Brico-Hams/bricohams-sdr/files/htdocs/plugins/receiver/antenna_switcher/README.md

---
layout: page
title: "OpenWebRX+ Receiver Plugin: Antenna Switcher"
permalink: /receiver/antenna_switcher
---

This is a `receiver` plugin to add antenna switching functionality for Raspberry Pi devices, providing logical levels on their GPIO ports that correspond to the user's antenna selection via buttons on the OWRX's front-end.

The antenna buttons appear in a collapsible **Antenna** section in the receiver panel after the back-end reports how many antennas are available. On OpenWebRX+ versions with `Plugins.addSection()`, the plugin uses the built-in section API. On older versions, it creates the same section itself. The selected antenna stays highlighted, and the section's open/closed state is kept when upgrading to the built-in section.

It consists of a **front-end** and **back-end** part.

The front-end is a standard OpenWebRX+ plugin and its installation does not differ from the standard way you [install plugins](https://0xaf.github.io/openwebrxplus-plugins/#beginner-quickstart):

## I. Front-end installation

### Load

Add this line in your `init.js` file:

```js
Plugins.load('https://0xaf.github.io/openwebrxplus-plugins/receiver/antenna_switcher/antenna_switcher.js');
```

#### Back-end URL

You probably don't want to change the default back-end instance URL, but if you do want to, you can do it from `init.js`, before or after the plugin loading, with:

`Plugins.antenna_switcher.API_URL = 'HOST:PORT/antenna_switch'`

### init.js

Learn how to [load plugins](https://0xaf.github.io/openwebrxplus-plugins/#beginner-quickstart).

## II. Back-end installation

The back-end installation script **is designed to work with OpenWebRX+ installed from the repository as a package**. You need to adjust it in case you want to use it inside a Docker container.

For the back-end, download and run the [install_backend.sh](install_backend.sh) Bash script **as root**:

```sh
wget 'https://0xaf.github.io/openwebrxplus-plugins/receiver/antenna_switcher/install_backend.sh'
chmod +x ./install_backend.sh
sudo ./install_backend.sh
```

The script will download and install the Flask back-end in a Python virtual environment located in `/opt/antenna_switcher`, so you don't have to worry about libraries messing up your system's default Python installation.

It will also create a systemd service file called `antenna_switcher`, then start and enable it.

The nginx configuration will be extended to provide reverse proxying from the OpenWebRX front-end *(default port 8073)* to the Flask back-end *(port 8075, binding only on 127.0.0.1)*.

## Configuration

Things like which GPIO pins to raise high when the corresponding button from the front-end is selected can be configured in `/opt/antenna_switcher/antenna_switcher.cfg`.

```sh
sudo ${EDITOR-nano} /opt/antenna_switcher/antenna_switcher.cfg
```

## Using the plugin

**You should open `http://1.2.3.4/` (nginx server) and NOT use the `:8073` (openwebrx) port in the URL. (Obviously you should replace 1.2.3.4 with the IP address of your OWRX receiver)**

## Code

[Github repo](https://github.com/0xAF/openwebrxplus-plugins/tree/main/receiver/antenna_switcher)
