Brico-Hams/bricohams-sdr/files/htdocs/plugins/receiver/doppler/README.md

---
layout: page
title: "OpenWebRX+ Receiver Plugin: Doppler"
permalink: /receiver/doppler
---

This `receiver` plugin will track the Doppler shift frequency of a chosen satellite. Useful for SSTV/Packet.

The Sat ID and TRACK/STOP controls appear in a collapsible **Doppler** section on OpenWebRX+ versions with `Plugins.addSection()`. Satellite Finder uses the built-in resizable plugin window when `Plugins.addWindow()` and `Plugins.toggleWindow()` are available. Older versions keep the original receiver row and Finder dialog. Closing Finder stops its automatic five-second refresh but does not stop active Doppler tracking.

This plugin started as a port of [work](https://github.com/studentkra/OpenWebRX-Doppler) by [Sergey Osipov](https://github.com/studentkra).  
Then I switched to [CelesTrak JSON API](https://celestrak.org/) and created Satellite Finder modal window.

## Preview

doppler Preview

## Usage

 1. Open the Satellite finder window to choose a satellite or enter the SatID if you know it.
 2. Click TRACK.

The Satellite Finder window will help you find a satellite and will give useful information on each satellite.
doppler1 FindSat

## Load

Add this line in your `init.js` file:

```js
Plugins.load('https://0xaf.github.io/openwebrxplus-plugins/receiver/doppler/doppler.js');
```

## init.js

Learn how to [load plugins](https://0xaf.github.io/openwebrxplus-plugins/#beginner-quickstart).

## Code

[Github repo](https://github.com/0xAF/openwebrxplus-plugins/tree/main/receiver/doppler)
