Brico-Hams/bricohams-sdr/files/htdocs/plugins/receiver/toggle_scannable/README.md

---
layout: page
title: "OpenWebRX+ Receiver Plugin: ToggleScannable"
permalink: /receiver/toggle_scannable
---

This `receiver` plugin will allow you to **toggle the scannable state of the bookmarks with right mouse button**.

The scanner (enabled by right-clicking the SQ button on the left of the SQL slider) will scan only the enabled bookmarks.

## Preview

toggle_scannable Preview

## Load

Add this line in your `init.js` file:

```js
Plugins.load('https://0xaf.github.io/openwebrxplus-plugins/receiver/toggle_scannable/toggle_scannable.js');
```

## init.js

Learn how to [load plugins](https://0xaf.github.io/openwebrxplus-plugins/#beginner-quickstart).
