Brico-Hams/bricohams-sdr/docs/REFERENCIAS.md

# Referencias

## Hardware
- HAT HackerGadgets RTL-SDR/LoRa/GPS/RTC: https://hackergadgets.com/products/rtl-sdr-lora-gps-rtc-hat-for-raspberry-pi
- Guía de la placa AIO de HackerGadgets (origen de los pines A VERIFICAR): https://hackergadgets.com/pages/hackergadgets-uconsole-rtl-sdr-lora-gps-rtc-usb-hub-all-in-one-extension-board-setup-guide
- Mini RTL-SDR HackerGadgets: https://hackergadgets.com/products/mini-rtl-sdr-dongle
- RTL-SDR Blog V3 (muestreo directo, bias-tee): https://www.rtl-sdr.com/v4/ · driver https://github.com/rtlsdrblog/rtl-sdr-blog
- Whadda/Velleman WPI408: https://www.velleman.eu/products/view/modulo-de-camara-con-2-luces-ir-para-raspberry-pi-wpi408/?id=459182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
- Bosch BMP280 / BME280: hojas de datos (compensación §3.12 / §4.2.3 y §8.1)
- LX-LBU2C: https://www.tastethecode.com/power-bank-from-scratch-with-18650-batteries-and-lx-lbu2c
- LilyGO T3 V1.6.1 (LoRa32 V2.1_1.6): firmware Meshtastic `tlora-v2-1-1_6`

## Software
- OpenWebRX+ (paquetes): https://luarvique.github.io/ppa/ · documentación https://fms.komkon.org/OWRX/
- Plugins 0xAF: https://0xaf.github.io/openwebrxplus-plugins/ · rig_skin: https://github.com/aganet/openwebrxplus-rig-skin
- Referencia de bandas: OpenWebRX+ de EA7CL, http://ea7cl.duckdns.org:8073/
- meshtasticd en Debian: https://meshtastic.org/docs/software/linux/installation/debian · flasher: https://flasher.meshtastic.org
- LoRa APRS iGate (CA2RXU): https://github.com/richonguzman/LoRa_APRS_iGate
- readsb y tar1090 (wiedehopf): https://github.com/wiedehopf/adsb-scripts · https://github.com/wiedehopf/tar1090
- AirNav RadarBox en Raspberry Pi: https://www.airnavradar.com/raspberry-pi/guide
  - Bookworm + MLAT: https://forum.airnavradar.com/index.php?topic=107991.0
  - **Trixie** (rbfeeder por apt y mlat-client compilado): https://forum.airnavradar.com/index.php?topic=109561.0
- MediaMTX (rpiCamera): https://github.com/bluenviron/mediamtx
- SDRplay API: https://www.sdrplay.com/api/
- AEMET OpenData: https://opendata.aemet.es · Open-Meteo: https://open-meteo.com · NOAA SWPC: https://www.swpc.noaa.gov

## Datos de la estación
- Repetidores: lista de EA5RCZ en los marcadores; Sierra Espuña ED5ZAN (BrandMeister ID 214520): https://ea5gvk-dmr.zigor.es/2019/09/10/ya-tenemos-nuevamente-repetidor-dmr-brandmeister-en-murcia-ed5zan-sierra-espuna/
- Estaciones AEMET: Archena 7158X, Molina de Segura (Los Valientes) 7237E, Alcantarilla Base Aérea 7228, Murcia 7178I
- Canales Meshtastic: QR de la red aportado por N0CALL (04/10/2026), en `MESH_CHANNEL_URL`

## Caja y alimentación (v2.2)
- OpenSCAD (modelo de la caja): https://openscad.org/documentation.html
- Raspberry Pi 5, alimentación y límite de corriente USB (5 V 5 A frente a 3 A): https://www.raspberrypi.com/documentation/computers/raspberry-pi.html#power-supply
- NetworkManager, `nmcli connection add` (prioridad de autoconexión): https://networkmanager.dev/docs/api/latest/nmcli.html

## v3.0 · Antenas, caja v3, ventilación, viento y lluvia
- **NEC2 (`nec2c`)**, motor de simulación de los modelos de `hardware/antenas/sim/`: paquete `nec2c` de Debian. Los documentos de diseño originales de la cúbica y del diplexor no se incluyen en esta distribución pública.
- **SDRplay RSPdx-R2:**
  - datasheet: https://sdrplay.com/wp-content/uploads/2026/06/RSPdxR2_Datasheet.pdf
  - ficha y precio: https://www.passion-radio.com/sdr-receivers/rsp-dx-935.html
- **HydraSDR RFOne** (24–1800 MHz, sin HF), datasheet: https://hydrasdr.com/downloads/HydraSDR_RFOne_Datasheet.pdf
- **OpenWebRX+:**
  - changelog (dispositivos admitidos: SDRplay, HydraSDR, RX888/sddc): https://github.com/luarvique/openwebrx/releases/
  - PPA: https://luarvique.github.io/ppa/
- **Raspberry Pi 5:**
  - PWM por hardware (overlay `pwm-2chan`, PWM0 del RP1 en GPIO12/13): https://gist.github.com/Gadgetoid/b92ad3db06ff8c264eef2abf0e09d569
  - foro: https://forums.raspberrypi.com/viewtopic.php?t=362319
- **Camera Module 3 (Wide NoIR, IMX708):** https://datasheets.raspberrypi.com/camera/camera-module-3-product-brief.pdf
- **Reolink RLC-510A** (cámara IP PoE con RTSP): https://reolink.com/product/rlc-510a/
- **MLA-30, manual de usuario:** https://www.tecsunradios.com.au/store/wp-content/uploads/2021/09/MLA-30-User-Instructions.pdf · https://www.passion-radio.com/hf/megaloop-968.html
- **Filtros NMRF FBP-433s:** https://www.amazon.co.uk/FBP-433s-433MHz-bandpass-filter-bandwidth/dp/B0FQ2KYRJG
- **Regleta Vansuny USB 3.0 con alimentador de 12 V 2 A (ASIN B09Q2YC87C):** https://www.amazon.es/Vansuny-Alimentacion-Externa-Ladron-Velocidad/dp/B09Q2YC87C
- **Estación WX LoRa de CA2RXU** (antes «APRS_WX_REPORT_STATION»): https://github.com/richonguzman/LoRa_APRS_Wx_Station
- **Sensores de viento RS485 Modbus** (registro de datos 0x0000, dirección en 0x07D0):
  - https://wiki.dfrobot.com/RS485_Wind_Direction_Transmitter_SKU_SEN0482
  - https://wiki.dfrobot.com/RS485_Wind_Speed_Transmitter_SKU_SEN0483
  - https://devices.esphome.io/devices/renke-rs-fxjt-n01-wind-direction/
- **Formato APRS WX** (`_CCC/SSSgGGGtTTTrRRRpPPPPPPPhHHbBBBBB`): APRS Protocol Reference 1.0.1, cap. 12.
- **Wifon FM** (97,5 MHz, Murcia): https://wifonfm.es/
- **Repetidores EA5:** lista EA5KGV del proyecto, distribuida en `data/repetidores_EA5KGV_zonaEA5.csv`.

## v3.1 · Trixie
- **Repositorio de OpenWebRX+ por versión:** `bookworm/` y `trixie/`, Release firmado. Página: https://luarvique.github.io/ppa/ · Repositorio: https://github.com/luarvique/ppa
- **meshtasticd en Debian 13:** https://meshtastic.org/docs/meshtasticd/installation/debian/
- **MediaMTX rpiCamera** (admite Trixie y Bookworm): https://mediamtx.org/docs/publish/raspberry-pi-cameras

## v4.0
- **Pico y MicroPython (rp2):** https://docs.micropython.org/en/latest/rp2/quickref.html · pinout: https://datasheets.raspberrypi.com/pico/Pico-R3-A4-Pinout.pdf · mpremote: https://docs.micropython.org/en/latest/reference/mpremote.html
- **Cámara Waveshare RPi Camera (F):** https://www.waveshare.com/wiki/RPi_Camera_(F) · cable de la Pi 5: https://www.raspberrypi.com/products/camera-cable/ · cámaras en la Pi 5: https://www.raspberrypi.com/documentation/accessories/camera.html
- **Estación WX LoRa de CA2RXU (pines y firmware):** https://github.com/richonguzman/LoRa_APRS_Wx_Station
- **Sensores de viento Renke RS485:** https://www.renkeer.com/
- **0xAF plugins (doppler, show_band_plan, listeners):** https://github.com/0xAF/openwebrxplus-plugins
- **Pases de satélites:** CelesTrak GP/OMM https://celestrak.org/NORAD/documentation/gp-data-formats.php · python-sgp4 https://pypi.org/project/sgp4/
- **SatDump:** https://github.com/SatDump/SatDump · METEOR-M LRPT 137,9 MHz.
- **FT2 / Decodium:** https://github.com/iu8lmc/Decodium-3.0-Codename-Raptor · https://ft2.it/
- **Indicativos:** HamQTH API https://www.hamqth.com/developers · RadioID https://radioid.net/api · QRZ XML https://www.qrz.com/docs/xml/current_spec.html
- **GeoIP:** DB-IP IP to City Lite (CC BY 4.0) https://db-ip.com/db/download/ip-to-city-lite — la web lleva la atribución.
- **Telegram Bot API:** https://core.telegram.org/bots/api
- **Mensajes de clientes de OpenWebRX+ por MQTT:** https://github.com/luarvique/openwebrx
- **https:** Let's Encrypt https://letsencrypt.org/docs/ · certbot https://eff-certbot.readthedocs.io/ · DuckDNS https://www.duckdns.org/
- **Privacidad y registros de visitas:** AEPD https://www.aepd.es/
- **CB 27 MHz (CEPT, 40 canales):** https://www.fediea.org/ · **PMR446:** CEPT ECC/DEC(15)05.
- **Radio Club Región de Murcia (RU-75, frecuencias del club):** https://www.ea5rcz.es/
- **Aviación:** ENAIRE AIP España https://aip.enaire.es/AIP/
- **Marina:** Salvamento Marítimo https://www.salvamentomaritimo.es/ · canales VHF marinos ITU-R M.1084.
- **FM y DAB+:** https://radiomap.eu/es/murcia · cobertura DAB https://avancedigital.mineco.gob.es/
- **Secreto de las comunicaciones** (por qué no hay radiotaxis ni TETRA de emergencias): Ley 11/2022 General de Telecomunicaciones, art. 60 · CE art. 18.3.

## v4.2
- **OpenWebRX+ (código fuente, rutas, AudioEngine, datos):** https://github.com/luarvique/openwebrx — `owrx/http.py` (rutas con usuario), `htdocs/lib/AudioEngine.js` (audioNode → gainNode), `owrx/config/core.py` (`data_directory`), `htdocs/lib/Plugins.js` (Plugins.load, addButton).
- **Repositorios de OpenWebRX+ por sistema:** https://luarvique.github.io/ppa/ (bullseye → `debian`, bookworm, trixie, jammy → `ubuntu`, noble).
- **Web Audio API:** https://developer.mozilla.org/es/docs/Web/API/Web_Audio_API · BiquadFilterNode https://developer.mozilla.org/en-US/docs/Web/API/BiquadFilterNode · DynamicsCompressorNode https://developer.mozilla.org/en-US/docs/Web/API/DynamicsCompressorNode · AnalyserNode https://developer.mozilla.org/en-US/docs/Web/API/AnalyserNode
- **Plugins de 0xAF (sin plugins de audio):** https://github.com/0xAF/openwebrxplus-plugins
- **nginx:** `proxy_cookie_flags` https://nginx.org/en/docs/http/ngx_http_proxy_module.html#proxy_cookie_flags · `listen … http2` https://nginx.org/en/docs/http/ngx_http_v2_module.html
- **HamQTH API v2** (login con token, `/api/v2/callbook/{call}`, parámetro `app`): https://www.hamqth.com/developers.php
- **systemd EnvironmentFile (comillas):** https://www.freedesktop.org/software/systemd/man/latest/systemd.exec.html#EnvironmentFile=
- **dpkg:** `/var/lib/dpkg/status`, `/var/lib/dpkg/info/<paquete>.md5sums`, `/var/lib/apt/extended_states` (paquetes automáticos): https://manpages.debian.org/dpkg
- **openssl enc (AES-256-CBC + PBKDF2):** https://docs.openssl.org/master/man1/openssl-enc/
- **Playwright (pruebas en Chromium real):** https://playwright.dev/python/

## v4.4
- **nftables** (familia inet, hook input, sets con intervalos): https://wiki.nftables.org/wiki-nftables/index.php/Quick_reference-nftables_in_10_minutes
- **OpenSSH sshd_config** (`PermitRootLogin`, `PasswordAuthentication`, `MaxAuthTries`, `sshd -T`): https://man.openbsd.org/sshd_config
- **fail2ban** (jails `sshd`, `recidive`, backend systemd): https://github.com/fail2ban/fail2ban
- **nginx limit_req / server_tokens:** https://nginx.org/en/docs/http/ngx_http_limit_req_module.html · https://nginx.org/en/docs/http/ngx_http_core_module.html#server_tokens
- **unattended-upgrades en Debian:** https://wiki.debian.org/UnattendedUpgrades
- **Endurecimiento del núcleo (sysctl):** https://www.kernel.org/doc/Documentation/networking/ip-sysctl.txt
- **OpenWebRX+ `/status.json`** (lo que publica el receptor: nombre, admin, GPS, perfiles): https://github.com/luarvique/openwebrx (owrx/controllers/status.py)

## v4.3
- **Imagen Docker de OpenWebRX+** (volúmenes `/etc/openwebrx`, `/var/lib/openwebrx`, `htdocs/plugins`; `--device /dev/bus/usb`, `--tmpfs /tmp`, variables `OPENWEBRX_ADMIN_*`): https://hub.docker.com/r/slechev/openwebrxplus · softmbe https://hub.docker.com/r/slechev/openwebrxplus-softmbe · constructor y `run.sh` (siembra de `/etc` y `/var`, admin, `FORWARD_LOCALPORT_*`): https://github.com/0xAF/openwebrxplus-docker-builder
- **Docker Compose** (formato 2.4, `device_cgroup_rules`, `network_mode`): https://docs.docker.com/reference/compose-file/ · grupo de dispositivos USB 189: https://www.kernel.org/doc/Documentation/admin-guide/devices.txt
- **Locator Maidenhead:** https://en.wikipedia.org/wiki/Maidenhead_Locator_System
- **OurAirports** (aeropuertos y frecuencias, dominio público): https://github.com/davidmegginson/ourairports-data
- **Canales de 8,33 kHz** (nombre del canal frente a frecuencia): EUROCONTROL https://www.eurocontrol.int/concept/833-khz-voice-channel-spacing
- **AEMET OpenData** (observación convencional, todas las estaciones): https://opendata.aemet.es/dist/index.html · lista de indicativos de estaciones convencionales usada para validar: paquete python-aemet (MIT) https://pypi.org/project/python-aemet/
- **maps.fmdx.org** (emisores de FM por QTH, datos de FMLIST) tal como lo usa FM-DX Webserver: https://github.com/NoobishSVK/fm-dx-webserver/blob/main/server/tx_search.js · FMLIST https://www.fmlist.org/
- **NAVTEX de España** (D/W A Coruña, G/T Tarifa, X/M Cabo de la Nao, I/A Las Palmas): https://en.wikipedia.org/wiki/List_of_Navtex_stations · Salvamento Marítimo https://www.salvamentomaritimo.es/mejora-tu-seguridad/control-y-servicios-en-la-mar/navtex-y-avisos-a-navegantes
- **Canales VHF marinos** (ITU-R M.1084): https://www.itu.int/rec/R-REC-M.1084 · Puertos del Estado (puertos de interés general): https://www.puertos.es/

## v4.5 · LoRa APRS, Meshtastic y OpenWebRX+
- LoRa APRS iGate, CA2RXU (base del port al RAK4631, GPL-3.0), revisión 9314bf1 del 07/10/2026: https://github.com/richonguzman/LoRa_APRS_iGate
- RAKwireless RAK4631 / RAK4630(L) 433 MHz y base RAK19007 (30 × 60 mm, IO2 = 3V3_S): https://docs.rakwireless.com/product-categories/wisblock/rak19007/datasheet/
- BSP Arduino de RAKwireless para nRF52 (1.3.3): https://github.com/RAKWireless/RAK-nRF52-Arduino
- RadioLib 7.6.0 (SX1262): https://github.com/jgromes/RadioLib
- OpenWebRX+ 1.2.126: suscriptor MQTT (owrx/mqtt.py: «+/APRS», «+/Meshtastic», «+/CLIENT»), mapa de Meshtastic (owrx/meshtastic.py) y modos LoRa (csdr/chain/lora.py): https://github.com/luarvique/openwebrx
- Formato de las URL de canales de Meshtastic (ChannelSet, apponly.proto): https://github.com/meshtastic/protobufs
- Especificación APRS 1.01 (posiciones comprimidas, ambigüedad, objetos, mensajes y terceros): http://www.aprs.org/doc/APRS101.PDF
- Reglas de iGate de APRS-IS (q-constructs, TCPIP/NOGATE/RFONLY): https://www.aprs-is.net/IGating.aspx
- Código Penal español, art. 197 bis (acceso no autorizado a sistemas), citado en el aviso del banner SSH.
