Brico-Hams/bricohams-sdr/docs/CANALES_Y_FRECUENCIAS.md

# Canales y frecuencias de la estación

Generado por `tools/canales.py` a partir de `data/marcadores_v4.json` y `files/openwebrx/bookmarks.json`.
Todo está como marcador en la web: pulsa encima para sintonizar. En los repetidores, la entrada y el subtono van en
la descripción (OpenWebRX no tiene campo de subtono y para escuchar no hace falta).

> **No se incluyen comunicaciones privadas:** ni radiotaxis, ni TETRA de emergencias o policía, ni servicios de
> seguridad. En España escucharlas o difundirlas puede vulnerar el secreto de las comunicaciones (Ley 11/2022 General
> de Telecomunicaciones), y un receptor público en Internet las estaría retransmitiendo. El perfil «TETRA 420–422,4»
> sigue disponible solo como exploración de la banda.

## Radio Club Región de Murcia (EA5RCZ)

| MHz | Nombre | Modo | Notas |
|---|---|---|---|
| 27,325 | CB 32 · 27.325 · Radio Club Región de Murcia | FM | Banda Ciudadana canal 32 (27,325 MHz) · FM 4 W, AM 4 W, BLU 12 W PEP · Radio Club Región de Murcia (AM / FM / USB) |
| 145,325 | Radio Club R. Murcia · VHF 145.325 | FM | Frecuencia de encuentro VHF del Radio Club Región de Murcia (FM simplex) |
| 430,325 | Radio Club R. Murcia · UHF 430.325 | FM | Frecuencia de encuentro UHF del Radio Club Región de Murcia (FM simplex) |
| 438,775 | RU-75 ED5YBF · Radio Club Región de Murcia | FM | Repetidor del Radio Club Región de Murcia en Sierra de Carrascoy (IM97IU), 15 W, Big Signal CQ-70. Entrada 431,175 MHz (−7,6 MHz) · Subtono 77,0 Hz para abrirlo (para escuchar no hace falta) |
| 446,05625 | PMR 5 · 446,05625 · Radio Club R. Murcia | FM | PMR446 canal 5 · FM analógico 12,5 kHz · las emisoras DMR446 usan la misma portadora · Radio Club Región de Murcia |

Fuente: https://ea5rcz.es/ed5ybf/ · https://en.wikipedia.org/wiki/PMR446 · https://www.fediea.org/legislacb/oetu10332017-cb.php

## Banda Ciudadana 27 MHz (CEPT, Orden ETU/1033/2017)

| MHz | Nombre | Modo | Notas |
|---|---|---|---|
| 26,965 | CB 01 | FM | Banda Ciudadana canal 1 (26,965 MHz) · FM 4 W, AM 4 W, BLU 12 W PEP |
| 26,975 | CB 02 | FM | Banda Ciudadana canal 2 (26,975 MHz) · FM 4 W, AM 4 W, BLU 12 W PEP |
| 26,985 | CB 03 | FM | Banda Ciudadana canal 3 (26,985 MHz) · FM 4 W, AM 4 W, BLU 12 W PEP |
| 27,005 | CB 04 | FM | Banda Ciudadana canal 4 (27,005 MHz) · FM 4 W, AM 4 W, BLU 12 W PEP |
| 27,015 | CB 05 | FM | Banda Ciudadana canal 5 (27,015 MHz) · FM 4 W, AM 4 W, BLU 12 W PEP |
| 27,025 | CB 06 | FM | Banda Ciudadana canal 6 (27,025 MHz) · FM 4 W, AM 4 W, BLU 12 W PEP |
| 27,035 | CB 07 | FM | Banda Ciudadana canal 7 (27,035 MHz) · FM 4 W, AM 4 W, BLU 12 W PEP |
| 27,055 | CB 08 | FM | Banda Ciudadana canal 8 (27,055 MHz) · FM 4 W, AM 4 W, BLU 12 W PEP |
| 27,065 | CB 09 · EMERGENCIAS | FM | Banda Ciudadana canal 9 (27,065 MHz) · FM 4 W, AM 4 W, BLU 12 W PEP · EMERGENCIAS (canal legal de socorro) |
| 27,075 | CB 10 | FM | Banda Ciudadana canal 10 (27,075 MHz) · FM 4 W, AM 4 W, BLU 12 W PEP |
| 27,085 | CB 11 | FM | Banda Ciudadana canal 11 (27,085 MHz) · FM 4 W, AM 4 W, BLU 12 W PEP |
| 27,105 | CB 12 | FM | Banda Ciudadana canal 12 (27,105 MHz) · FM 4 W, AM 4 W, BLU 12 W PEP |
| 27,115 | CB 13 | FM | Banda Ciudadana canal 13 (27,115 MHz) · FM 4 W, AM 4 W, BLU 12 W PEP |
| 27,125 | CB 14 | FM | Banda Ciudadana canal 14 (27,125 MHz) · FM 4 W, AM 4 W, BLU 12 W PEP |
| 27,135 | CB 15 | FM | Banda Ciudadana canal 15 (27,135 MHz) · FM 4 W, AM 4 W, BLU 12 W PEP |
| 27,155 | CB 16 | FM | Banda Ciudadana canal 16 (27,155 MHz) · FM 4 W, AM 4 W, BLU 12 W PEP |
| 27,165 | CB 17 | FM | Banda Ciudadana canal 17 (27,165 MHz) · FM 4 W, AM 4 W, BLU 12 W PEP |
| 27,175 | CB 18 | FM | Banda Ciudadana canal 18 (27,175 MHz) · FM 4 W, AM 4 W, BLU 12 W PEP |
| 27,185 | CB 19 · carretera / camioneros | FM | Banda Ciudadana canal 19 (27,185 MHz) · FM 4 W, AM 4 W, BLU 12 W PEP · carretera / camioneros (costumbre) |
| 27,205 | CB 20 | FM | Banda Ciudadana canal 20 (27,205 MHz) · FM 4 W, AM 4 W, BLU 12 W PEP |
| 27,215 | CB 21 | FM | Banda Ciudadana canal 21 (27,215 MHz) · FM 4 W, AM 4 W, BLU 12 W PEP |
| 27,225 | CB 22 | FM | Banda Ciudadana canal 22 (27,225 MHz) · FM 4 W, AM 4 W, BLU 12 W PEP |
| 27,235 | CB 24 | FM | Banda Ciudadana canal 24 (27,235 MHz) · FM 4 W, AM 4 W, BLU 12 W PEP |
| 27,245 | CB 25 | FM | Banda Ciudadana canal 25 (27,245 MHz) · FM 4 W, AM 4 W, BLU 12 W PEP |
| 27,255 | CB 23 | FM | Banda Ciudadana canal 23 (27,255 MHz) · FM 4 W, AM 4 W, BLU 12 W PEP |
| 27,265 | CB 26 | FM | Banda Ciudadana canal 26 (27,265 MHz) · FM 4 W, AM 4 W, BLU 12 W PEP |
| 27,275 | CB 27 | FM | Banda Ciudadana canal 27 (27,275 MHz) · FM 4 W, AM 4 W, BLU 12 W PEP |
| 27,285 | CB 28 | FM | Banda Ciudadana canal 28 (27,285 MHz) · FM 4 W, AM 4 W, BLU 12 W PEP |
| 27,295 | CB 29 | FM | Banda Ciudadana canal 29 (27,295 MHz) · FM 4 W, AM 4 W, BLU 12 W PEP |
| 27,305 | CB 30 | FM | Banda Ciudadana canal 30 (27,305 MHz) · FM 4 W, AM 4 W, BLU 12 W PEP |
| 27,315 | CB 31 | FM | Banda Ciudadana canal 31 (27,315 MHz) · FM 4 W, AM 4 W, BLU 12 W PEP |
| 27,335 | CB 33 | FM | Banda Ciudadana canal 33 (27,335 MHz) · FM 4 W, AM 4 W, BLU 12 W PEP |
| 27,345 | CB 34 | FM | Banda Ciudadana canal 34 (27,345 MHz) · FM 4 W, AM 4 W, BLU 12 W PEP |
| 27,355 | CB 35 | FM | Banda Ciudadana canal 35 (27,355 MHz) · FM 4 W, AM 4 W, BLU 12 W PEP |
| 27,365 | CB 36 | FM | Banda Ciudadana canal 36 (27,365 MHz) · FM 4 W, AM 4 W, BLU 12 W PEP |
| 27,375 | CB 37 | FM | Banda Ciudadana canal 37 (27,375 MHz) · FM 4 W, AM 4 W, BLU 12 W PEP |
| 27,385 | CB 38 | FM | Banda Ciudadana canal 38 (27,385 MHz) · FM 4 W, AM 4 W, BLU 12 W PEP |
| 27,395 | CB 39 | FM | Banda Ciudadana canal 39 (27,395 MHz) · FM 4 W, AM 4 W, BLU 12 W PEP |
| 27,405 | CB 40 | FM | Banda Ciudadana canal 40 (27,405 MHz) · FM 4 W, AM 4 W, BLU 12 W PEP |

Fuente: https://www.fediea.org/legislacb/oetu10332017-cb.php

## PMR446 (16 canales, 500 mW)

| MHz | Nombre | Modo | Notas |
|---|---|---|---|
| 446,00625 | PMR 1 · 446,00625 | FM | PMR446 canal 1 · FM analógico 12,5 kHz · las emisoras DMR446 usan la misma portadora |
| 446,01875 | PMR 2 · 446,01875 | FM | PMR446 canal 2 · FM analógico 12,5 kHz · las emisoras DMR446 usan la misma portadora |
| 446,03125 | PMR 3 · 446,03125 | FM | PMR446 canal 3 · FM analógico 12,5 kHz · las emisoras DMR446 usan la misma portadora |
| 446,04375 | PMR 4 · 446,04375 | FM | PMR446 canal 4 · FM analógico 12,5 kHz · las emisoras DMR446 usan la misma portadora |
| 446,06875 | PMR 6 · 446,06875 | FM | PMR446 canal 6 · FM analógico 12,5 kHz · las emisoras DMR446 usan la misma portadora |
| 446,08125 | PMR 7 · 446,08125 | FM | PMR446 canal 7 · FM analógico 12,5 kHz · las emisoras DMR446 usan la misma portadora |
| 446,09375 | PMR 8 · 446,09375 | FM | PMR446 canal 8 · FM analógico 12,5 kHz · las emisoras DMR446 usan la misma portadora |
| 446,10625 | PMR 9 · 446,10625 | FM | PMR446 canal 9 · FM analógico 12,5 kHz · las emisoras DMR446 usan la misma portadora · llamada digital DMR446 |
| 446,11875 | PMR 10 · 446,11875 | FM | PMR446 canal 10 · FM analógico 12,5 kHz · las emisoras DMR446 usan la misma portadora |
| 446,13125 | PMR 11 · 446,13125 | FM | PMR446 canal 11 · FM analógico 12,5 kHz · las emisoras DMR446 usan la misma portadora |
| 446,14375 | PMR 12 · 446,14375 | FM | PMR446 canal 12 · FM analógico 12,5 kHz · las emisoras DMR446 usan la misma portadora |
| 446,15625 | PMR 13 · 446,15625 | FM | PMR446 canal 13 · FM analógico 12,5 kHz · las emisoras DMR446 usan la misma portadora |
| 446,16875 | PMR 14 · 446,16875 | FM | PMR446 canal 14 · FM analógico 12,5 kHz · las emisoras DMR446 usan la misma portadora |
| 446,18125 | PMR 15 · 446,18125 | FM | PMR446 canal 15 · FM analógico 12,5 kHz · las emisoras DMR446 usan la misma portadora |
| 446,19375 | PMR 16 · 446,19375 | FM | PMR446 canal 16 · FM analógico 12,5 kHz · las emisoras DMR446 usan la misma portadora |

Fuente: https://en.wikipedia.org/wiki/PMR446

## Aviación (AIP ENAIRE)

| MHz | Nombre | Modo | Notas |
|---|---|---|---|
| 118,15 | LEAL Alicante TWR | AM | Torre de Alicante-Elche (canal 118,155) |
| 118,8 | Valencia Control (APP Alicante) | AM | Aproximación de Alicante / Valencia Control |
| 119,85 | LEAL Alicante DEL | AM | Autorizaciones de Alicante (canal 119,855) |
| 120,075 | LEAL Alicante ATIS | AM | ATIS de Alicante (canal 120,080) |
| 120,4 | Valencia Control (APP Alicante) 2 | AM | Aproximación de Alicante / Valencia Control |
| 121,325 | LEMI Murcia-Corvera TWR | AM | Torre del Aeropuerto Internacional Región de Murcia (canal 8,33 kHz 121,330) |
| 121,5 | 121.500 Emergencia | AM | Frecuencia internacional de emergencia (guardia) |
| 121,6 | LELC San Javier GND | AM | Rodadura de San Javier |
| 121,75 | LEMI Murcia-Corvera GND | AM | Rodadura (GMC) de Corvera (canal 121,755) |
| 124,425 | LELC San Javier AGA TWR | AM | Torre de San Javier (Academia General del Aire) |
| 125,025 | San Javier APP respaldo | AM | Aproximación San Javier, frecuencia de respaldo |
| 128,605 | LELC San Javier ATIS | AM | ATIS de San Javier (H24) |
| 130,3 | San Javier APP | AM | Aproximación San Javier (civil/militar) para LEMI |
| 130,65 | LEAL Alicante GND | AM | Rodadura de Alicante (canal 130,655) |

Fuente: https://aip.enaire.es

## Marítimo VHF (Cartagena · Mazarrón)

| MHz | Nombre | Modo | Notas |
|---|---|---|---|
| 156,3 | Canal 6 · Cartagena SAR | FM | Canal simplex asociado a Cartagena (trabajo SAR) |
| 156,45 | Canal 9 · Puerto de Mazarrón | FM | Puerto deportivo de Mazarrón |
| 156,5 | Canal 10 · CCS Cartagena (meteo) | FM | Salvamento Marítimo Cartagena: boletines meteorológicos 01:15, 05:15, 09:15, 13:15, 17:15 y 21:15 UTC (anunciados en el 16) |
| 156,6 | Canal 12 · Prácticos Cartagena | FM | Corporación de Prácticos del Puerto de Cartagena (12/13/14/16). Operaciones portuarias |
| 156,625 | Canal 72 · Cabo de Gata (costera) | FM | Estación costera de Cabo de Gata |
| 156,65 | Canal 13 · puente a puente | FM | Seguridad de la navegación entre buques |
| 156,7 | Canal 14 · Puerto de Cartagena | FM | Operaciones portuarias de Cartagena (prácticos / control) |
| 156,725 | Canal 74 · Cabo la Nao (costera) | FM | Estación costera de Cabo la Nao |
| 156,8 | Canal 16 · socorro | FM | Socorro, seguridad y llamada. Escucha permanente |
| 160,875 | Canal 65 · Cartagena Radio (costera) | FM | Estación costera de Cartagena, dúplex (barco 156,275 / costera 160,875) |

Fuente: https://www.transportes.gob.es/marina-mercante

## FM comercial (Murcia)

| MHz | Nombre | Modo | Notas |
|---|---|---|---|
| 91 | 91.0 Radio María (Murcia) | FM ancha | Radio María · emisor Cabezo Cortado (Molina de Segura) |

Fuente: https://radiomap.eu/es/murcia

## DAB+ (Banda III)

| MHz | Nombre | Modo | Notas |
|---|---|---|---|
| 199,36 | DAB+ 8C · Cartagena | DAB+ | Emisor de Cartagena del mismo grupo (Activa, Bikini, Flamenca, MuyBuena…) |
| 202,928 | DAB+ 9A · Murcia local | DAB+ | Múltiple local (Carrascoy): Activa FM, Bikini FM, MuyBuena, La Flamenca, La Mega, Corazón FM, Gold FM, RockStar, Sol Latino… |
| 206,352 | DAB+ 9C · MF-I estatal | DAB+ | Bloque asignado a Murcia para la red estatal MF-I (si no hay señal, aún no emite) |

Fuente: https://radiomap.eu/es/murcia

## Modos digitales (dial, USB)

| MHz | Nombre | Modo | Notas |
|---|---|---|---|
| 1,8366 | WSPR 160m | WSPR | WSPR · dial 1,8366 MHz (USB). Balizas de baja potencia |
| 1,84 | FT8 160m | FT8 | FT8 · frecuencia de dial 1,84 MHz (USB). Ciclo 15 s |
| 1,84 | FT4 160m | FT4 | FT4 · dial 1,84 MHz (USB). Ciclo 7,5 s |
| 1,842 | JS8 160m | JS8 | JS8Call · dial 1,842 MHz (USB) |
| 1,843 | FT2 160m | USB | FT2 (IU8LMC, Decodium) · dial 1,843 MHz (USB), ciclo 3,75 s. Con el decodificador FT2 instalado, elige el modo FT2 |
| 3,5686 | WSPR 80m | WSPR | WSPR · dial 3,5686 MHz (USB). Balizas de baja potencia |
| 3,573 | FT8 80m | FT8 | FT8 · frecuencia de dial 3,573 MHz (USB). Ciclo 15 s |
| 3,575 | FT4 80m | FT4 | FT4 · dial 3,575 MHz (USB). Ciclo 7,5 s |
| 3,578 | JS8 80m | JS8 | JS8Call · dial 3,578 MHz (USB) |
| 3,578 | FT2 80m | USB | FT2 (IU8LMC, Decodium) · dial 3,578 MHz (USB), ciclo 3,75 s. Con el decodificador FT2 instalado, elige el modo FT2 |
| 5,357 | FT8 60m | FT8 | FT8 · frecuencia de dial 5,357 MHz (USB). Ciclo 15 s |
| 5,357 | FT4 60m | FT4 | FT4 · dial 5,357 MHz (USB). Ciclo 7,5 s |
| 5,36 | FT2 60m | USB | FT2 (IU8LMC, Decodium) · dial 5,36 MHz (USB), ciclo 3,75 s. Con el decodificador FT2 instalado, elige el modo FT2 |
| 5,3647 | WSPR 60m | WSPR | WSPR · dial 5,3647 MHz (USB). Balizas de baja potencia |
| 7,0386 | WSPR 40m | WSPR | WSPR · dial 7,0386 MHz (USB). Balizas de baja potencia |
| 7,0475 | FT4 40m | FT4 | FT4 · dial 7,0475 MHz (USB). Ciclo 7,5 s |
| 7,052 | FT2 40m | USB | FT2 (IU8LMC, Decodium) · dial 7,052 MHz (USB), ciclo 3,75 s. Con el decodificador FT2 instalado, elige el modo FT2 |
| 7,074 | FT8 40m | FT8 | FT8 · frecuencia de dial 7,074 MHz (USB). Ciclo 15 s |
| 7,078 | JS8 40m | JS8 | JS8Call · dial 7,078 MHz (USB) |
| 10,13 | JS8 30m | JS8 | JS8Call · dial 10,13 MHz (USB) |
| 10,136 | FT8 30m | FT8 | FT8 · frecuencia de dial 10,136 MHz (USB). Ciclo 15 s |
| 10,1387 | WSPR 30m | WSPR | WSPR · dial 10,1387 MHz (USB). Balizas de baja potencia |
| 10,14 | FT4 30m | FT4 | FT4 · dial 10,14 MHz (USB). Ciclo 7,5 s |
| 10,144 | FT2 30m | USB | FT2 (IU8LMC, Decodium) · dial 10,144 MHz (USB), ciclo 3,75 s. Con el decodificador FT2 instalado, elige el modo FT2 |
| 14,074 | FT8 20m | FT8 | FT8 · frecuencia de dial 14,074 MHz (USB). Ciclo 15 s |
| 14,078 | JS8 20m | JS8 | JS8Call · dial 14,078 MHz (USB) |
| 14,08 | FT4 20m | FT4 | FT4 · dial 14,08 MHz (USB). Ciclo 7,5 s |
| 14,084 | FT2 20m | USB | FT2 (IU8LMC, Decodium) · dial 14,084 MHz (USB), ciclo 3,75 s. Con el decodificador FT2 instalado, elige el modo FT2 |
| 14,0956 | WSPR 20m | WSPR | WSPR · dial 14,0956 MHz (USB). Balizas de baja potencia |
| 18,1 | FT8 17m | FT8 | FT8 · frecuencia de dial 18,1 MHz (USB). Ciclo 15 s |
| 18,104 | FT4 17m | FT4 | FT4 · dial 18,104 MHz (USB). Ciclo 7,5 s |
| 18,104 | JS8 17m | JS8 | JS8Call · dial 18,104 MHz (USB) |
| 18,1046 | WSPR 17m | WSPR | WSPR · dial 18,1046 MHz (USB). Balizas de baja potencia |
| 18,108 | FT2 17m | USB | FT2 (IU8LMC, Decodium) · dial 18,108 MHz (USB), ciclo 3,75 s. Con el decodificador FT2 instalado, elige el modo FT2 |
| 21,074 | FT8 15m | FT8 | FT8 · frecuencia de dial 21,074 MHz (USB). Ciclo 15 s |
| 21,078 | JS8 15m | JS8 | JS8Call · dial 21,078 MHz (USB) |
| 21,0946 | WSPR 15m | WSPR | WSPR · dial 21,0946 MHz (USB). Balizas de baja potencia |
| 21,14 | FT4 15m | FT4 | FT4 · dial 21,14 MHz (USB). Ciclo 7,5 s |
| 21,144 | FT2 15m | USB | FT2 (IU8LMC, Decodium) · dial 21,144 MHz (USB), ciclo 3,75 s. Con el decodificador FT2 instalado, elige el modo FT2 |
| 24,915 | FT8 12m | FT8 | FT8 · frecuencia de dial 24,915 MHz (USB). Ciclo 15 s |
| 24,919 | FT4 12m | FT4 | FT4 · dial 24,919 MHz (USB). Ciclo 7,5 s |
| 24,922 | JS8 12m | JS8 | JS8Call · dial 24,922 MHz (USB) |
| 24,923 | FT2 12m | USB | FT2 (IU8LMC, Decodium) · dial 24,923 MHz (USB), ciclo 3,75 s. Con el decodificador FT2 instalado, elige el modo FT2 |
| 24,9246 | WSPR 12m | WSPR | WSPR · dial 24,9246 MHz (USB). Balizas de baja potencia |
| 28,074 | FT8 10m | FT8 | FT8 · frecuencia de dial 28,074 MHz (USB). Ciclo 15 s |
| 28,078 | JS8 10m | JS8 | JS8Call · dial 28,078 MHz (USB) |
| 28,1246 | WSPR 10m | WSPR | WSPR · dial 28,1246 MHz (USB). Balizas de baja potencia |
| 28,18 | FT4 10m | FT4 | FT4 · dial 28,18 MHz (USB). Ciclo 7,5 s |
| 28,184 | FT2 10m | USB | FT2 (IU8LMC, Decodium) · dial 28,184 MHz (USB), ciclo 3,75 s. Con el decodificador FT2 instalado, elige el modo FT2 |
| 50,293 | WSPR 6m | WSPR | WSPR · dial 50,293 MHz (USB). Balizas de baja potencia |
| 50,313 | FT8 6m | FT8 | FT8 · frecuencia de dial 50,313 MHz (USB). Ciclo 15 s |
| 50,318 | FT4 6m | FT4 | FT4 · dial 50,318 MHz (USB). Ciclo 7,5 s |
| 50,318 | JS8 6m | JS8 | JS8Call · dial 50,318 MHz (USB) |
| 144,17 | FT4 2m | FT4 | FT4 · dial 144,17 MHz (USB). Ciclo 7,5 s |
| 144,174 | FT8 2m | FT8 | FT8 · frecuencia de dial 144,174 MHz (USB). Ciclo 15 s |
| 144,489 | WSPR 2m | WSPR | WSPR · dial 144,489 MHz (USB). Balizas de baja potencia |

Fuente: https://www.ft2.it/

## Satélites

| MHz | Nombre | Modo | Notas |
|---|---|---|---|
| 137,1 | METEOR LRPT (alterna) | FM | Frecuencia alternativa LRPT de los Meteor (137,100) |
| 137,9 | METEOR M2-3 / M2-4 LRPT | FM | Meteor-M2-3 (57166) y M2-4 (59051): imágenes LRPT 72k en 137,900 (decodificador LRPT) |
| 145,8 | ISS Voz/SSTV | FM | ISS (NORAD 25544): voz ARISS y SSTV (eventos). Activa con el plugin DOP el seguimiento Doppler |
| 145,825 | ISS APRS | APRS 1200 | ISS digipeater APRS 145,825 |
| 145,925 | TO-108 (CAS-6) | USB | TO-108 (44881): transpondedor 145,915–145,935 USB; baliza 145,910 CW |
| 145,96 | AO-91 | FM | AO-91 (43017): bajada 145,960 FM (solo de día; batería degradada) |
| 435,31 | IO-117 GreenCube | USB | IO-117 GreenCube (53106): digipeater GMSK 435,310 |
| 435,605 | RS-44 baliza | CW | Baliza CW de RS-44 |
| 435,64 | RS-44 lineal | USB | RS-44 (44909): transpondedor lineal inversor 435,610–435,670 USB/CW |
| 436,795 | SO-50 | FM | SO-50 (27607): bajada 436,795 FM (subida 145,850, tono 67 Hz) |
| 437,8 | ISS Repetidor | FM | Repetidor FM de la ISS: bajada 437,800 (subida 145,990, tono 67 Hz) |

Fuente: https://www.amsat.org/status/

## Repetidores (zona EA5)

| Salida MHz | Nombre | Entrada y subtono |
|---|---|---|
| 144,825 | EC5RCA (simplex) | Subtono 82,5 Hz para abrirlo (para escuchar no hace falta) · lista EA5KGV, posición 179 |
| 145,2875 | EA5ABE (simplex) | Subtono 77,0 Hz para abrirlo (para escuchar no hace falta) · lista EA5KGV, posición 174 |
| 145,3875 | EA5HTK (simplex) | Subtono 77,0 Hz para abrirlo (para escuchar no hace falta) · lista EA5KGV, posición 176 |
| 145,575 | ED5YAM | Entrada 144,975 MHz (-0,6 MHz) · Subtono 118,8 Hz para abrirlo (para escuchar no hace falta) · lista EA5KGV, posición 398 |
| 145,6 | R0 Sierra Espuña ED5YAK | Entrada 145.000 · Tono 77.0 [EA5KGV ED5YAK: Entrada 145 MHz (-0,6 MHz) · Subtono 77,0 Hz para abrirlo (para escuchar no hace falta)] |
| 145,625 | R1 Águilas ED5YAT | Entrada 145.025 · Tono 127.3 [EA5KGV también ED5YAP Valencia: Entrada 145,025 MHz (-0,6 MHz) · Subtono 88,5 Hz para abrirlo (para escuchar no hace falta)] [EA5KGV ED5YAT: Entrada 145,025 MHz (-0,6 MHz) · Subtono 114,8 Hz para abrirlo (para escuchar no hace falta)] |
| 145,65 | R2 ED5YAG Alicante | Entrada 145,05 MHz (-0,6 MHz) · Subtono 88,5 Hz para abrirlo (para escuchar no hace falta) · lista EA5KGV, posición 35 [EA5KGV también ED5YAN: Entrada 145,05 MHz (-0,6 MHz) · Subtono 123,0 Hz para abrirlo (para escuchar no hace falta)] |
| 145,675 | R3 ED5YAW Albacete | Entrada 145,075 MHz (-0,6 MHz) · Subtono 123,0 Hz para abrirlo (para escuchar no hace falta) · lista EA5KGV, posición 50 |
| 145,6875 | R3X ED5ZAC | Entrada 145,0875 MHz (-0,6 MHz) · Sin subtono · lista EA5KGV, posición 172 |
| 145,7 | R4 ED5YAA | Entrada 145,1 MHz (-0,6 MHz) · Subtono 88,5 Hz para abrirlo (para escuchar no hace falta) · lista EA5KGV, posición 180 [EA5KGV también ED5YAF: Entrada 145,1 MHz (-0,6 MHz) · Subtono 77,0 Hz para abrirlo (para escuchar no hace falta)] [EA5KGV también ED5YAH: Entrada 145,1 MHz (-0,6 MHz) · Subtono 79,7 Hz para abrirlo (para escuchar no hace falta)] |
| 145,725 | R5 ED5YAI | Entrada 145,125 MHz (-0,6 MHz) · Subtono 77,0 Hz para abrirlo (para escuchar no hace falta) · lista EA5KGV, posición 191 |
| 145,75 | R6 ED5YAC | Entrada 145,15 MHz (-0,6 MHz) · Subtono 118,8 Hz para abrirlo (para escuchar no hace falta) · lista EA5KGV, posición 182 [EA5KGV también ED5YAO: Entrada 145,15 MHz (-0,6 MHz) · Sin subtono] |
| 145,775 | R7 ED5YAQ | Entrada 145,175 MHz (-0,6 MHz) · Subtono 77,0 Hz para abrirlo (para escuchar no hace falta) · lista EA5KGV, posición 196 |
| 430,925 | EA5ABE (simplex) | Subtono 77,0 Hz para abrirlo (para escuchar no hace falta) · lista EA5KGV, posición 175 |
| 431,025 | EA5IRD (simplex) | Subtono 88,5 Hz para abrirlo (para escuchar no hace falta) · lista EA5KGV, posición 177 |
| 438,275 | ED5YAU | Entrada 430,675 MHz (-7,6 MHz) · Sin subtono · lista EA5KGV, posición 171 |
| 438,3 | ED5ZAC | Entrada 430,7 MHz (-7,6 MHz) · Sin subtono · lista EA5KGV, posición 173 |
| 438,35 | ED5ZAB | Entrada 430,75 MHz (-7,6 MHz) · Sin subtono · lista EA5KGV, posición 170 |
| 438,65 | RU-70 Sierra Espuña ED5YAL | Entrada 431.050 · Tono 77.0 [EA5KGV ED5YAL: Entrada 431,05 MHz (-7,6 MHz) · Subtono 77,0 Hz para abrirlo (para escuchar no hace falta)] |
| 438,675 | RU-71 Peña Rubia Lorca | Entrada 431.075 · Tono 77.0 [EA5KGV también EC5C: Entrada 431,075 MHz (-7,6 MHz) · Subtono 77,0 Hz para abrirlo (para escuchar no hace falta)] |
| 438,725 | RU-73 ED5YAE | Entrada 431,125 MHz (-7,6 MHz) · Subtono 79,7 Hz para abrirlo (para escuchar no hace falta) · lista EA5KGV, posición 184 |
| 438,775 | RU-75 ED5YBF · Radio Club Región de Murcia | Repetidor del Radio Club Región de Murcia en Sierra de Carrascoy (IM97IU), 15 W, Big Signal CQ-70. Entrada 431,175 MHz (−7,6 MHz) · Subtono 77,0 Hz para abrirlo (para escuchar no hace falta) |
| 438,8 | RU-76 ED5YAD | Entrada 431,2 MHz (-7,6 MHz) · Subtono 118,8 Hz para abrirlo (para escuchar no hace falta) · lista EA5KGV, posición 183 |
| 438,825 | RU-77 ED5YAS | Entrada 431,225 MHz (-7,6 MHz) · Subtono 71,9 Hz para abrirlo (para escuchar no hace falta) · lista EA5KGV, posición 197 |
| 438,875 | RU-79 ED5YBC | Entrada 431,275 MHz (-7,6 MHz) · Subtono 77,0 Hz para abrirlo (para escuchar no hace falta) · lista EA5KGV, posición 402 |
| 439 | RU-84 ED5YAF | Entrada 431,4 MHz (-7,6 MHz) · Subtono 77,0 Hz para abrirlo (para escuchar no hace falta) · lista EA5KGV, posición 186 |
| 439,05 | RU-86 ED5YAM | Entrada 431,45 MHz (-7,6 MHz) · Subtono 118,8 Hz para abrirlo (para escuchar no hace falta) · lista EA5KGV, posición 193 |
| 439,075 | RU-87 ED5YAV | Entrada 431,475 MHz (-7,6 MHz) · Subtono 118,8 Hz para abrirlo (para escuchar no hace falta) · lista EA5KGV, posición 397 |
| 439,1 | RU-88 ED5YAA | Entrada 431,5 MHz (-7,6 MHz) · Sin subtono · lista EA5KGV, posición 181 |
| 439,15 | RU-90 ED5YAH | Entrada 431,55 MHz (-7,6 MHz) · Subtono 79,7 Hz para abrirlo (para escuchar no hace falta) · lista EA5KGV, posición 190 |
| 439,275 | RU-95 ED5YBD | Entrada 431,675 MHz (-7,6 MHz) · Subtono 77,0 Hz para abrirlo (para escuchar no hace falta) · lista EA5KGV, posición 403 |
| 439,3 | RU-96 ED5YBB | Entrada 431,7 MHz (-7,6 MHz) · Subtono 79,7 Hz para abrirlo (para escuchar no hace falta) · lista EA5KGV, posición 401 |

## Puertos de la Región de Murcia (VHF marina)

- **Cartagena:** escucha permanente en el **16**. Los prácticos y las operaciones portuarias usan el 12, 13 y 14 (perfil «⛵ VHF Marina»).
  La estación costera Cartagena Radio está en el **65** dúplex (bajada 160,875, perfil «⚓ Costeras»).
  Salvamento Marítimo da los boletines meteorológicos en el **10**.
- **Mazarrón:** el puerto deportivo trabaja en el **9**.
- **AIS** (161,975 y 162,025): las posiciones de los barcos salen en el mapa de OpenWebRX+.

## Aeropuertos

- **Región de Murcia (LEMI, Corvera):** torre 121,325 y rodadura 121,750. Aproximación San Javier 130,300.
- **San Javier (LELC, AGA):** torre 124,425, rodadura 121,600, ATIS 128,605.
- **Alicante (LEAL):** torre 118,150, autorizaciones 119,850, rodadura 130,650, ATIS 120,075; Valencia Control 118,800 / 120,400.
- Las frecuencias de 8,33 kHz se dan como portadora real; el AIP las publica como «canal» (121,330 → 121,325).
