Brico-Hams/bricohams-sdr/docs/esquemas/27_adsb_destinos.png

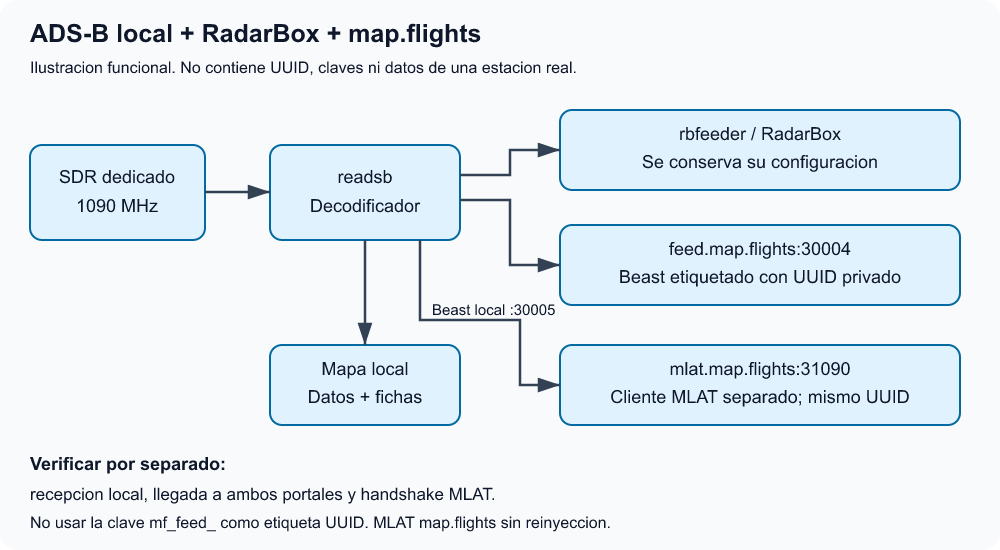
docs/esquemas/27_adsb_destinos.png
