Brico-Hams/bricohams-sdr/files/branding/receiver_top_photo.png

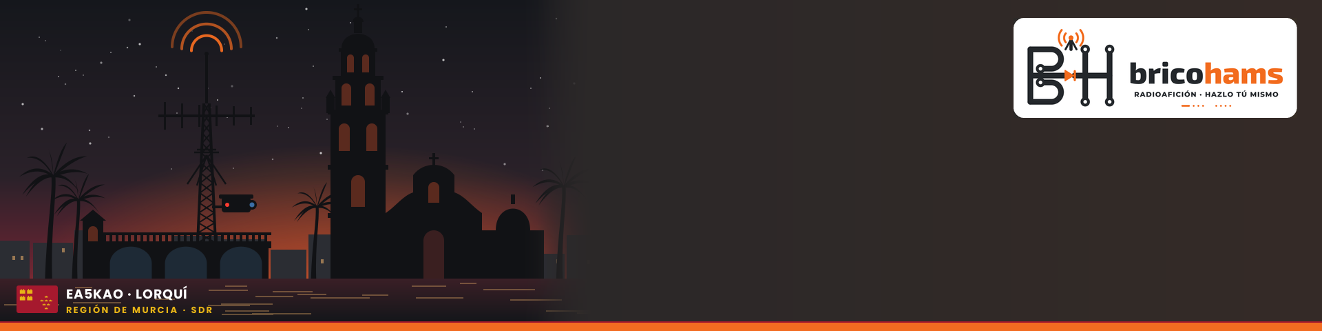
files/branding/receiver_top_photo.png
