Brico-Hams/bricohams-sdr/hardware/antenas/render/piezas.png

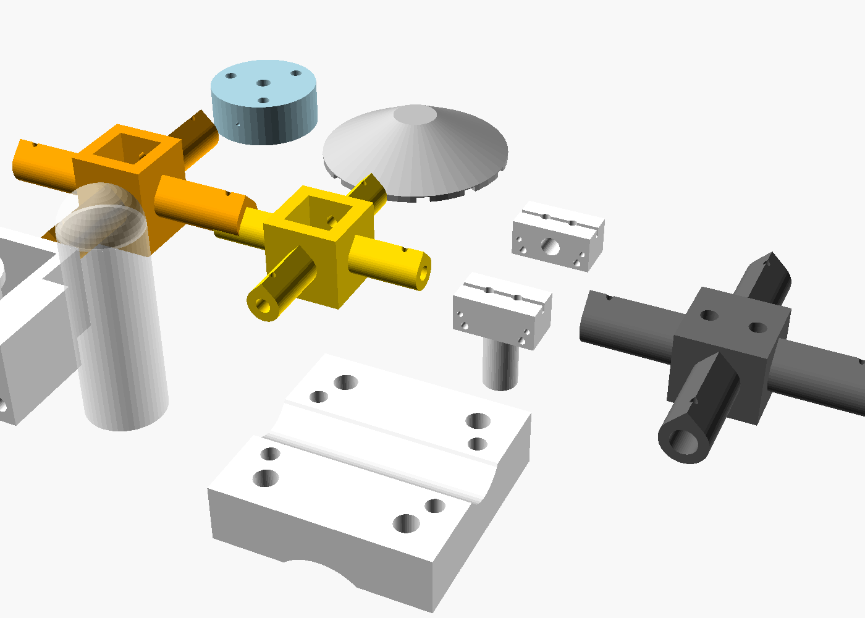
hardware/antenas/render/piezas.png
