Brico-Hams/bricohams-sdr/hardware/caja/render/cuerpo_impresion.png

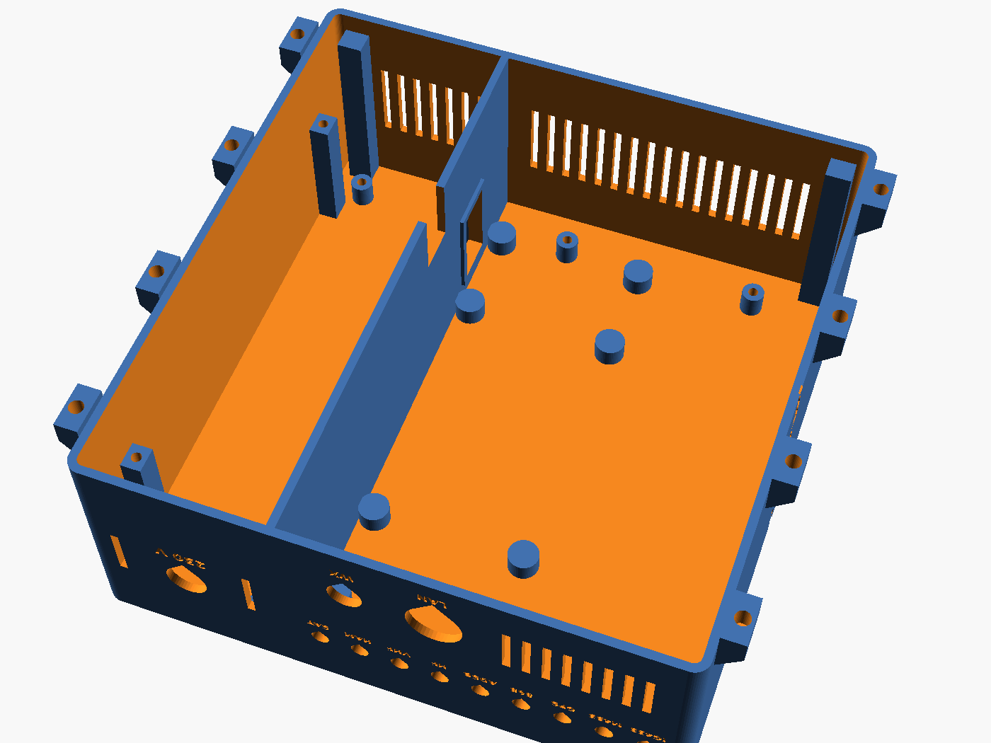
hardware/caja/render/cuerpo_impresion.png
