Brico-Hams/bricohams-sdr/hardware/caja/render/despiece.png

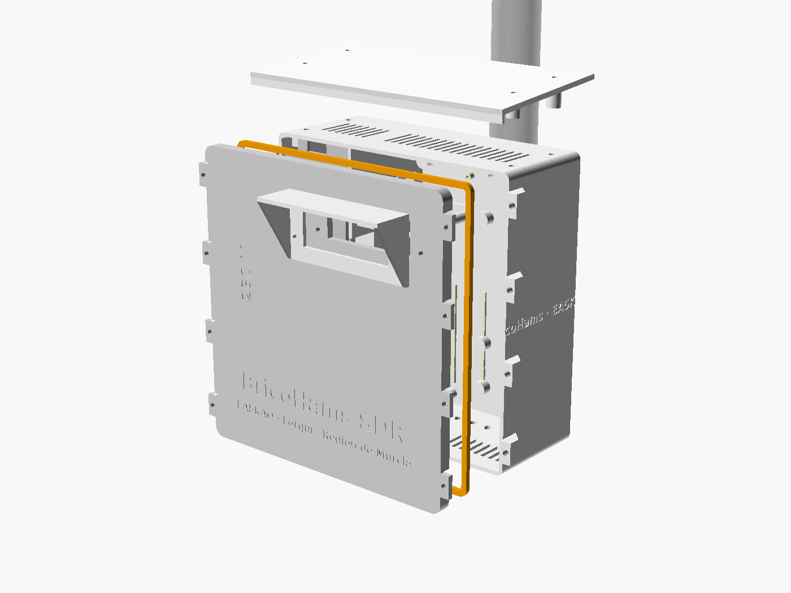
hardware/caja/render/despiece.png
