Brico-Hams/bricohams-sdr/hardware/caja/render/garita_base.png

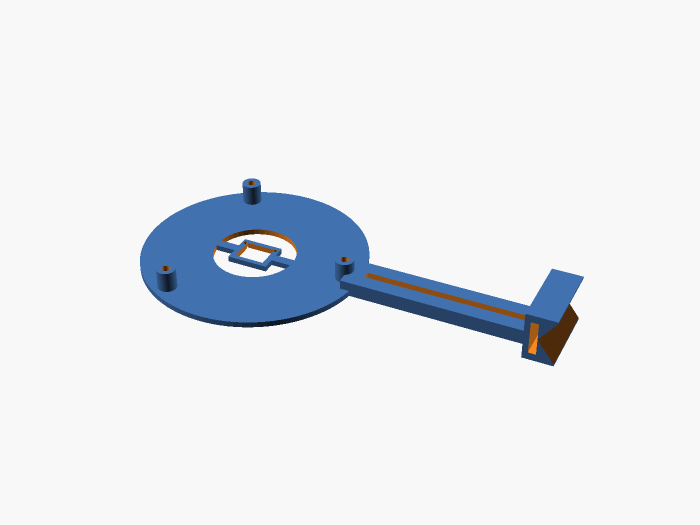
hardware/caja/render/garita_base.png
