Brico-Hams/bricohams-sdr/hardware/caja/render/pasamuros_usb.png

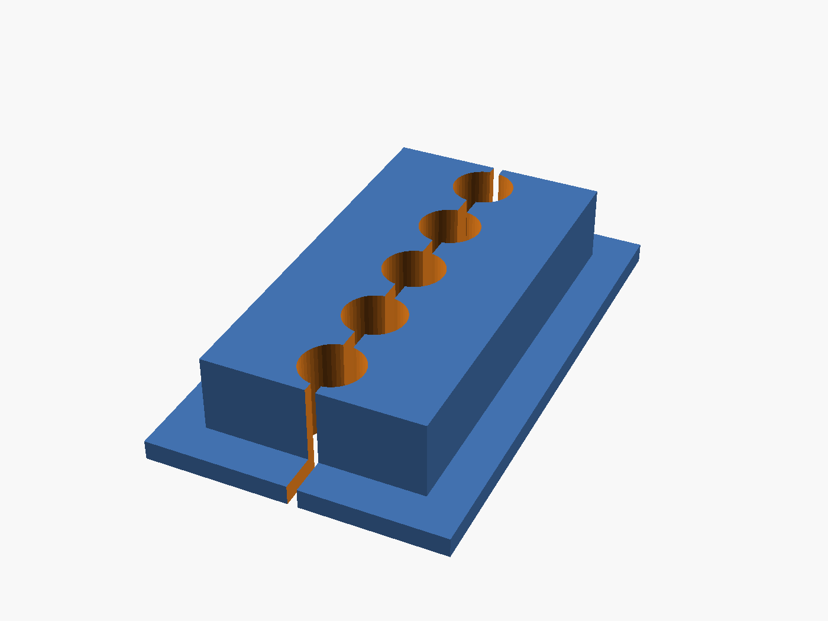
hardware/caja/render/pasamuros_usb.png
