Brico-Hams/bricohams-sdr/hardware/caja/render/placa_electronica.png

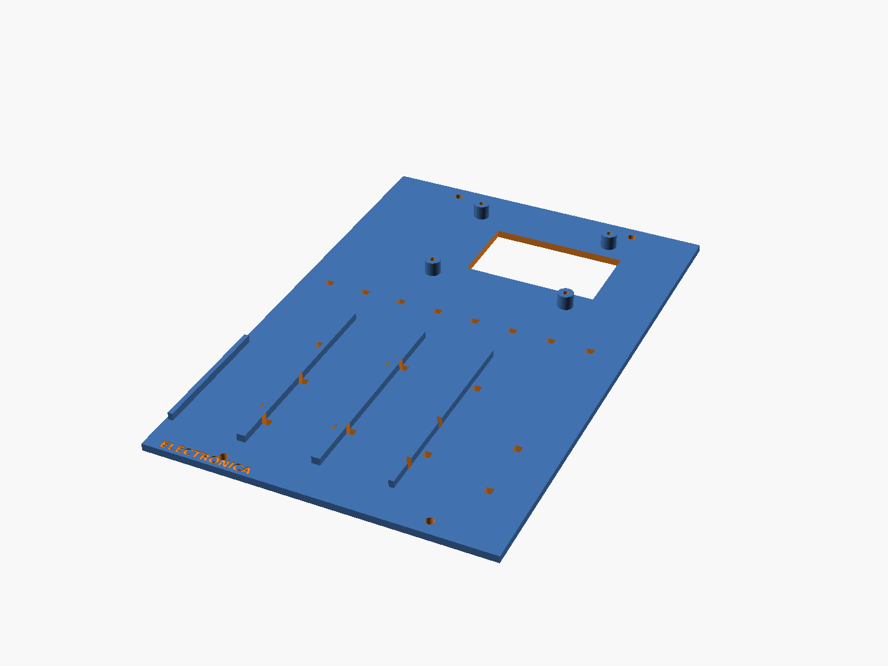
hardware/caja/render/placa_electronica.png
