Brico-Hams/bricohams-sdr/hardware/caja/render/soporte_camara.png

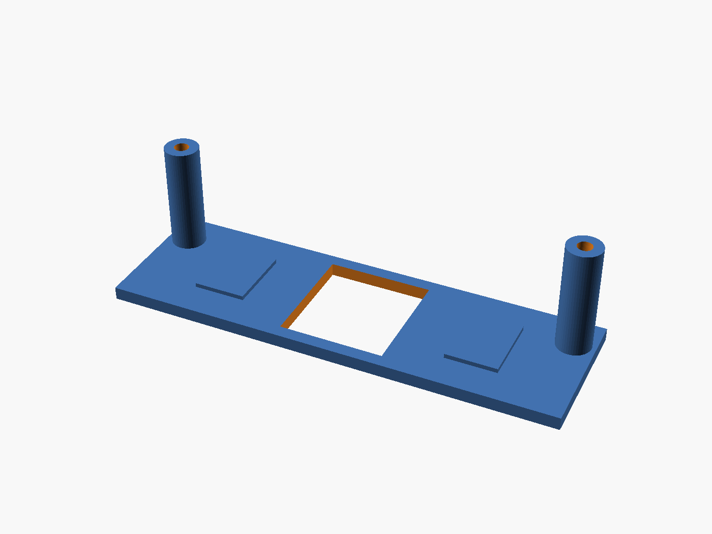
hardware/caja/render/soporte_camara.png
