Brico-Hams/bricohams-sdr/hardware/caja/render/soporte_mastil.png

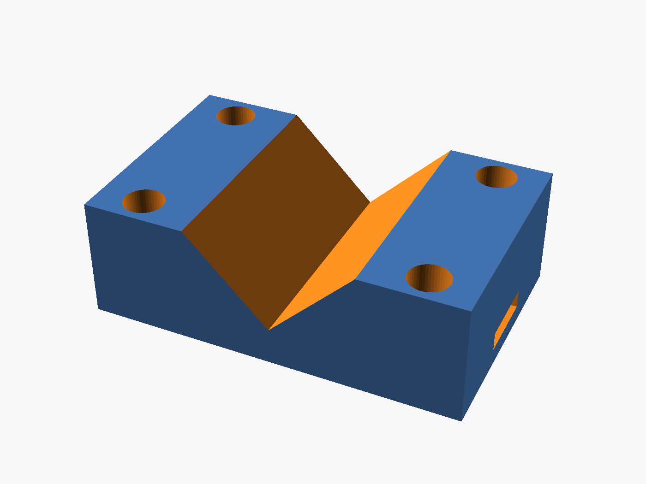
hardware/caja/render/soporte_mastil.png
