Brico-Hams/bricohams-sdr/hardware/caja/render/tapa_interior.png

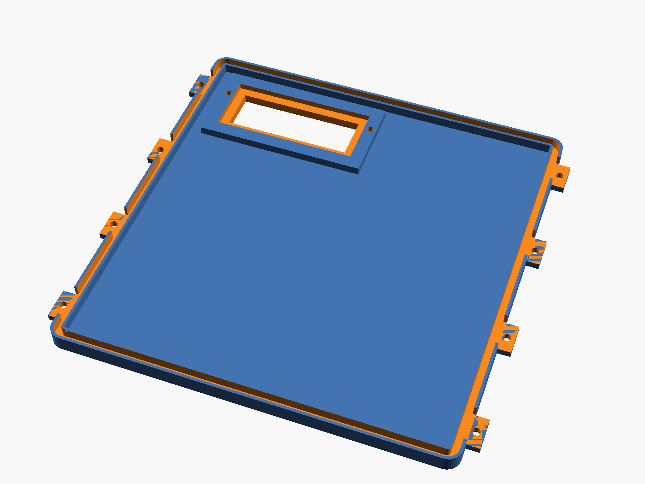
hardware/caja/render/tapa_interior.png
