Brico-Hams/bricohams-sdr/hardware/caja/render/tapa_potencia.png

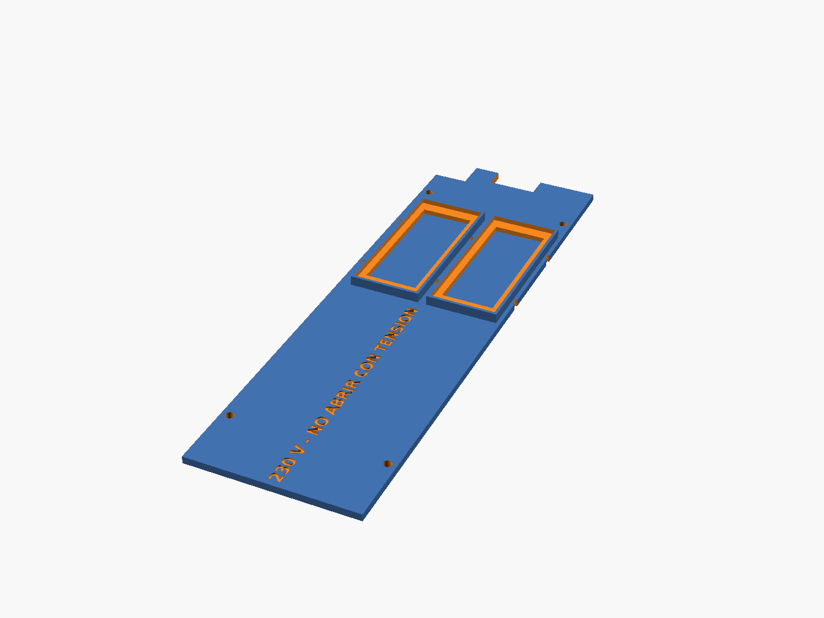
hardware/caja/render/tapa_potencia.png
