Brico-Hams/bricohams-sdr/hardware/caja/render/tejadillo.png

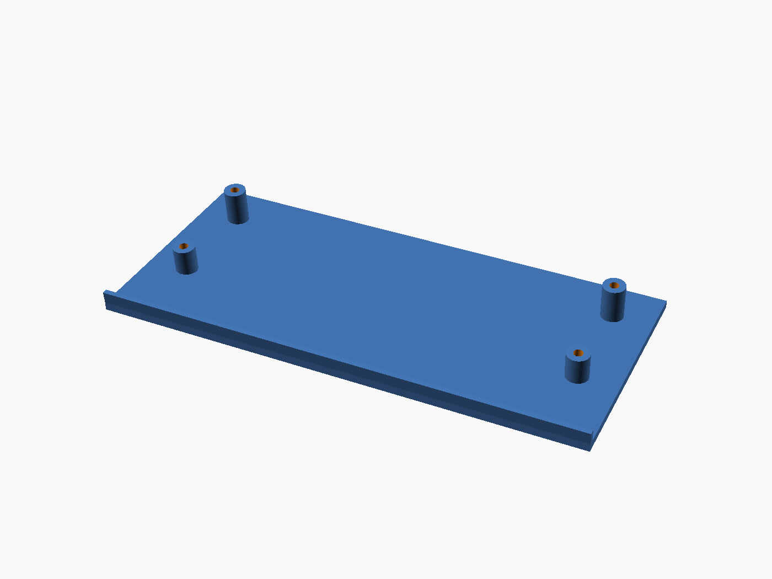
hardware/caja/render/tejadillo.png
