Brico-Hams/bricohams-sdr/hardware/caja/render/visera.png

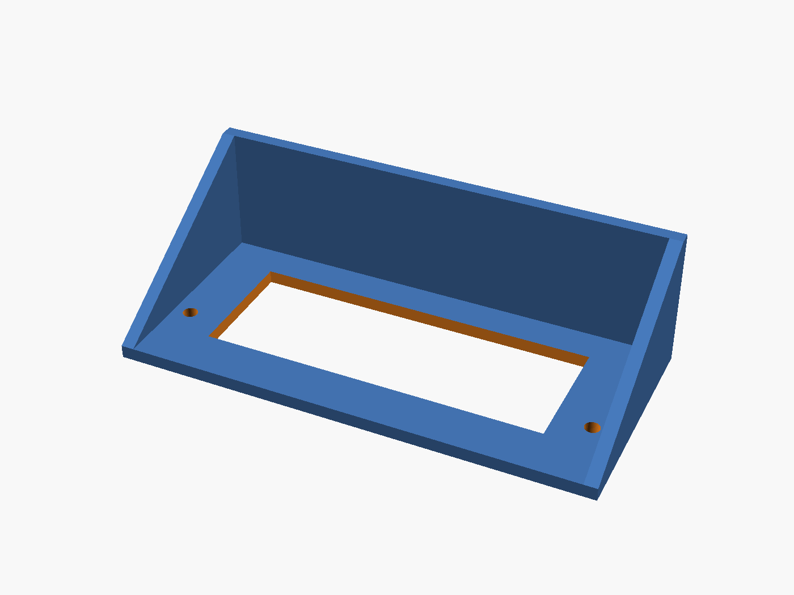
hardware/caja/render/visera.png
