Brico-Hams/bricohams-sdr/hardware/anclajes/stl/cruceta_mastil_brazo_cuerpo.stl

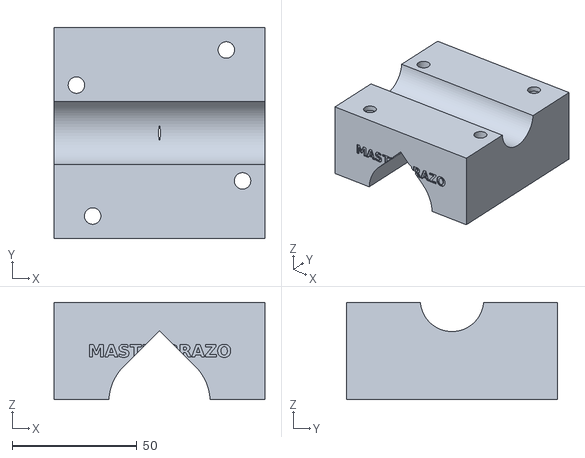
[picture p31: CAD file, 2026-10-29]
hardware/anclajes/stl/cruceta_mastil_brazo_cuerpo.stl
84.6 x 84.6 x 39.0
