Brico-Hams/bricohams-sdr/hardware/antenas/stl/discone_capuchon.stl

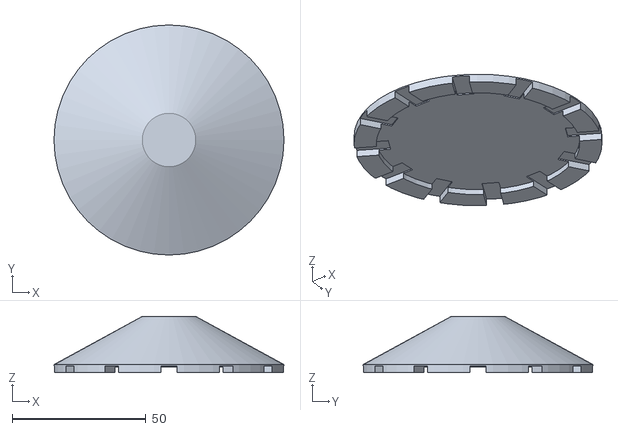
[picture p32: CAD file, 2026-10-29]
hardware/antenas/stl/discone_capuchon.stl
86.0 x 86.0 x 21.0
