Brico-Hams/bricohams-sdr/hardware/caja/stl/placa_electronica.stl

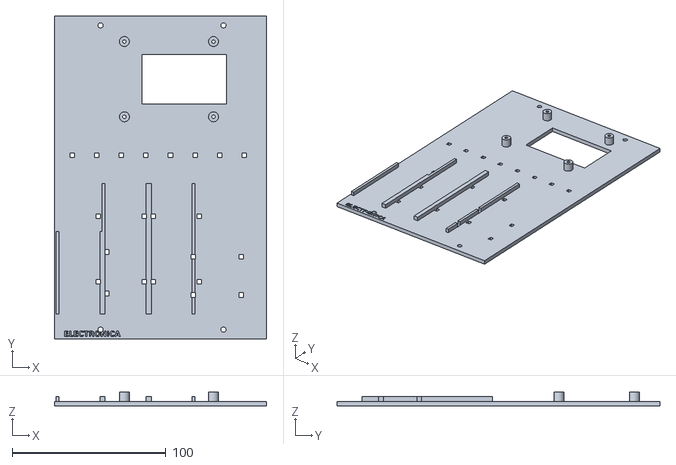
[picture p33: CAD file, 2026-10-29]
hardware/caja/stl/placa_electronica.stl
138.0 x 210.0 x 9.00
