Brico-Hams/bricohams-sdr/hardware/caja_v3/stl/potencia_junta_tapa.stl

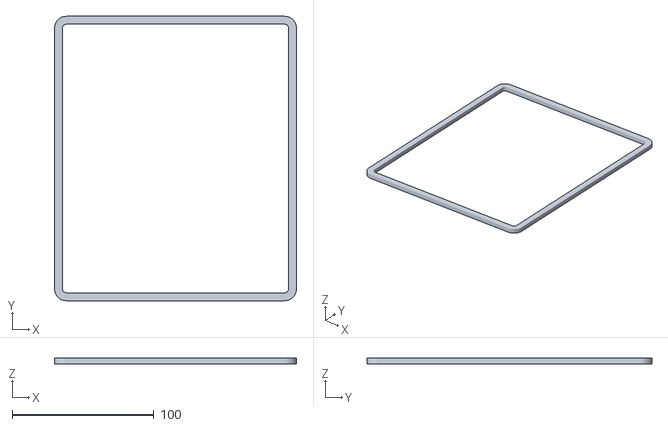
[picture p34: CAD file, 2026-11-01]
hardware/caja_v3/stl/potencia_junta_tapa.stl
170.8 x 200.8 x 4.00
