Brico-Hams/bricohams-sdr/hardware/anclajes/stl/cruceta_brazo_fibra_tapa_brazo.stl

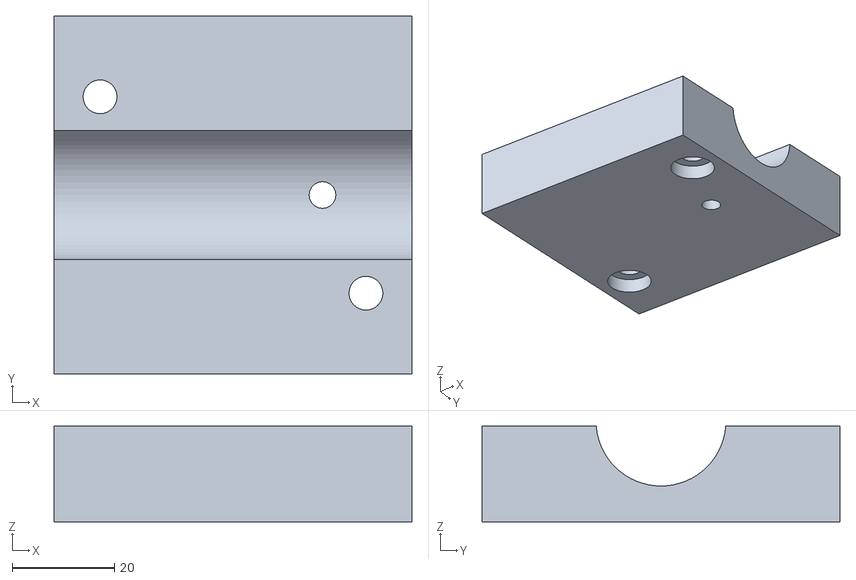
[picture p35: CAD file, 2026-10-29]
hardware/anclajes/stl/cruceta_brazo_fibra_tapa_brazo.stl
70.0 x 70.0 x 18.7
