Brico-Hams/bricohams-sdr/hardware/antenas/stl/quad_buje_2m.stl

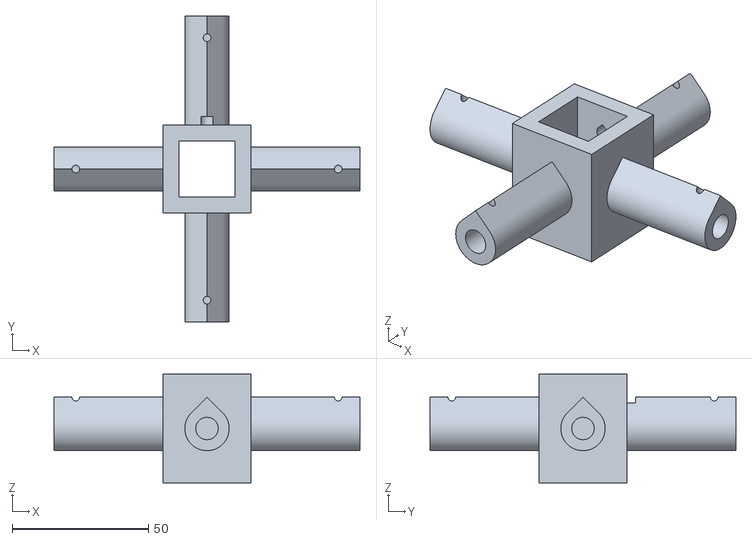
[picture p36: CAD file, 2026-10-29]
hardware/antenas/stl/quad_buje_2m.stl
112.4 x 112.4 x 40.0
