Brico-Hams/bricohams-sdr/hardware/caja/stl/junta_ventana.stl

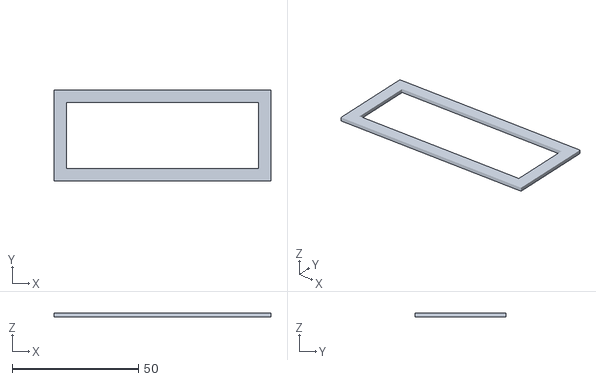
[picture p37: CAD file, 2026-10-29]
hardware/caja/stl/junta_ventana.stl
86.0 x 36.0 x 1.50
