Brico-Hams/bricohams-sdr/hardware/caja_v3/stl/electronica_cuerpo.stl

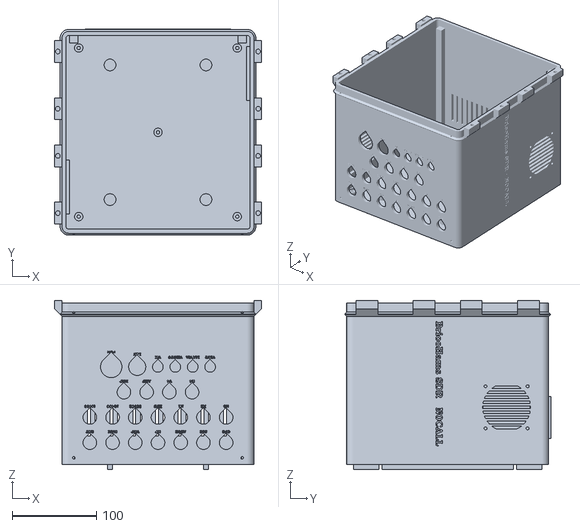
[picture p38: CAD file, 2026-11-01]
hardware/caja_v3/stl/electronica_cuerpo.stl
246.0 x 245.3 x 201.0
