Brico-Hams/bricohams-sdr/hardware/anclajes/stl/cruceta_mastil_brazo_tapa_mastil.stl

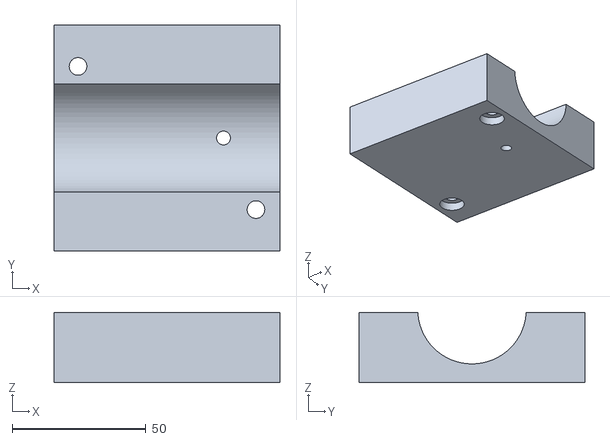
[picture p39: CAD file, 2026-10-29]
hardware/anclajes/stl/cruceta_mastil_brazo_tapa_mastil.stl
84.6 x 84.6 x 26.3
