Brico-Hams/bricohams-sdr/hardware/antenas/stl/clip_filtro.stl

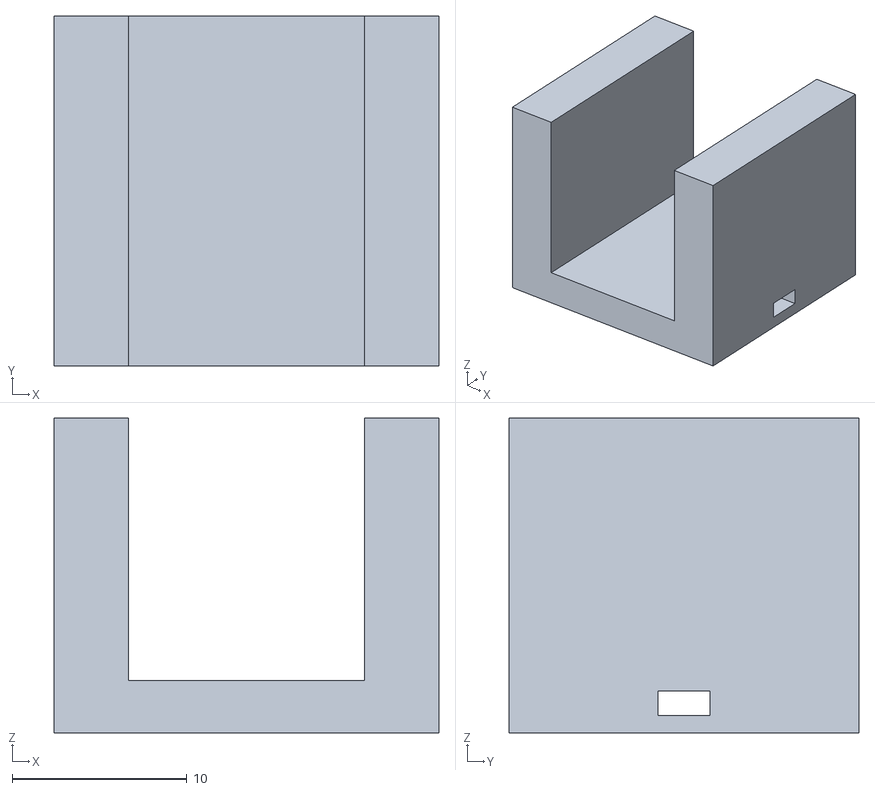
[picture p40: CAD file, 2026-10-29]
hardware/antenas/stl/clip_filtro.stl
22.0 x 20.0 x 18.0
