Brico-Hams/bricohams-sdr/hardware/caja/stl/tapa.stl

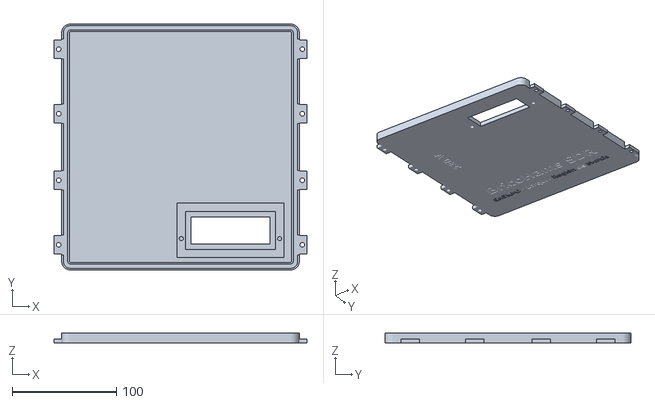
[picture p41: CAD file, 2026-10-29]
hardware/caja/stl/tapa.stl
243.0 x 236.2 x 10.0
