Brico-Hams/bricohams-sdr/hardware/caja_v3/stl/electronica_tejadillo.stl

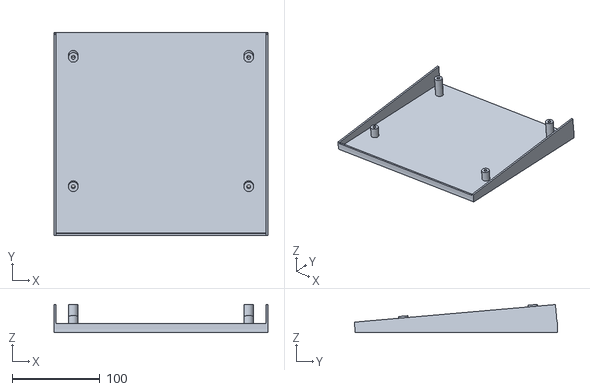
[picture p42: CAD file, 2026-11-01]
hardware/caja_v3/stl/electronica_tejadillo.stl
244.0 x 231.9 x 32.2
