Brico-Hams/bricohams-sdr/hardware/antenas/stl/separador_coax.stl

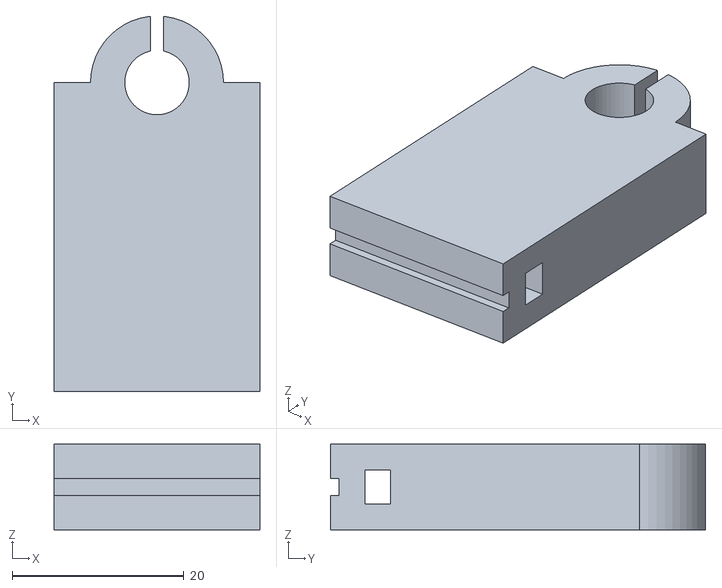
[picture p44: CAD file, 2026-10-29]
hardware/antenas/stl/separador_coax.stl
24.0 x 43.7 x 10.0
