Brico-Hams/bricohams-sdr/hardware/caja/stl/visera.stl

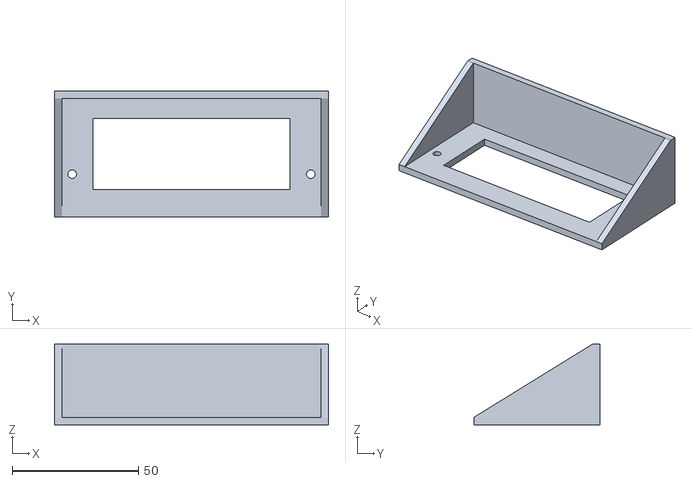
[picture p45: CAD file, 2026-10-29]
hardware/caja/stl/visera.stl
108.5 x 50.0 x 32.0
