Brico-Hams/bricohams-sdr/hardware/caja_v3/stl/sai_placa_rejilla.stl

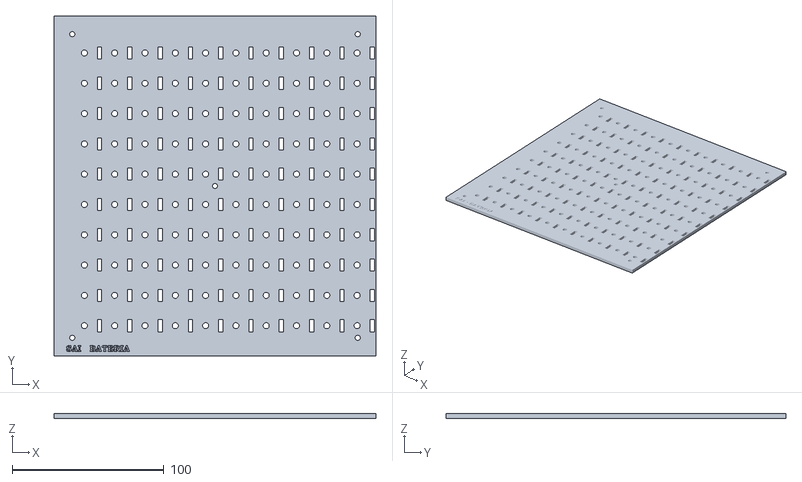
[picture p46: CAD file, 2026-11-01]
hardware/caja_v3/stl/sai_placa_rejilla.stl
212.4 x 224.4 x 3.20
