Brico-Hams/bricohams-sdr/hardware/anclajes/stl/cruceta_brazo_fibra_cuerpo.stl

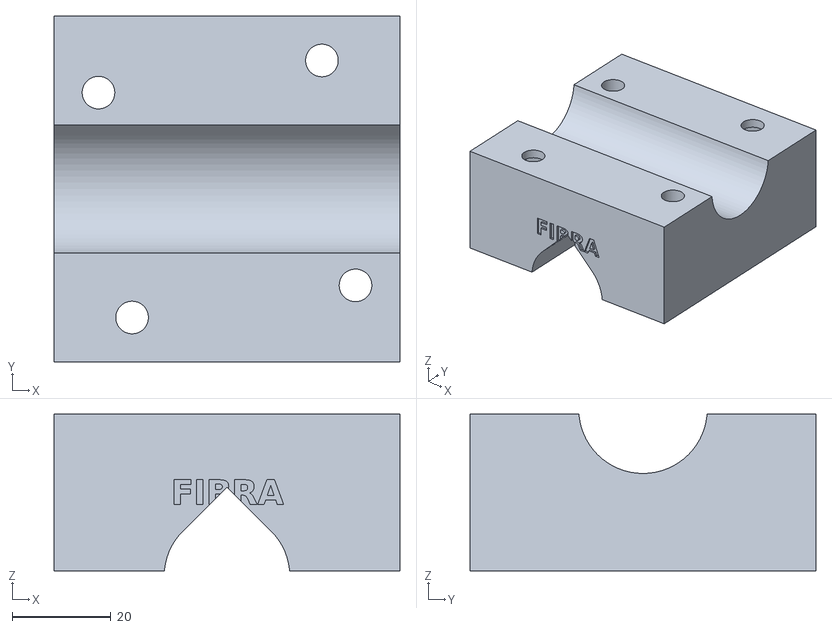
[picture p47: CAD file, 2026-10-29]
hardware/anclajes/stl/cruceta_brazo_fibra_cuerpo.stl
70.0 x 70.0 x 31.7
