Brico-Hams/bricohams-sdr/hardware/antenas/stl/quad_clip_70.stl

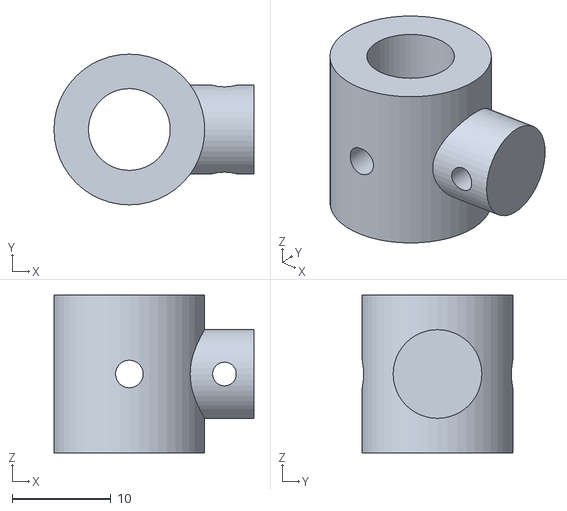
[picture p48: CAD file, 2026-10-29]
hardware/antenas/stl/quad_clip_70.stl
20.3 x 15.3 x 16.0
