Brico-Hams/bricohams-sdr/hardware/caja/stl/tejadillo.stl

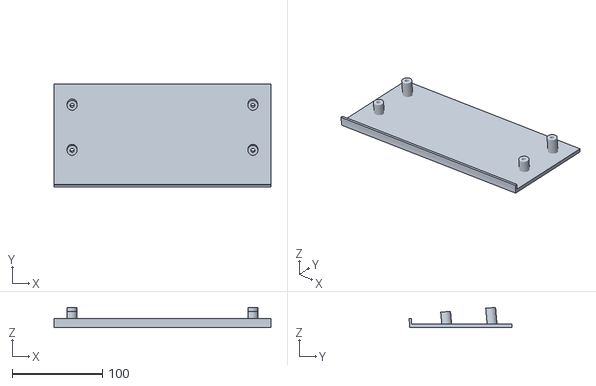
[picture p49: CAD file, 2026-10-29]
hardware/caja/stl/tejadillo.stl
240.0 x 114.0 x 22.4
