Brico-Hams/bricohams-sdr/hardware/caja_v3/stl/electronica_tapa.stl

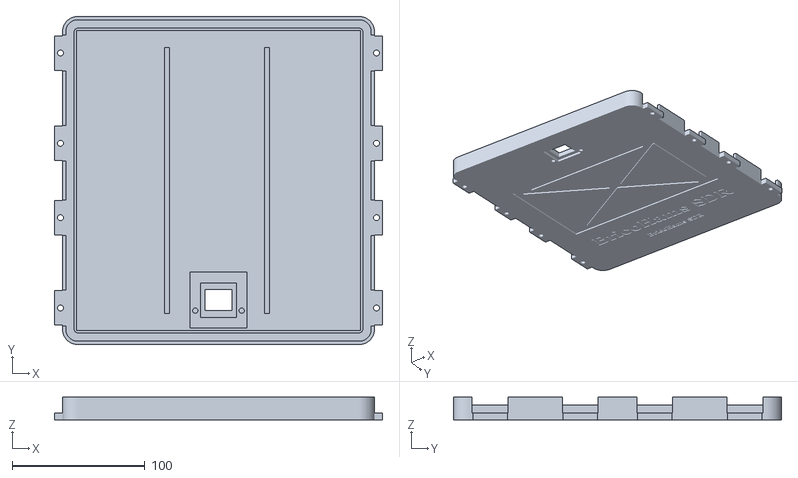
[picture p50: CAD file, 2026-11-01]
hardware/caja_v3/stl/electronica_tapa.stl
247.0 x 247.0 x 17.2
