Brico-Hams/bricohams-sdr/hardware/anclajes/stl/pluvio_plataforma.stl

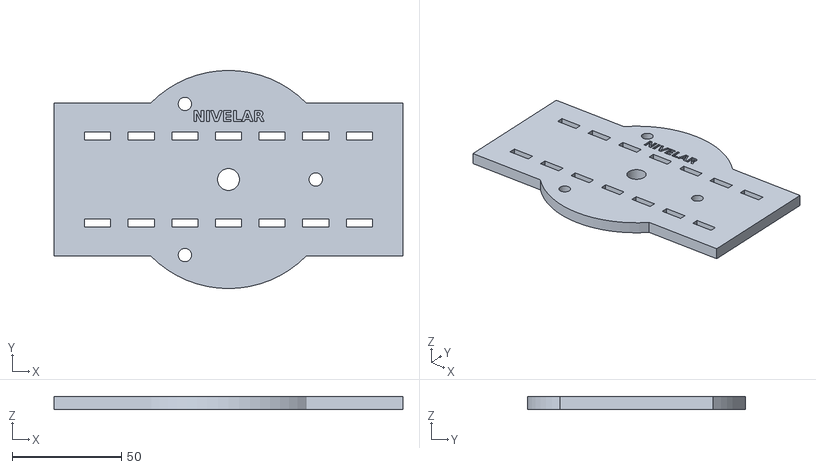
[picture p51: CAD file, 2026-10-29]
hardware/anclajes/stl/pluvio_plataforma.stl
160.0 x 100.0 x 6.00
