Brico-Hams/bricohams-sdr/hardware/caja/stl/tapa_potencia.stl

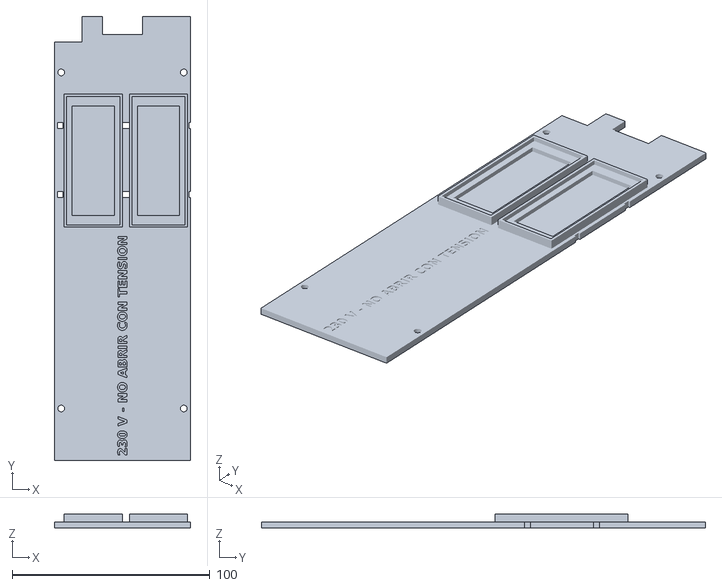
[picture p53: CAD file, 2026-10-16]
hardware/caja/stl/tapa_potencia.stl
69.0 x 224.6 x 7.00
