Brico-Hams/bricohams-sdr/hardware/caja_v3/stl/sai_soporte_bateria.stl

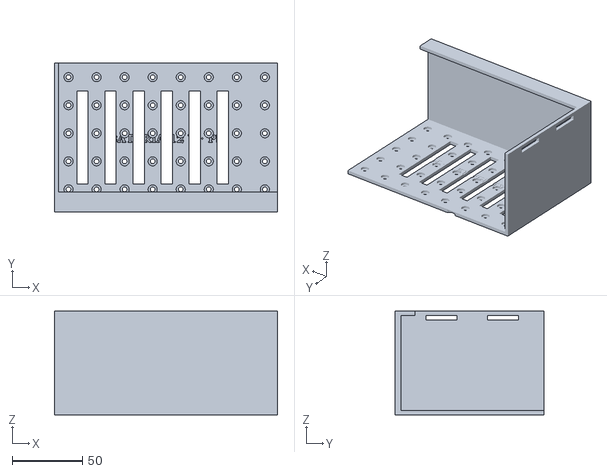
[picture p54: CAD file, 2026-11-01]
hardware/caja_v3/stl/sai_soporte_bateria.stl
159.0 x 106.0 x 74.0
