Brico-Hams/bricohams-sdr/hardware/antenas/stl/gps_soporte.stl

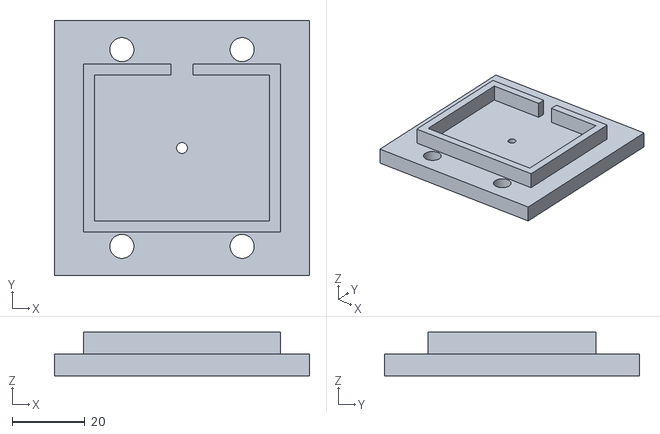
[picture p55: CAD file, 2026-10-29]
hardware/antenas/stl/gps_soporte.stl
70.0 x 70.0 x 12.0
