Brico-Hams/bricohams-sdr/hardware/caja/stl/placa_potencia.stl

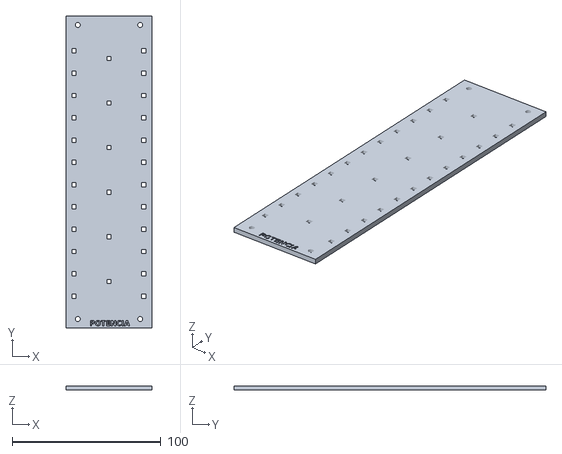
[picture p56: CAD file, 2026-10-16]
hardware/caja/stl/placa_potencia.stl
58.0 x 210.0 x 3.00
