Brico-Hams/bricohams-sdr/hardware/caja_v3/stl/electronica_soporte_camara.stl

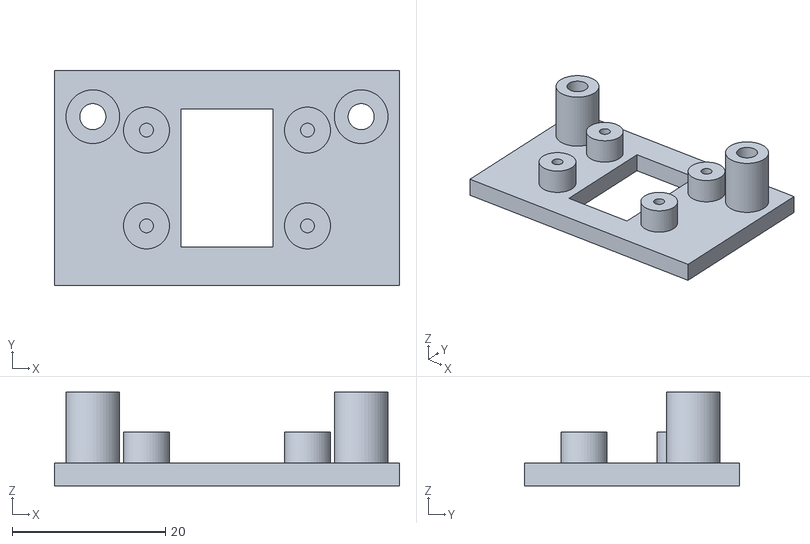
[picture p57: CAD file, 2026-11-01]
hardware/caja_v3/stl/electronica_soporte_camara.stl
45.0 x 28.0 x 12.2
