Brico-Hams/bricohams-sdr/hardware/anclajes/stl/cruceta_mastil_brazo_tapa_brazo.stl

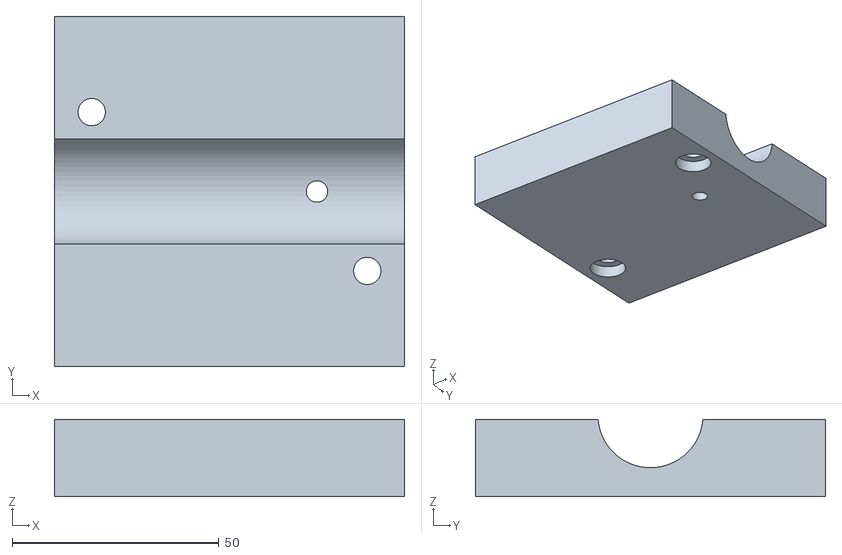
[picture p58: CAD file, 2026-10-29]
hardware/anclajes/stl/cruceta_mastil_brazo_tapa_brazo.stl
84.6 x 84.6 x 18.7
