Brico-Hams/bricohams-sdr/hardware/antenas/stl/discone_plantilla_disco.stl

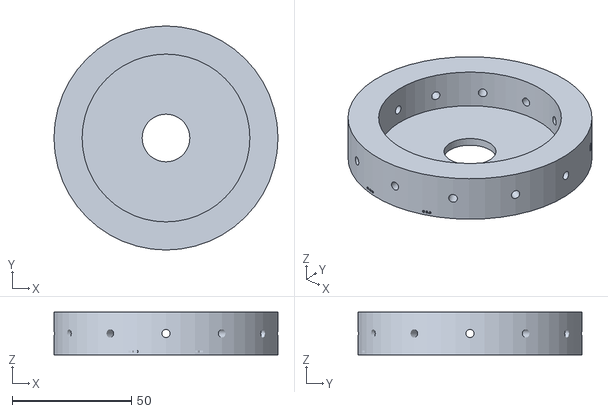
[picture p59: CAD file, 2026-10-29]
hardware/antenas/stl/discone_plantilla_disco.stl
94.0 x 94.0 x 18.0
