Brico-Hams/bricohams-sdr/hardware/caja/stl/garita_tapa.stl

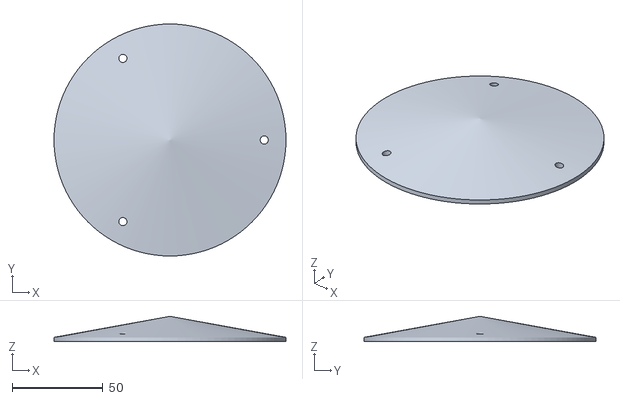
[picture p60: CAD file, 2026-10-16]
hardware/caja/stl/garita_tapa.stl
128.0 x 128.0 x 14.0
