Brico-Hams/bricohams-sdr/hardware/caja_v3/stl/sai_tejadillo.stl

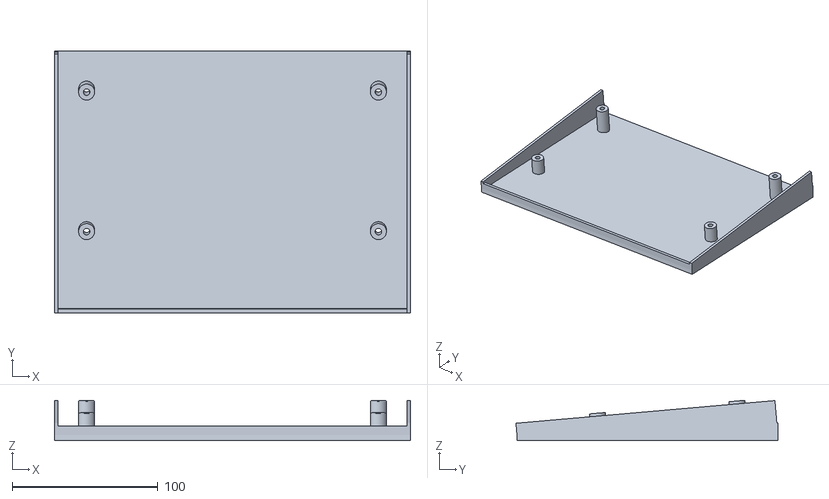
[picture p61: CAD file, 2026-11-01]
hardware/caja_v3/stl/sai_tejadillo.stl
244.0 x 179.7 x 27.7
