Brico-Hams/bricohams-sdr/hardware/anclajes/stl/pico_soporte.stl

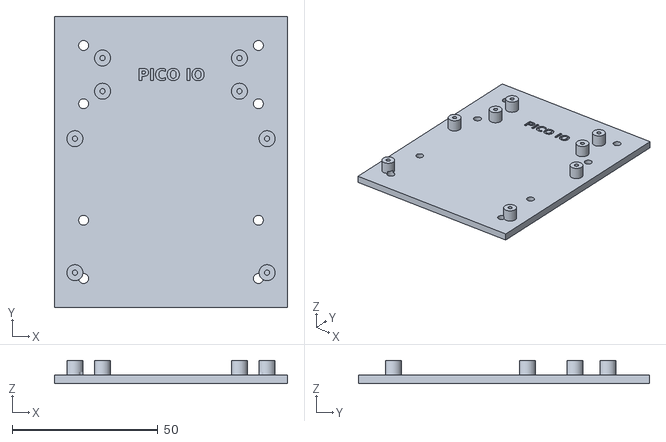
[picture p62: CAD file, 2026-10-29]
hardware/anclajes/stl/pico_soporte.stl
80.0 x 100.0 x 8.00
