Brico-Hams/bricohams-sdr/hardware/caja/stl/soporte_mastil.stl

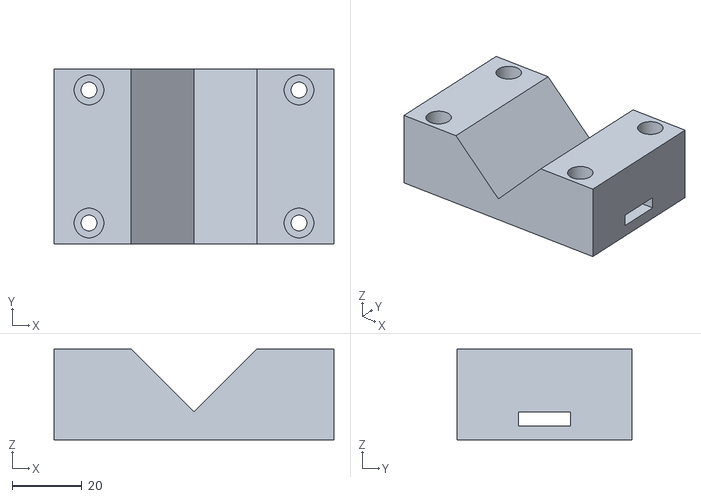
[picture p64: CAD file, 2026-10-16]
hardware/caja/stl/soporte_mastil.stl
80.0 x 50.0 x 26.0
