Brico-Hams/bricohams-sdr/hardware/antenas/stl/discone_adaptador_mastil.stl

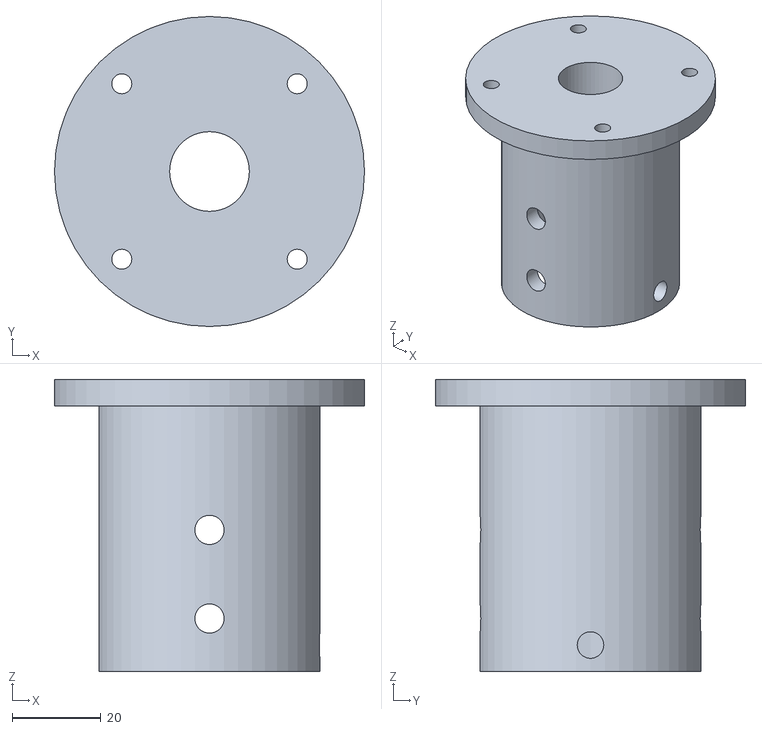
[picture p67: CAD file, 2026-10-29]
hardware/antenas/stl/discone_adaptador_mastil.stl
70.0 x 70.0 x 66.0
