Brico-Hams/bricohams-sdr/hardware/caja/stl/garita_base.stl

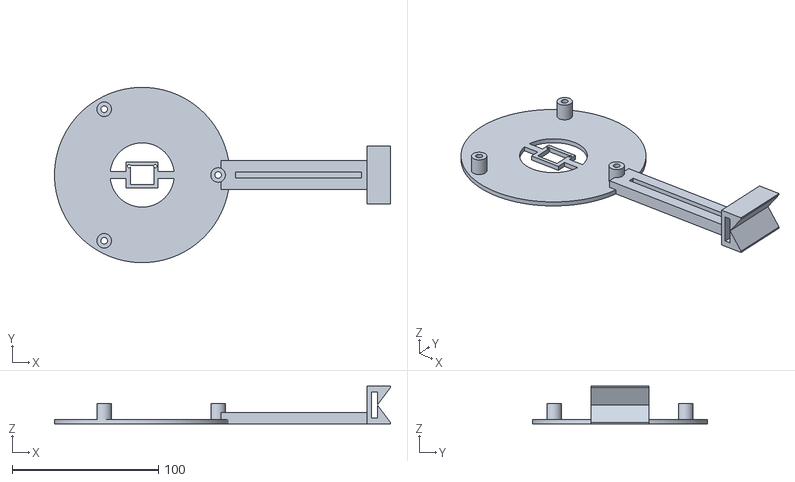
[picture p68: CAD file, 2026-10-16]
hardware/caja/stl/garita_base.stl
230.0 x 120.0 x 26.0
