Brico-Hams/bricohams-sdr/hardware/caja_v3/stl/potencia_placa_rejilla.stl

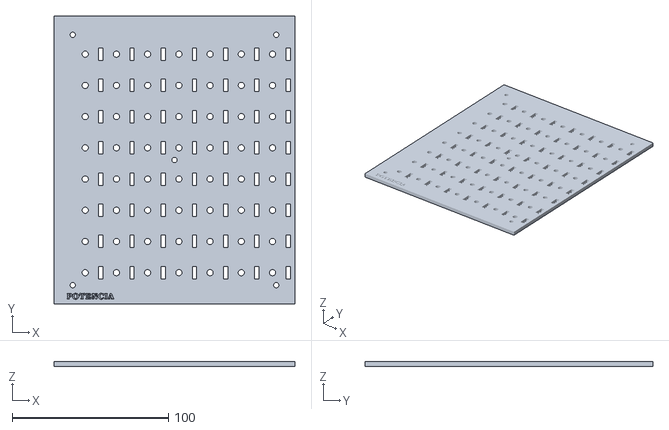
[picture p69: CAD file, 2026-11-01]
hardware/caja_v3/stl/potencia_placa_rejilla.stl
154.4 x 184.4 x 3.20
