Brico-Hams/bricohams-sdr/hardware/antenas/stl/tapon_brazo.stl

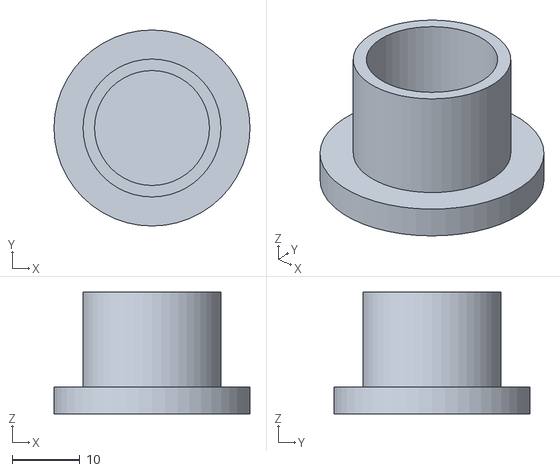
[picture p71: CAD file, 2026-10-29]
hardware/antenas/stl/tapon_brazo.stl
29.0 x 29.0 x 18.0
