Brico-Hams/bricohams-sdr/hardware/caja/stl/soporte_camara.stl

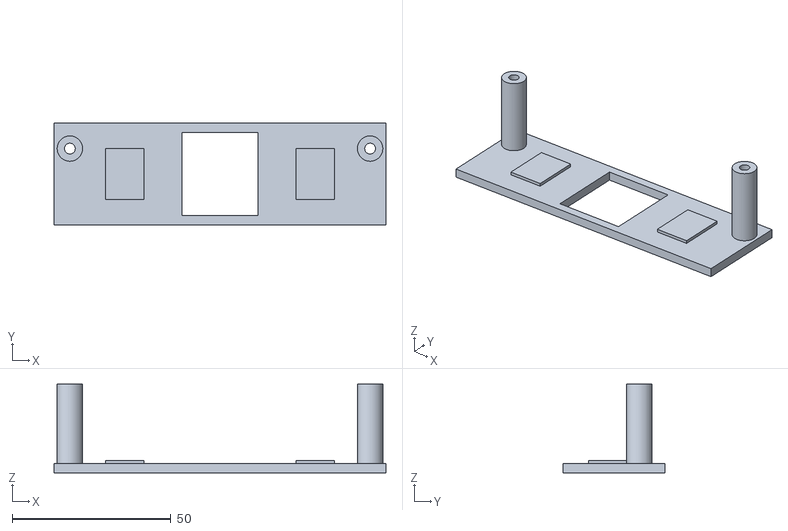
[picture p72: CAD file, 2026-10-16]
hardware/caja/stl/soporte_camara.stl
104.5 x 32.0 x 28.0
