Brico-Hams/bricohams-sdr/hardware/caja_v3/stl/sai_pletina_trafo.stl

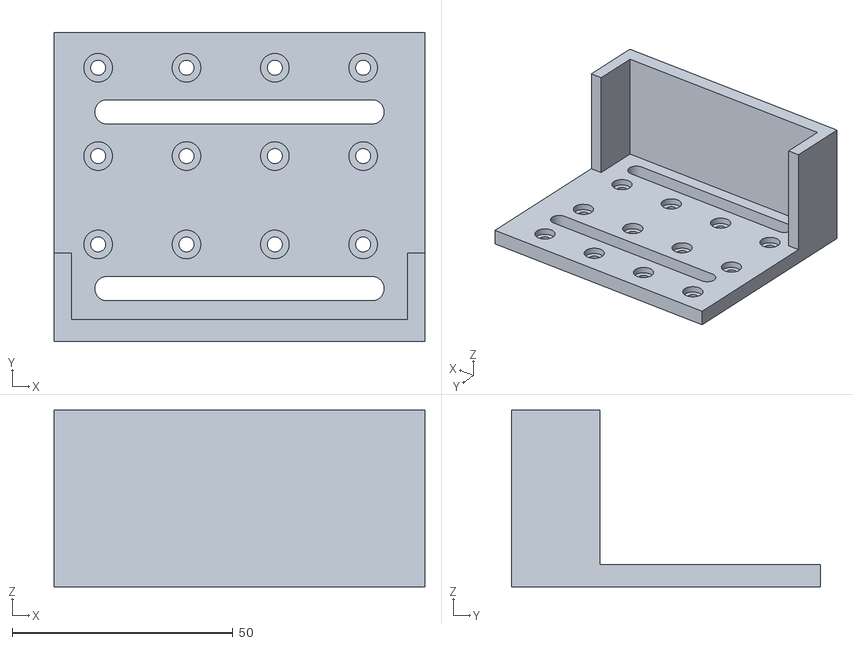
[picture p73: CAD file, 2026-11-01]
hardware/caja_v3/stl/sai_pletina_trafo.stl
84.0 x 70.0 x 40.0
