Brico-Hams/bricohams-sdr/hardware/anclajes/stl/pluvio_vaso.stl

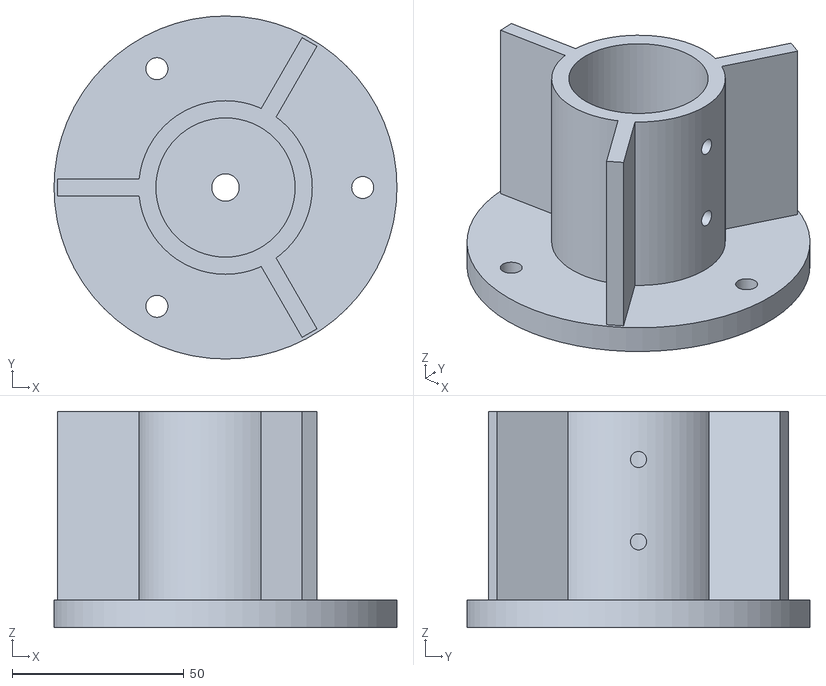
[picture p74: CAD file, 2026-10-16]
hardware/anclajes/stl/pluvio_vaso.stl
100.0 x 100.0 x 63.0
