Brico-Hams/bricohams-sdr/hardware/antenas/stl/tapon_varilla.stl

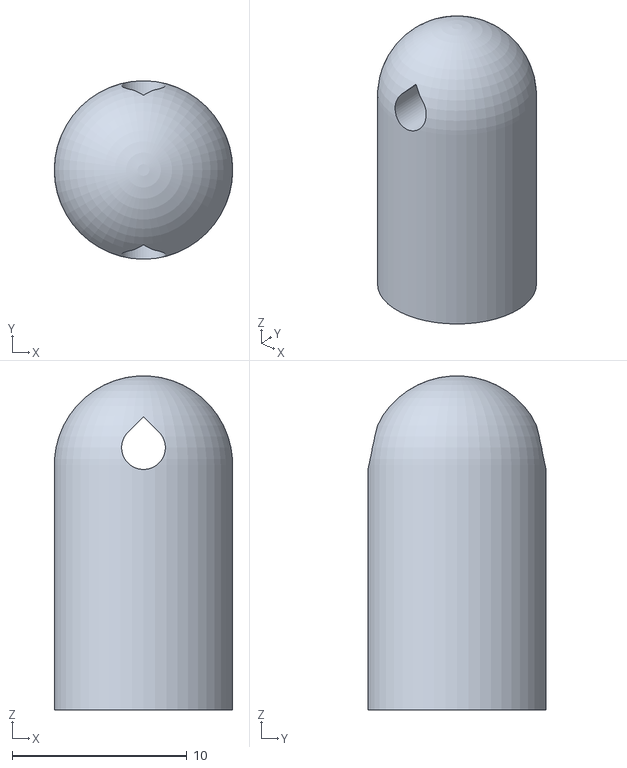
[picture p75: CAD file, 2026-10-29]
hardware/antenas/stl/tapon_varilla.stl
10.2 x 10.2 x 19.1
