Brico-Hams/bricohams-sdr/hardware/caja/stl/separador_ir.stl

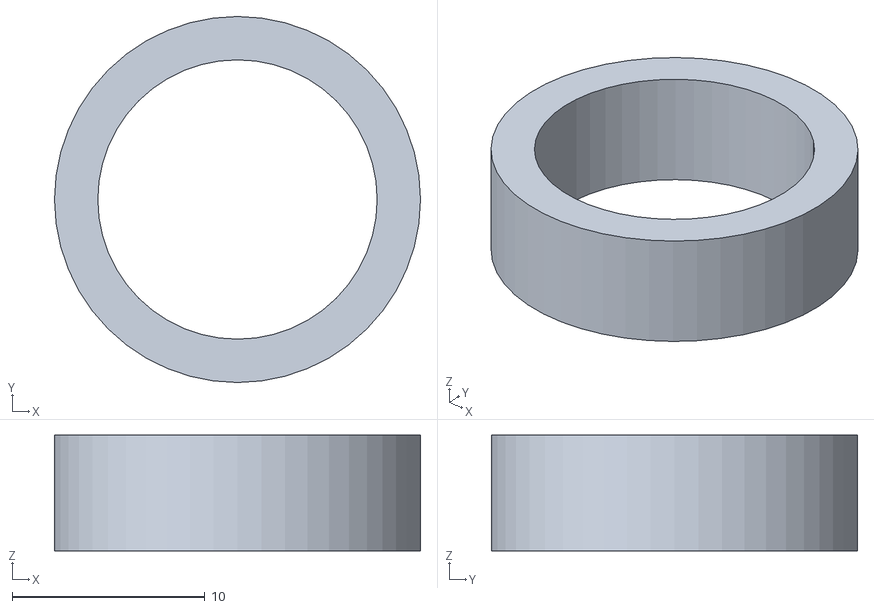
[picture p76: CAD file, 2026-10-16]
hardware/caja/stl/separador_ir.stl
19.0 x 19.0 x 6.00
