Brico-Hams/bricohams-sdr/hardware/anclajes/stl/cruceta_mastil_quad_tapa_boom.stl

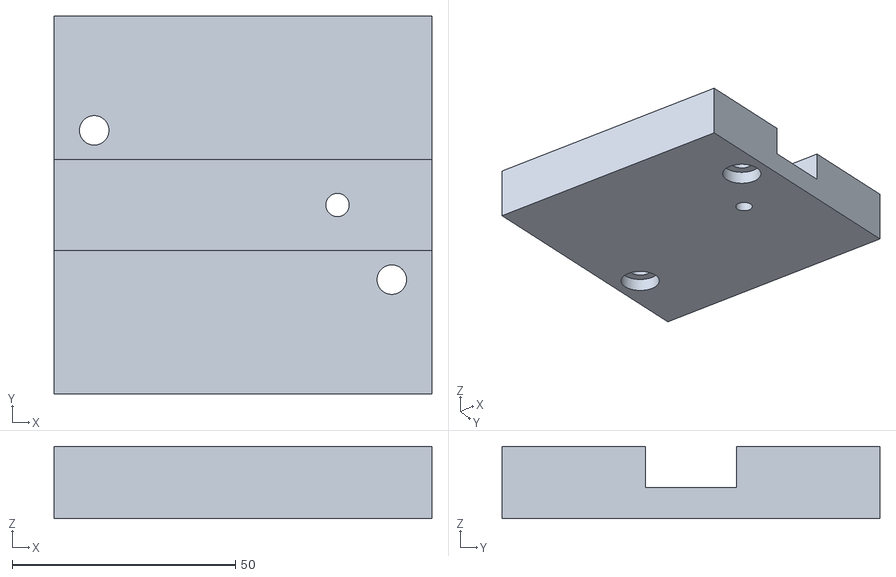
[picture p77: CAD file, 2026-10-16]
hardware/anclajes/stl/cruceta_mastil_quad_tapa_boom.stl
84.6 x 84.6 x 16.2
