Brico-Hams/bricohams-sdr/hardware/antenas/stl/adsb_base.stl

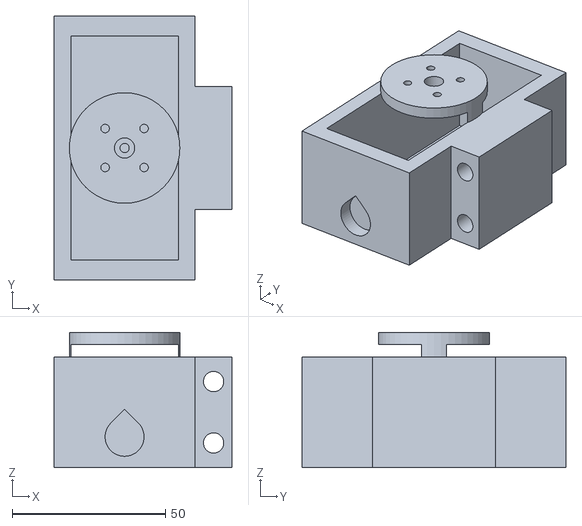
[picture p78: CAD file, 2026-10-29]
hardware/antenas/stl/adsb_base.stl
58.0 x 86.0 x 44.0
