Brico-Hams/bricohams-sdr/hardware/caja/stl/junta_tapa.stl

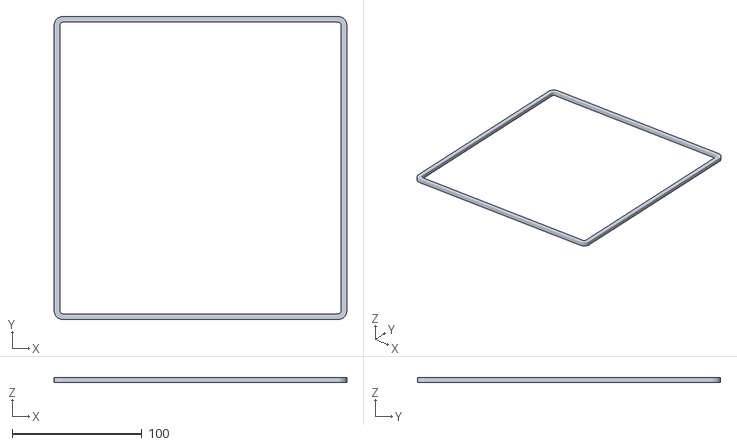
[picture p79: CAD file, 2026-10-16]
hardware/caja/stl/junta_tapa.stl
225.2 x 233.2 x 4.00
