Brico-Hams/bricohams-sdr/hardware/antenas/stl/mla_junta.stl

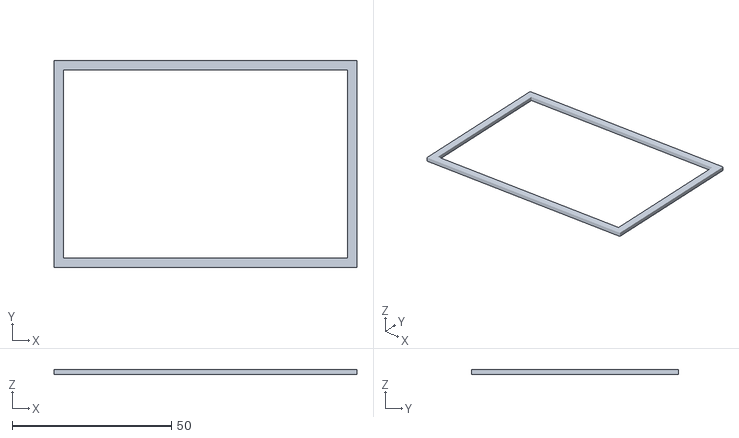
[picture p81: CAD file, 2026-10-29]
hardware/antenas/stl/mla_junta.stl
95.0 x 65.0 x 1.60
