Brico-Hams/bricohams-sdr/hardware/caja/stl/pasamuros_usb.stl

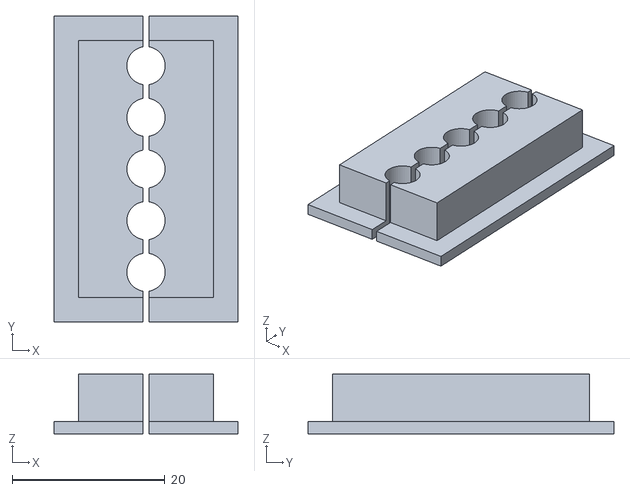
[picture p82: CAD file, 2026-10-04]
hardware/caja/stl/pasamuros_usb.stl
24.0 x 40.0 x 7.80
