Brico-Hams/bricohams-sdr/hardware/caja_v3/stl/electronica_bandeja_sdr.stl

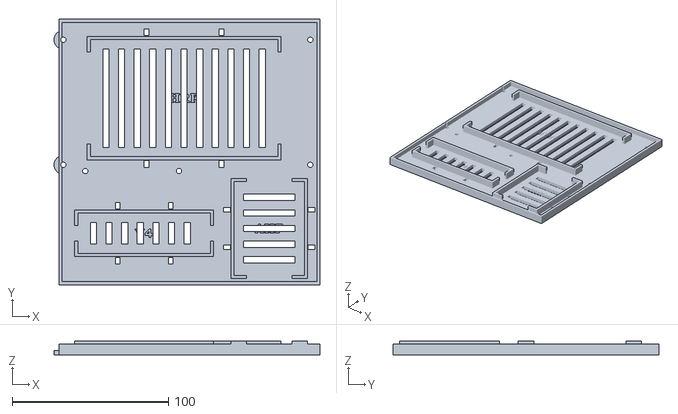
[picture p83: CAD file, 2026-11-01]
hardware/caja_v3/stl/electronica_bandeja_sdr.stl
170.2 x 170.0 x 8.99
