Brico-Hams/bricohams-sdr/hardware/anclajes/stl/cruceta_brazo_tubo_tapa.stl

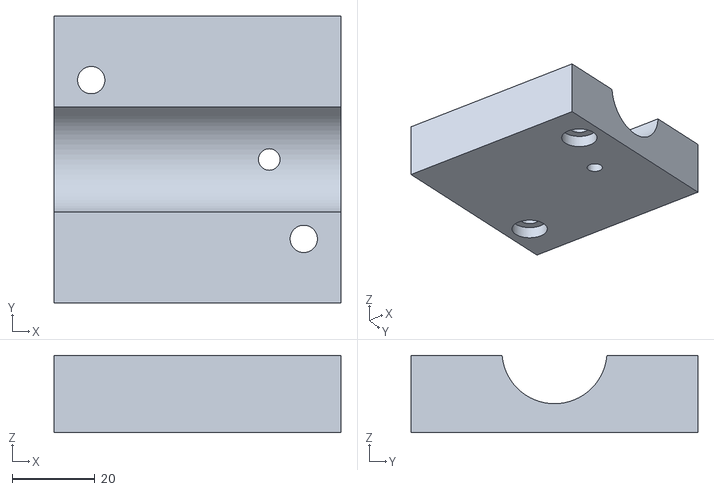
[picture p84: CAD file, 2026-10-04]
hardware/anclajes/stl/cruceta_brazo_tubo_tapa.stl
69.4 x 69.4 x 18.7
