Brico-Hams/bricohams-sdr/hardware/antenas/stl/mla_cruz.stl

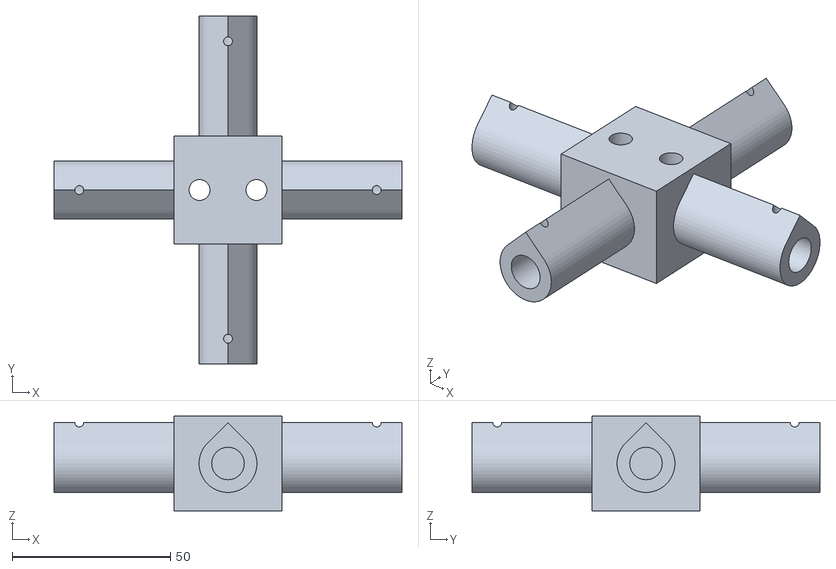
[picture p85: CAD file, 2026-10-16]
hardware/antenas/stl/mla_cruz.stl
110.0 x 110.0 x 30.0
