Brico-Hams/bricohams-sdr/hardware/caja/stl/garita_plato.stl

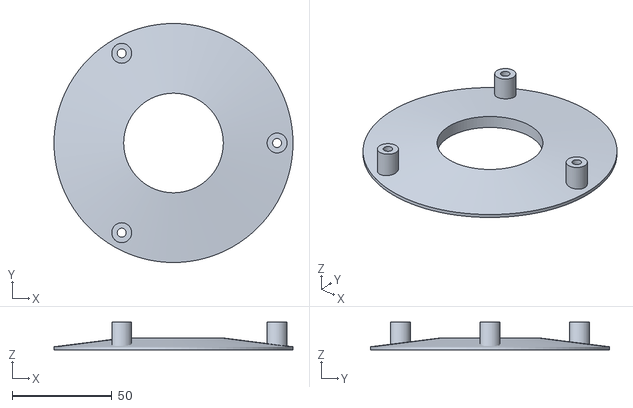
[picture p86: CAD file, 2026-10-04]
hardware/caja/stl/garita_plato.stl
120.0 x 120.0 x 14.0
