Brico-Hams/bricohams-sdr/hardware/caja_v3/stl/potencia_cuerpo.stl

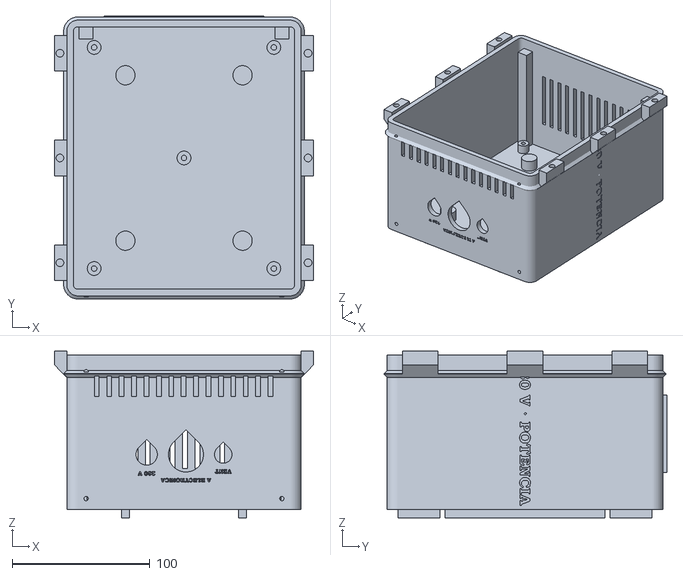
[picture p87: CAD file, 2026-11-01]
hardware/caja_v3/stl/potencia_cuerpo.stl
188.0 x 205.3 x 121.0
