Brico-Hams/bricohams-sdr/hardware/anclajes/stl/cruceta_mastil_quad_cuerpo.stl

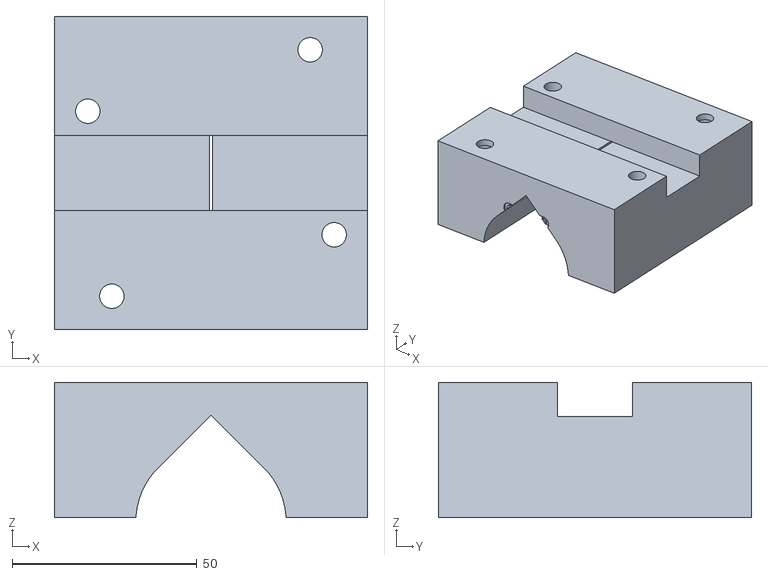
[picture p88: CAD file, 2026-10-04]
hardware/anclajes/stl/cruceta_mastil_quad_cuerpo.stl
84.6 x 84.6 x 36.5
