Brico-Hams/bricohams-sdr/hardware/antenas/stl/quad_abrazadera.stl

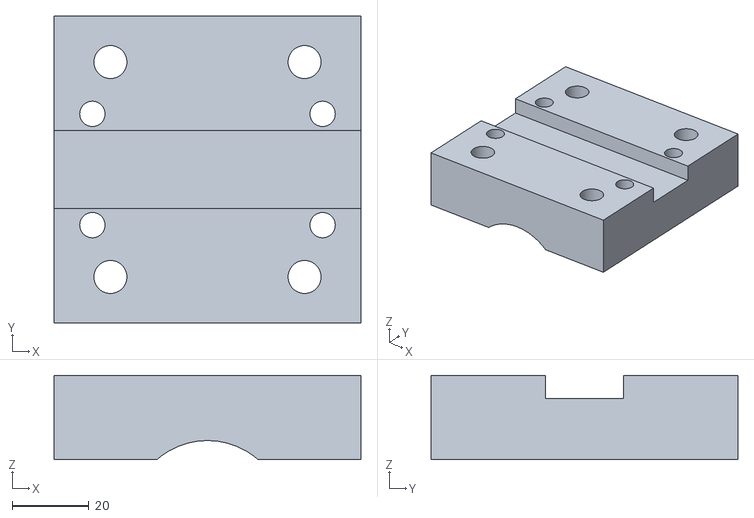
[picture p89: CAD file, 2026-10-16]
hardware/antenas/stl/quad_abrazadera.stl
80.0 x 80.0 x 22.0
