Brico-Hams/bricohams-sdr/hardware/caja/stl/cuerpo.stl

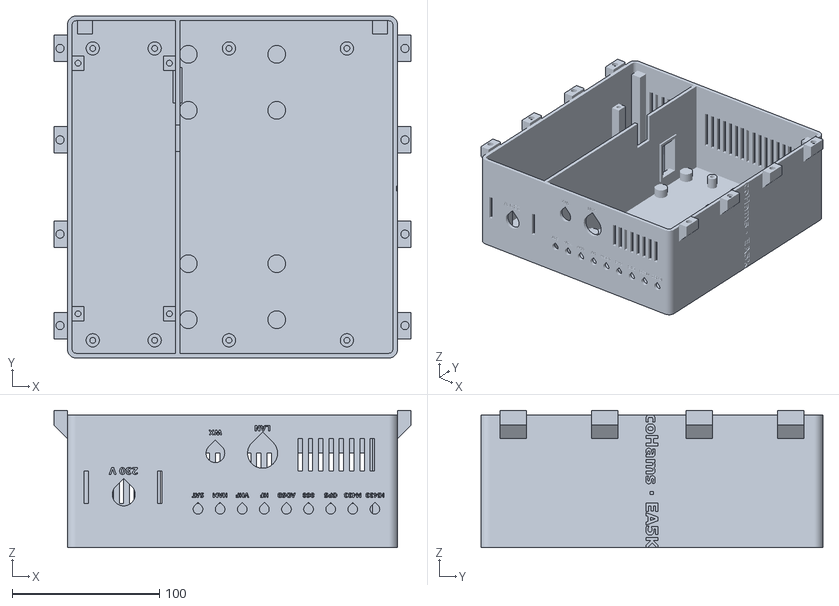
[picture p90: CAD file, 2026-10-04]
hardware/caja/stl/cuerpo.stl
242.0 x 232.0 x 93.0
