Brico-Hams/bricohams-sdr/hardware/caja_v3/stl/electronica_tapon_n.stl

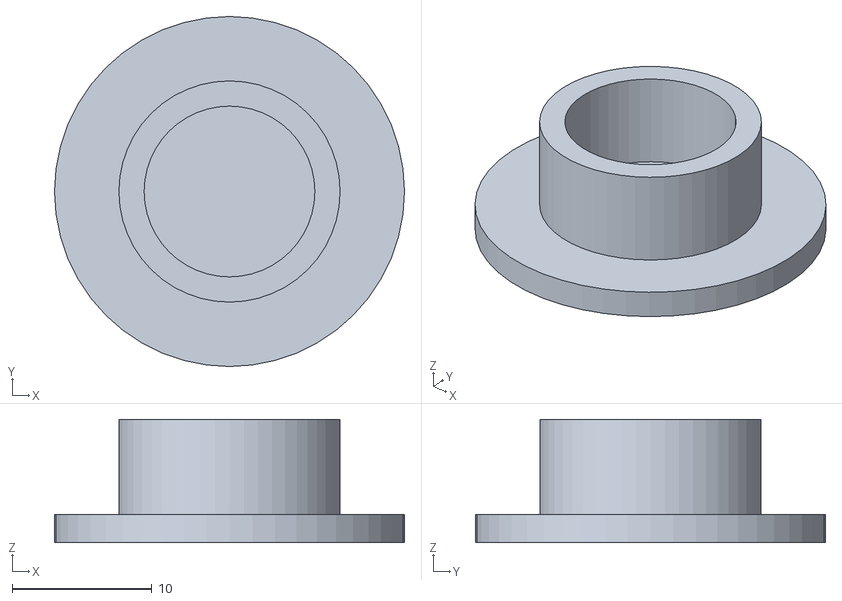
[picture p91: CAD file, 2026-11-01]
hardware/caja_v3/stl/electronica_tapon_n.stl
25.0 x 25.0 x 8.80
