Brico-Hams/bricohams-sdr/hardware/caja_v3/stl/potencia_tapa.stl

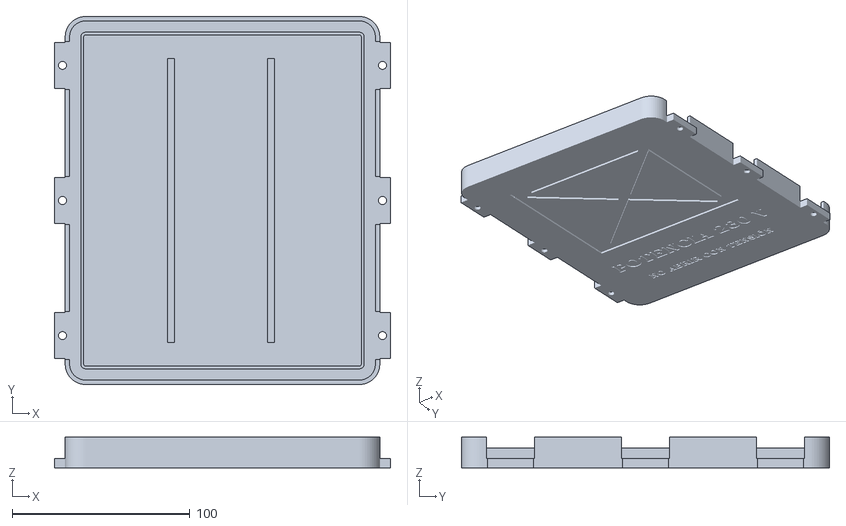
[picture p93: CAD file, 2026-11-01]
hardware/caja_v3/stl/potencia_tapa.stl
189.0 x 207.0 x 17.2
