Brico-Hams/bricohams-sdr/hardware/caja_v3/stl/sai_junta_tapa.stl

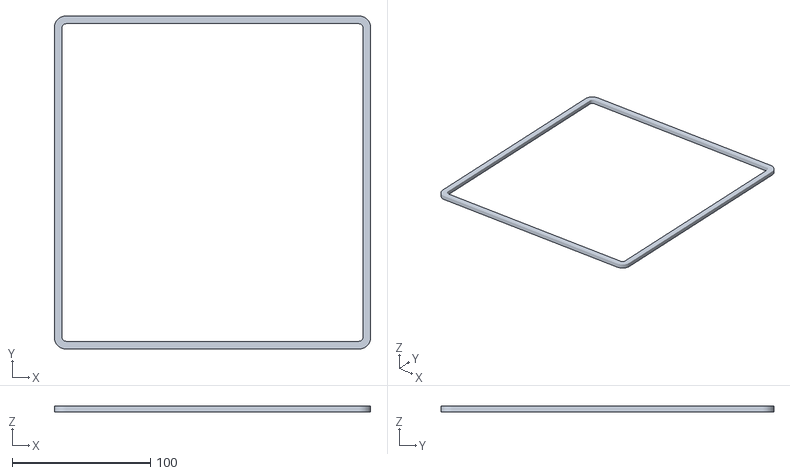
[picture p95: CAD file, 2026-11-01]
hardware/caja_v3/stl/sai_junta_tapa.stl
228.8 x 240.8 x 4.00
