Brico-Hams/bricohams-sdr/hardware/antenas/stl/quad_alim_70.stl

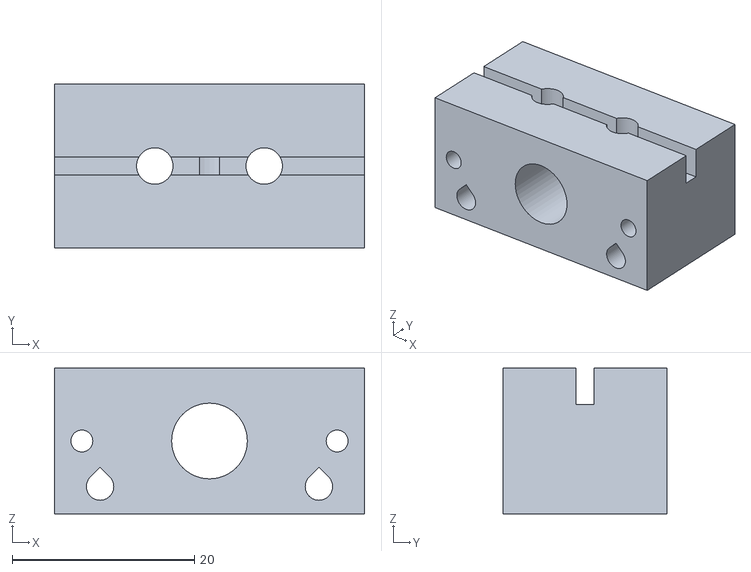
[picture p96: CAD file, 2026-10-16]
hardware/antenas/stl/quad_alim_70.stl
34.0 x 18.0 x 16.0
