Brico-Hams/bricohams-sdr/hardware/antenas/stl/adsb_tapa.stl

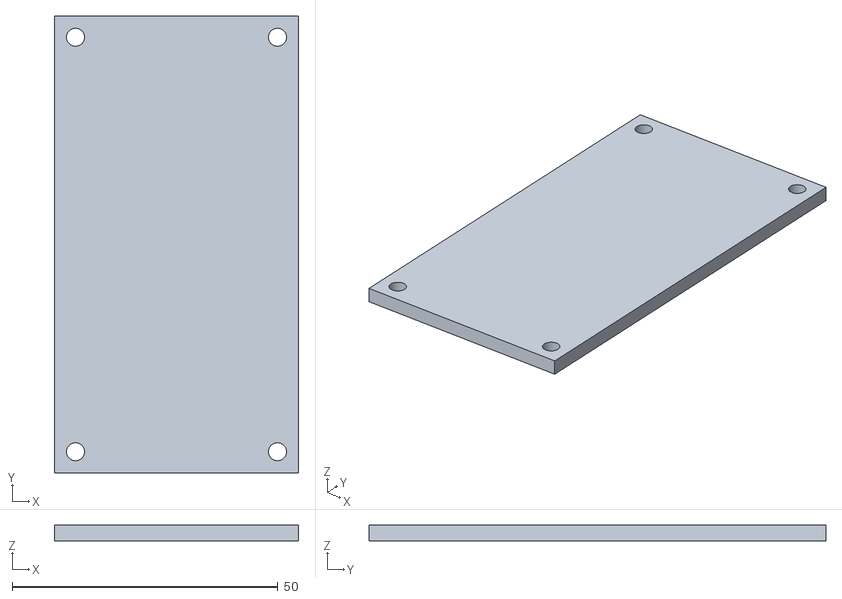
[picture p97: CAD file, 2026-10-16]
hardware/antenas/stl/adsb_tapa.stl
46.0 x 86.0 x 3.00
