Brico-Hams/bricohams-sdr/hardware/caja_v3/stl/sai_cuerpo.stl

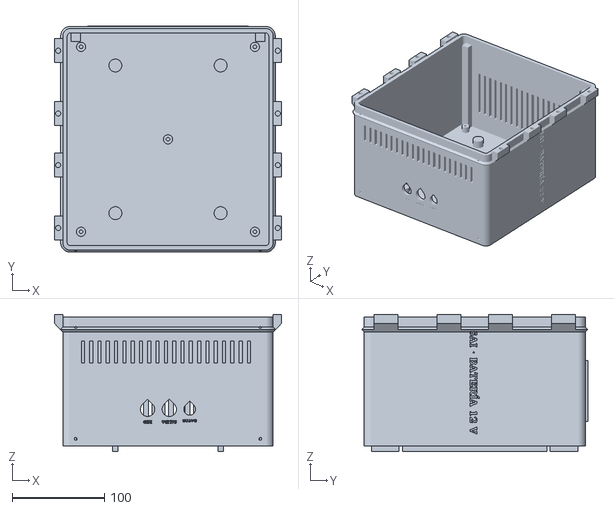
[picture p98: CAD file, 2026-11-01]
hardware/caja_v3/stl/sai_cuerpo.stl
246.0 x 245.3 x 149.0
