Brico-Hams/bricohams-sdr/hardware/caja_v3/stl/potencia_tejadillo.stl

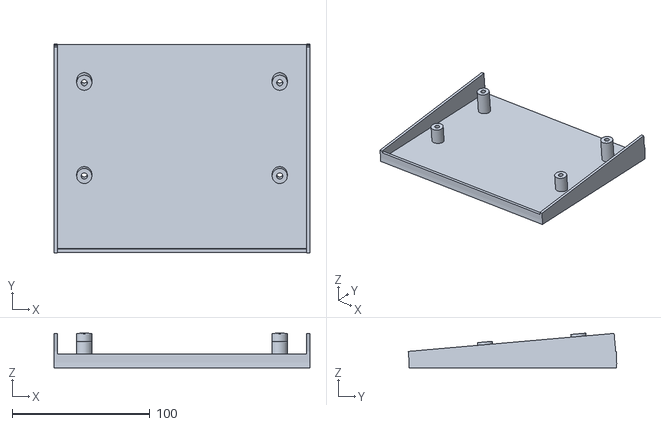
[picture p100: CAD file, 2026-11-01]
hardware/caja_v3/stl/potencia_tejadillo.stl
186.0 x 151.6 x 25.3
