Brico-Hams/bricohams-sdr/hardware/caja_v3/stl/sai_soporte_mastil.stl

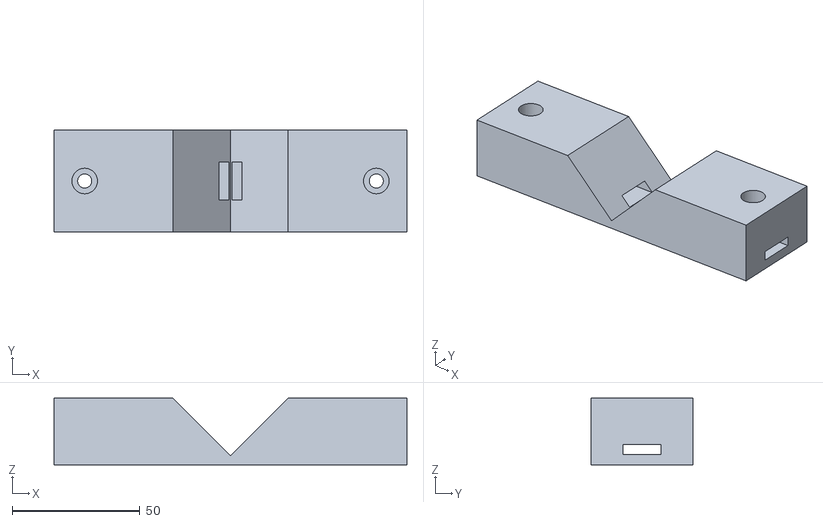
[picture p102: CAD file, 2026-11-01]
hardware/caja_v3/stl/sai_soporte_mastil.stl
138.0 x 40.0 x 26.0
