Brico-Hams/bricohams-sdr/hardware/antenas/stl/adsb_radomo.stl

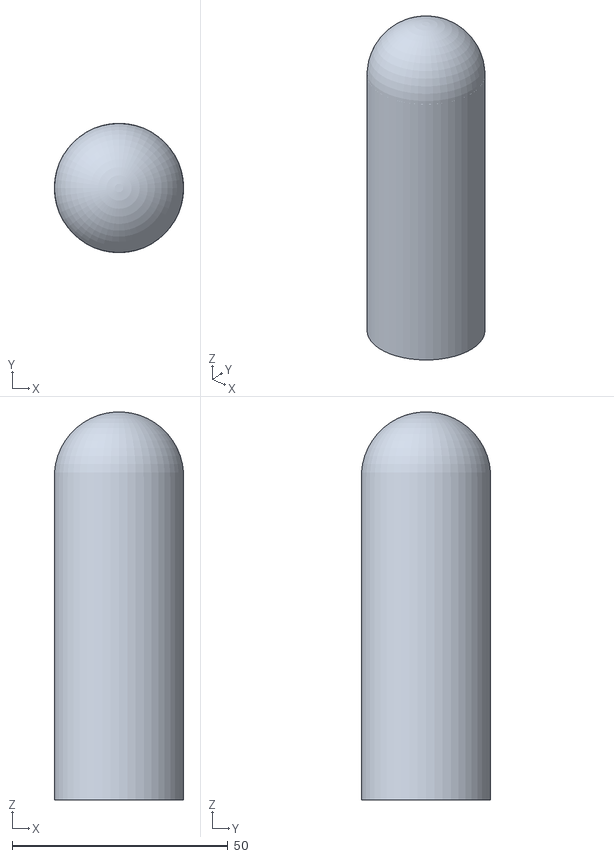
[picture p103: CAD file, 2026-10-16]
hardware/antenas/stl/adsb_radomo.stl
30.0 x 30.0 x 90.0
