Brico-Hams/bricohams-sdr/hardware/caja_v3/stl/electronica_visera.stl

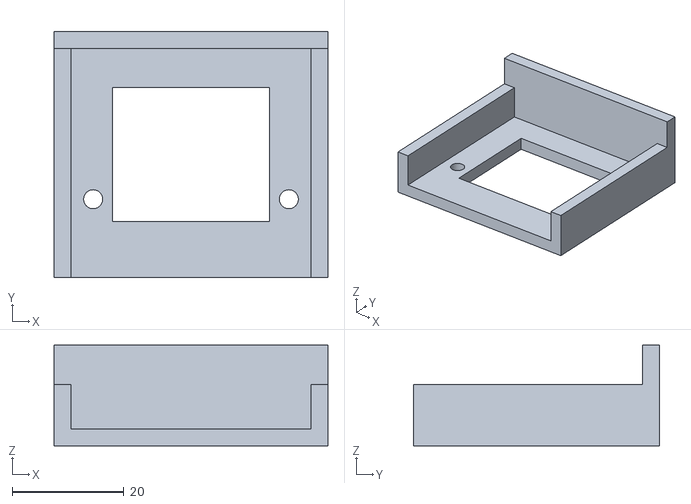
[picture p104: CAD file, 2026-11-01]
hardware/caja_v3/stl/electronica_visera.stl
49.0 x 44.0 x 18.0
