Brico-Hams/bricohams-sdr/hardware/antenas/stl/discone_aislador.stl

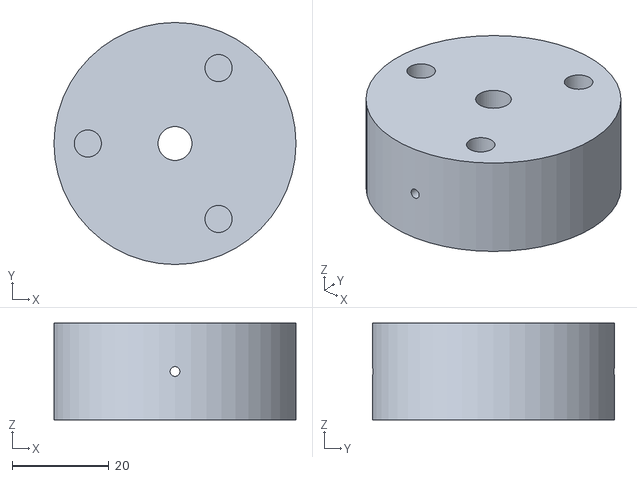
[picture p105: CAD file, 2026-10-16]
hardware/antenas/stl/discone_aislador.stl
50.0 x 50.0 x 20.0
