Brico-Hams/bricohams-sdr/hardware/caja_v3/stl/electronica_tapon_pg.stl

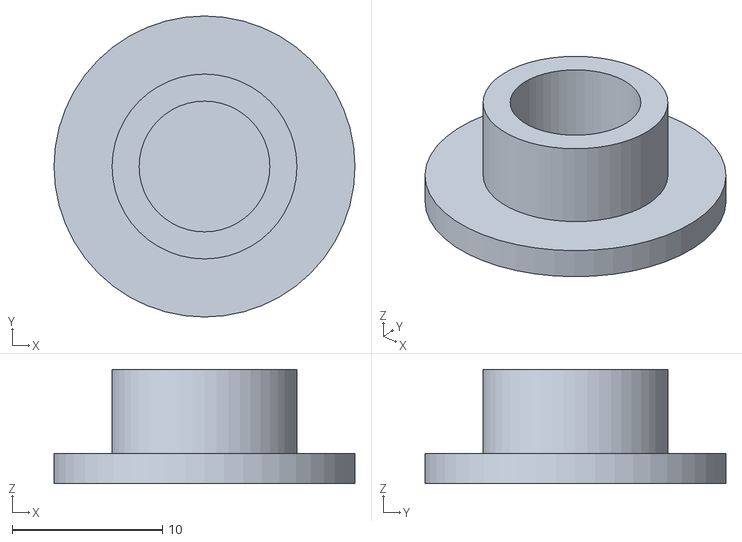
[picture p108: CAD file, 2026-11-01]
hardware/caja_v3/stl/electronica_tapon_pg.stl
20.0 x 20.0 x 7.60
