Brico-Hams/bricohams-sdr/hardware/antenas/stl/mla_caja_tapa.stl

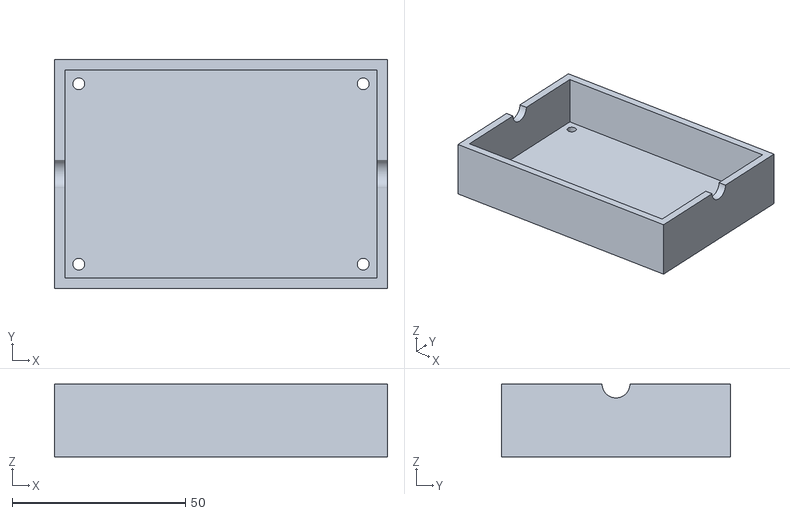
[picture p109: CAD file, 2026-10-04]
hardware/antenas/stl/mla_caja_tapa.stl
96.0 x 66.0 x 21.0
