Brico-Hams/bricohams-sdr/hardware/caja_v3/stl/electronica_soporte_hub.stl

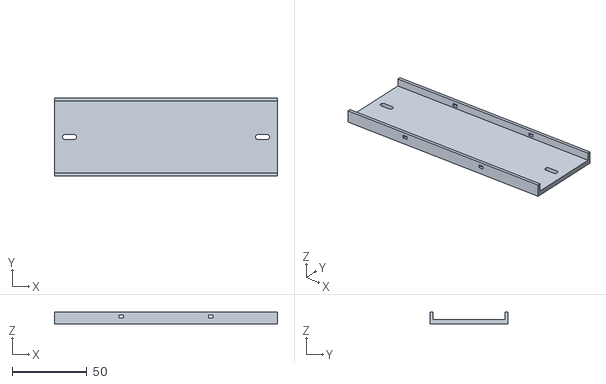
[picture p110: CAD file, 2026-11-01]
hardware/caja_v3/stl/electronica_soporte_hub.stl
149.0 x 52.0 x 8.00
