Brico-Hams/bricohams-sdr/hardware/antenas/stl/soporte_fibra.stl

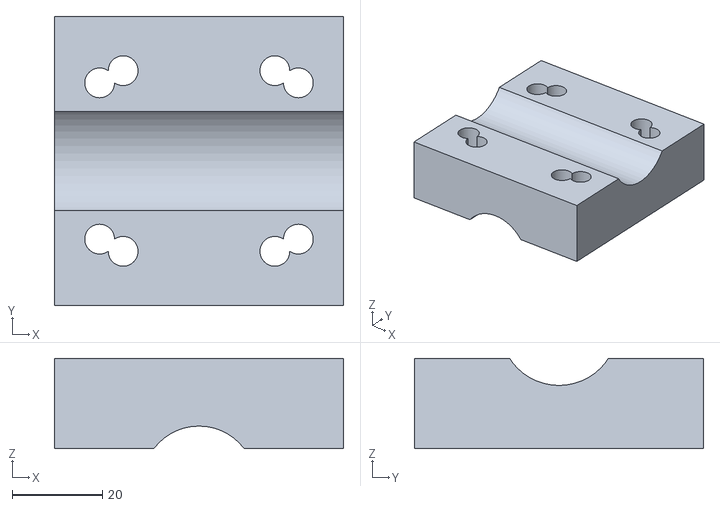
[picture p111: CAD file, 2026-10-04]
hardware/antenas/stl/soporte_fibra.stl
64.0 x 64.0 x 20.0
