Brico-Hams/bricohams-sdr/hardware/caja_v3/stl/potencia_soporte_schuko.stl

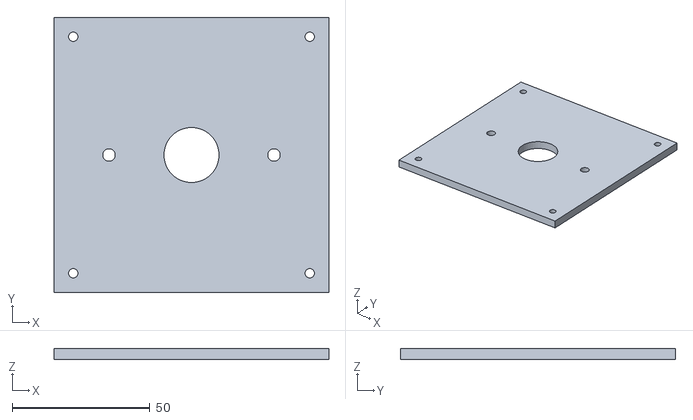
[picture p112: CAD file, 2026-10-29]
hardware/caja_v3/stl/potencia_soporte_schuko.stl
100.0 x 100.0 x 4.00
