Brico-Hams/bricohams-sdr/hardware/antenas/stl/mla_caja_base.stl

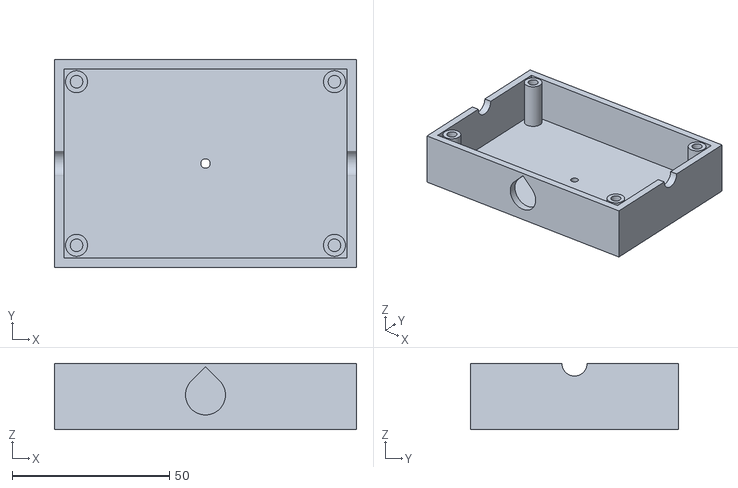
[picture p113: CAD file, 2026-10-04]
hardware/antenas/stl/mla_caja_base.stl
96.0 x 66.0 x 21.0
