Brico-Hams/bricohams-sdr/hardware/caja_v3/stl/sai_pletina_pared.stl

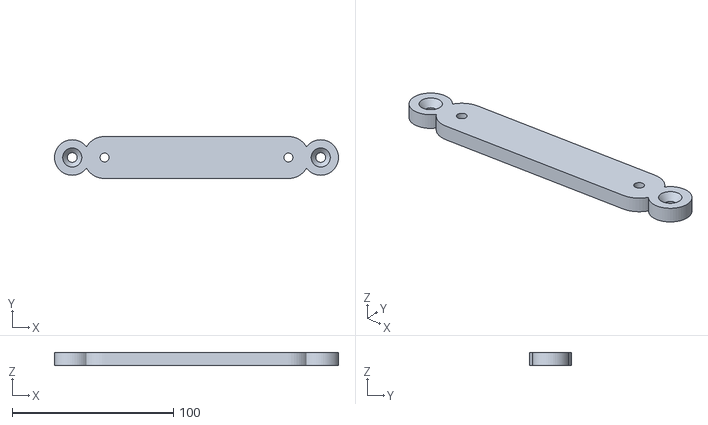
[picture p114: CAD file, 2026-10-29]
hardware/caja_v3/stl/sai_pletina_pared.stl
176.0 x 26.0 x 8.00
