Brico-Hams/bricohams-sdr/hardware/antenas/stl/funda_sma.stl

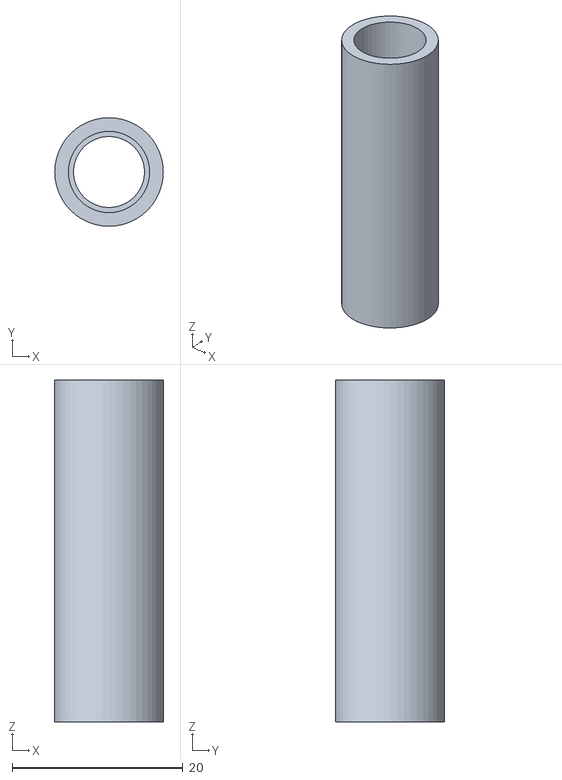
[picture p115: CAD file, 2026-10-04]
hardware/antenas/stl/funda_sma.stl
12.7 x 12.7 x 40.0
