Brico-Hams/bricohams-sdr/hardware/caja_v3/stl/electronica_capota.stl

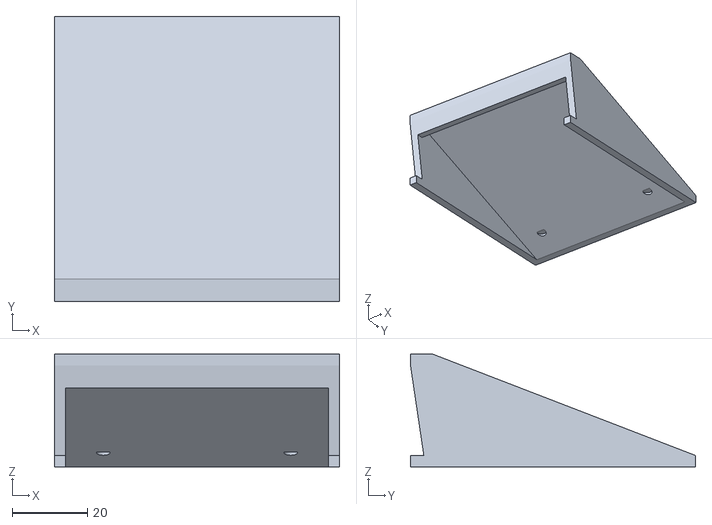
[picture p116: CAD file, 2026-10-29]
hardware/caja_v3/stl/electronica_capota.stl
76.0 x 76.0 x 30.0
