Brico-Hams/bricohams-sdr/hardware/caja_v3/stl/sai_soporte_filtro.stl

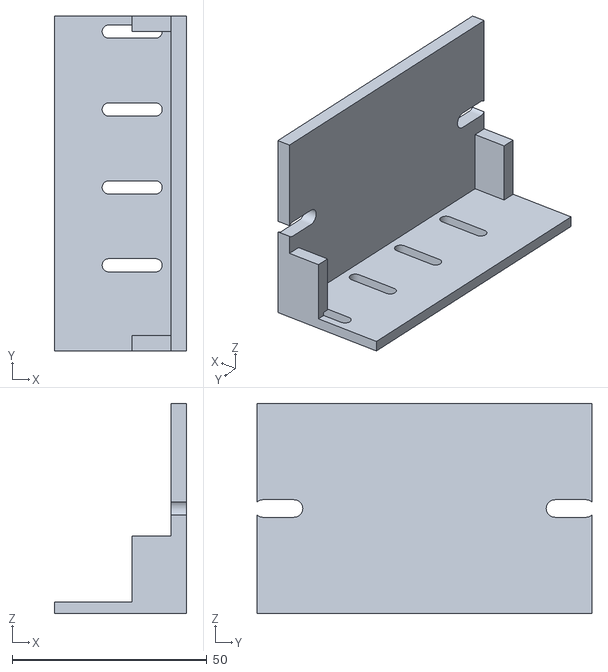
[picture p118: CAD file, 2026-10-29]
hardware/caja_v3/stl/sai_soporte_filtro.stl
34.0 x 86.0 x 54.0
