Brico-Hams/bricohams-sdr/hardware/caja_v3/stl/electronica_soporte_dongle.stl

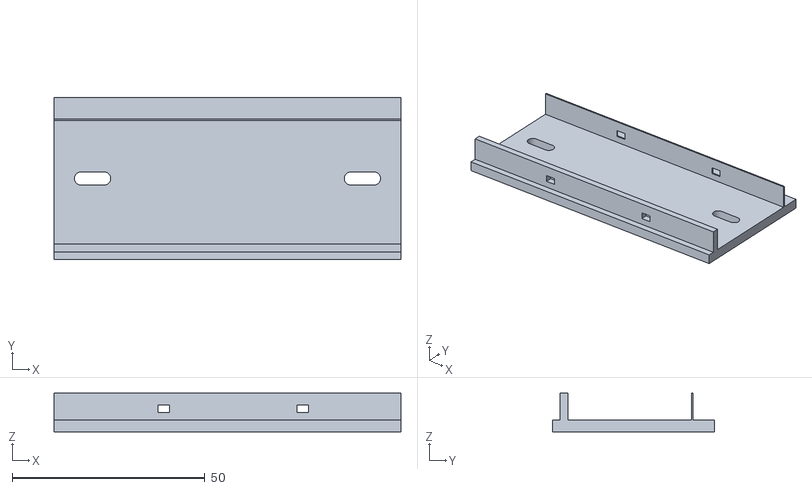
[picture p119: CAD file, 2026-10-17]
hardware/caja_v3/stl/electronica_soporte_dongle.stl
90.0 x 42.0 x 10.0
