Brico-Hams/bricohams-sdr/hardware/caja_v3/stl/electronica_soporte_lilygo.stl

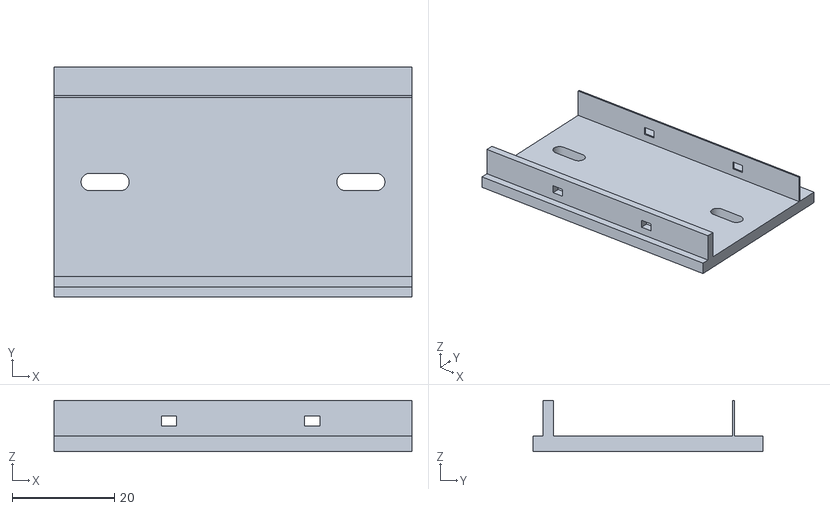
[picture p120: CAD file, 2026-10-17]
hardware/caja_v3/stl/electronica_soporte_lilygo.stl
70.0 x 45.0 x 10.0
