Brico-Hams/bricohams-sdr/hardware/caja_v3/stl/electronica_soporte_rak.stl

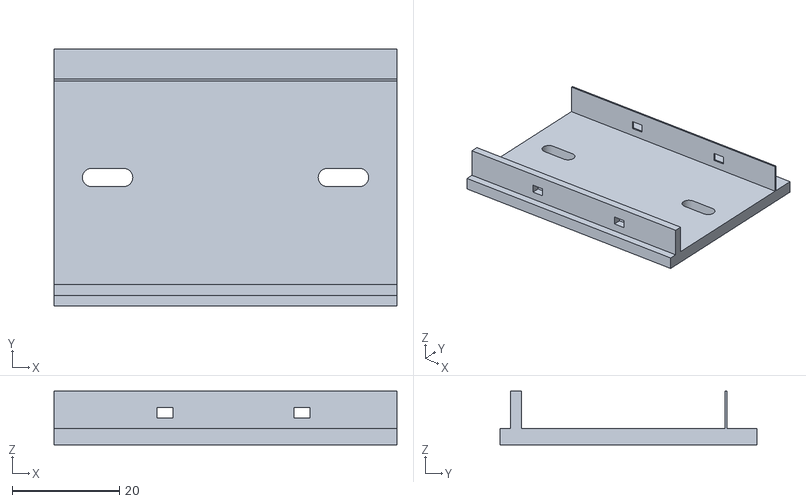
[picture p123: CAD file, 2026-10-17]
hardware/caja_v3/stl/electronica_soporte_rak.stl
64.0 x 48.0 x 10.0
