Brico-Hams/bricohams-sdr/hardware/caja_v3/stl/potencia_pletina_pared.stl

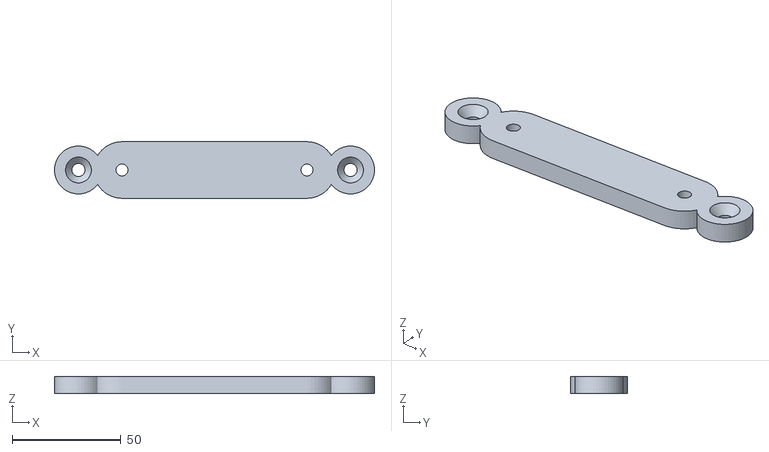
[picture p125: CAD file, 2026-10-17]
hardware/caja_v3/stl/potencia_pletina_pared.stl
147.0 x 26.0 x 8.00
