Brico-Hams/bricohams-sdr/hardware/caja_v3/stl/electronica_bandeja.stl

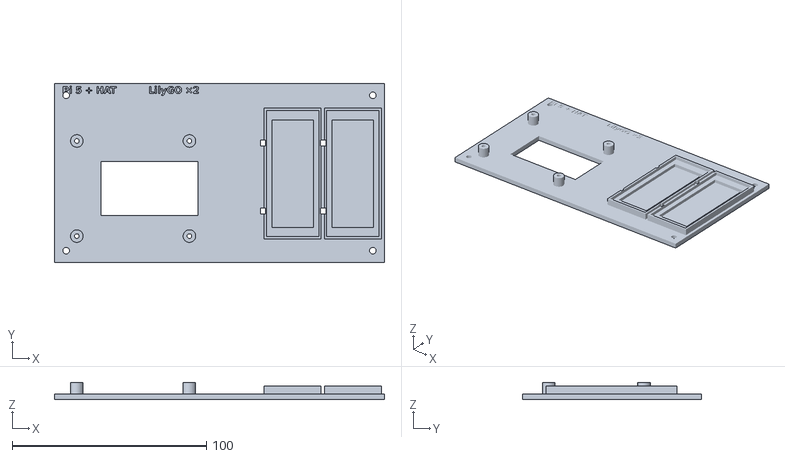
[picture p128: CAD file, 2026-10-16]
hardware/caja_v3/stl/electronica_bandeja.stl
170.0 x 92.0 x 9.00
