Brico-Hams/bricohams-sdr/hardware/caja_v3/stl/potencia_tapon_pg.stl

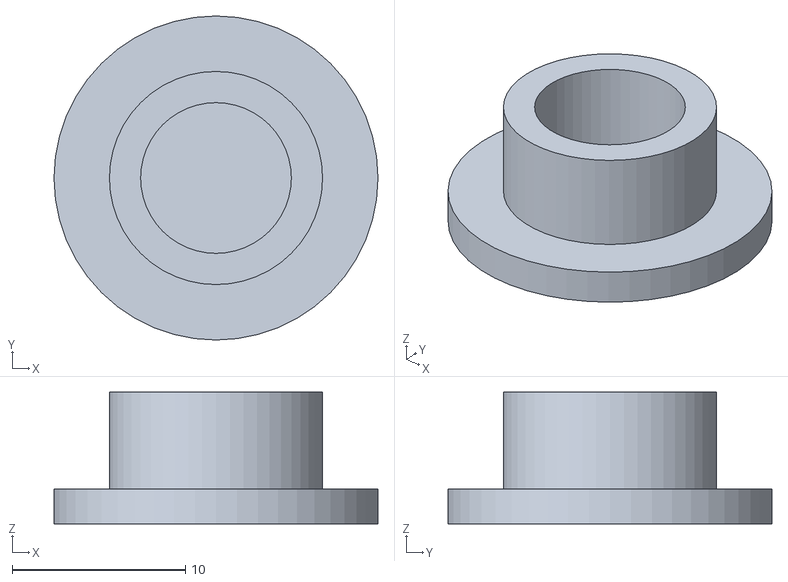
[picture p129: CAD file, 2026-10-16]
hardware/caja_v3/stl/potencia_tapon_pg.stl
18.7 x 18.7 x 7.60
