Brico-Hams/bricohams-sdr/hardware/caja_v3/stl/electronica_junta_tapa.stl

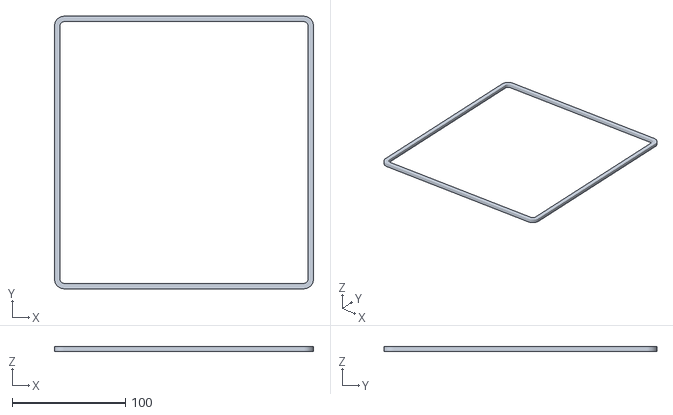
[picture p130: CAD file, 2026-10-16]
hardware/caja_v3/stl/electronica_junta_tapa.stl
229.2 x 241.2 x 4.00
