Brico-Hams/bricohams-sdr/(list of files, cad)

Other CAD files:
hardware/anclajes/stl/cruceta_mastil_quad_tapa_mastil.stl
hardware/caja_v3/stl/sai_tapa.stl
hardware/anclajes/stl/cruceta_brazo_fibra_tapa_fibra.stl
hardware/caja_v3/stl/electronica_placa_rejilla.stl
hardware/caja_v3/stl/electronica_soporte_mastil.stl
hardware/caja_v3/stl/electronica_pletina_pared.stl
hardware/caja_v3/stl/electronica_poste_bandeja.stl
hardware/caja_v3/stl/electronica_soporte_wago.stl
