Brico-Hams/bricohams-sdr/docs/manuales/28_FT2.md

# 28 · FT2 en OpenWebRX+ (EXPERIMENTAL)

**Qué es FT2:** un modo digital de IU8LMC (Martino Merola), aprobado por ADIF en marzo de 2026.
- Cada ciclo dura **3,75 s**.
- Usa 4-GFSK, LDPC (174,91) y unos 167 Hz de ancho.
- Las frecuencias de dial están en los marcadores 🔢 FT2. En 40 m es **7,052 MHz**.

**El problema:** OpenWebRX+ (1.2.125) **no trae FT2**, y el `jt9` de WSJT-X tampoco lo decodifica.

## Cómo lo hemos integrado (ADR-35)
1. **Decodificador:** `decodium-rx`, el programa de terminal de **Decodium 4.0 «Core Shannon»** (GPLv3, https://github.com/iu8lmc/Decodium-4.0-Core-Shannon).
   - Lo compila `bricohams-ft2 compilar`. Solo compila ese programa, no la interfaz gráfica, pero hacen falta las librerías de desarrollo de Qt6.
   - Tarda 20–40 min en la Pi 5 y ocupa unos 700 MB.
   - Lo probamos en un PC: decodifica correctamente los WAV de prueba.
2. **Adaptador:** `bricohams-ft2-decode` ejecuta `decodium-rx -m ft2 --wav` sobre cada trozo de 3,75 s y **escribe las líneas con el mismo formato que `jt9`**. Así el analizador de FT8/FT4 de OpenWebRX+ las entiende sin cambios: mapa, PSK Reporter y banderas incluidos.
3. **Parche:** `bricohams-ft2-patch` añade a OpenWebRX+ la clase `Ft2Profile` (ciclo de 3,75 s), el modo `FT2` y «FT2» en el panel de mensajes.
   - Los cambios llevan la marca `BRICOHAMS-FT2`. Se puede repetir y **quitar** (`--quitar`).
   - Un *hook* de apt lo vuelve a aplicar después de cada actualización de `openwebrx`.

## Uso
```bash
sudo bricohams-ft2 estado
sudo bricohams-ft2 compilar     # si el instalador no lo hizo (FT2_ENABLE="yes")
sudo bricohams-ft2 activar
sudo bricohams-ft2 probar       # decodifica el WAV de prueba del kit: «CQ EA5KAO IM98»
```
- **En la web:** pulsa un marcador 🔢 FT2 y elige el modo **FT2** en la lista de modos digitales. Los mensajes salen en el panel de FT8/FT4, con bandera.

## Avisos
- **Es experimental:**
  - si una versión nueva de OpenWebRX+ cambia los ficheros, el parche **no se aplica** y lo dice (`bricohams-check` → «FT2 no activo»). El resto de la estación sigue funcionando;
  - el ciclo de 3,75 s exige una hora exacta: el GPS + PPS del HAT con chrony la da.
- **Para quitarlo:** `sudo bricohams-ft2 quitar`, y deja OpenWebRX+ como venía.
