Brico-Hams/bricohams-sdr/hardware/caja/render/montaje_trasera.png

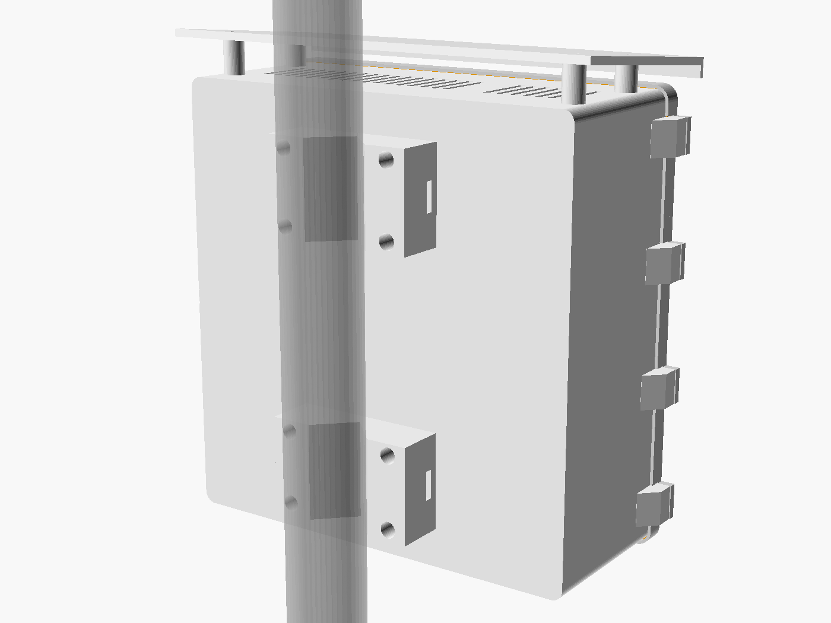
hardware/caja/render/montaje_trasera.png
