Brico-Hams/bricohams-sdr/hardware/caja_v3/render/potencia_montaje.png

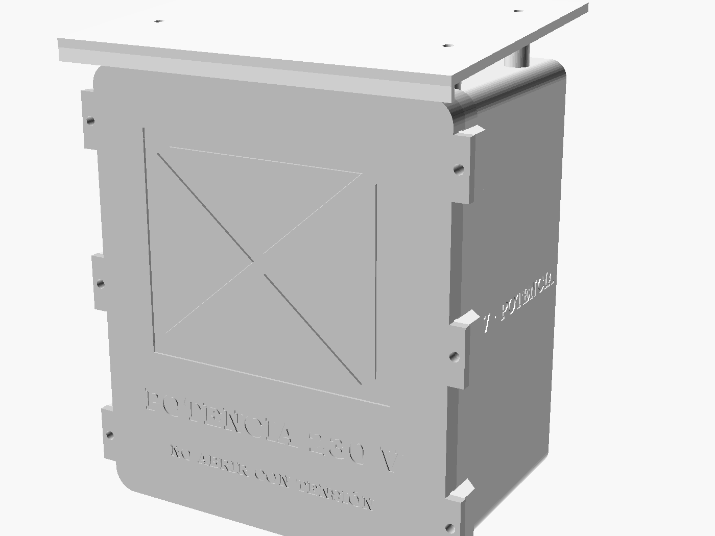
hardware/caja_v3/render/potencia_montaje.png
