Brico-Hams/bricohams-sdr/hardware/caja_v3/render/sai_montaje.png

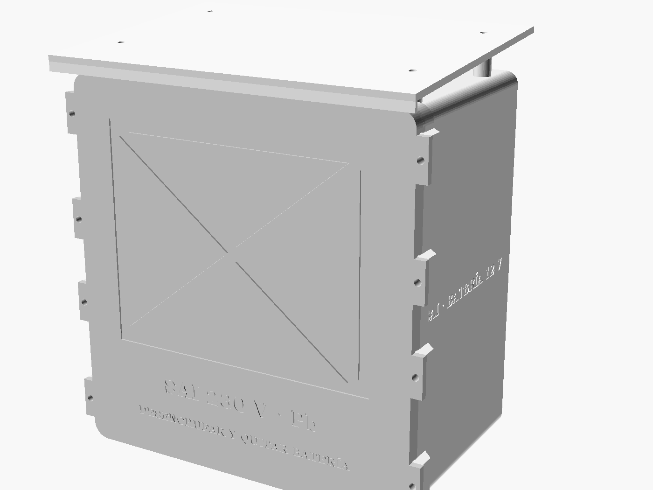
hardware/caja_v3/render/sai_montaje.png
