Brico-Hams/bricohams-sdr/(commit log)

2026-10-12 v5.1: interfaz web APRS y Meshtastic 433, firmware RAK 1.0.1, GitHub sin datos personales
    - Panel /settings/bricohams/aprs: mensajes APRS con acuse, baliza a demanda,
    estaciones oídas, digipeater automático (RAK_DIGI="auto"), bootloader y
    puesta en marcha; API local 127.0.0.1:8077 en bricohams-rak-aprs (Pasarela).
    - bricohams-mesh-puente: único dueño del USB del LilyGO 433 (TCP 4404 + HTTP
    4480) y cliente web oficial de Meshtastic en :8444 solo para el admin.
    - Firmware RAK 1.0.1 (sin nan en el JSON) + VERSION.json; órdenes bootloader,
    gps y puesta-en-marcha.
    - Repositorio despersonalizado; tools/datos_personales.py (huellas SHA-256) y
    tools/git_sanear.sh; .gitignore restaurad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
2026-10-17 v5.4.0: alinear distribucion publica con la linea privada
    Publicacion anonimizada con chat Meshtastic, Telegram, clima, WSPR, satelites y correcciones visuales. Conserva el historial publico y sus recursos exclusivos sin incorporar commits privados.
2026-10-17 docs: limpiar referencias de herramientas en la distribucion publica
2026-10-17 docs y funciones: agendas, avisos, filtros de satelites y esquemas v5.4
2026-10-17 hardware: redisenar cajas v3 y preparar SDR futuros y potencia
    Regenera STL y vistas, incorpora bandeja SDR adicional y cuna RAK, y documenta la reserva de potencia y configuracion futura.
2026-10-17 docs: anadir guias Kobra S1 ASA y laboratorio RF NanoVNA
    Incluye calibracion y mantenimiento de impresora, procedimientos RF, hojas CSV de trazabilidad y cualificacion, ilustraciones y capturas de referencia.
2026-10-17 chore(license): adopt BricoHams licensing scheme
    Software: MIT. Hardware design files (PCB, fabrication): CERN-OHL-S-2.0.
    3D models, CAD and documentation: CC BY-SA 4.0. Third-party credits and
    components keep their own terms.
2026-10-19 funciones: puente chat web-Telegram y archivo permanente de Files
    - /chat@bot en el grupo de Telegram responde en el chat web (PuenteTelegram via MQTT), sin eco y con reintento.
    - bricohams-archivo-files: copia verificada (SHA-256) de todo Files a satelites/archivo/AAAA-MM; Files deja los 2 ultimos; keep_files 100 y SATREC_EN_FILES 2.
    - tools/actualizar-archivo-files.sh con backup verificado y RESTAURAR.sh.
    - Manuales 24 (seccion 9) y 42 (seccion 8): problemas detectados, diagnostico y correccion; CHANGELOG.
2026-10-19 Manual 42: problema 7, comillas de PowerShell 5.1 en ordenes ssh
2026-10-20 Acceso de administradores: usuarios locales y/o Google (v5.5)
    - Pasarela OIDC bricohams-google-auth (alternativa, doble, solo_google).
    - Tarjeta Metodos de acceso en el panel Seguridad, con antibloqueo.
    - Referencias de configuracion en el modulo y en la web; manual 46 y ADR-71.
2026-10-20 Limpieza de copias de despliegue antiguas antes de desplegar
    - tools/limpiar-copias-despliegue.sh: conserva la ultima de cada tipo y solo borra con BORRAR.
    - Manual 46 7 y CHANGELOG.
2026-10-22 Auditoría de entrega: limpieza de documentación y código
    - ARQUITECTURA: redacta como requisito un resto de conversación.
    - Manual 46: elimina la referencia a un script no distribuido.
    - Quita imports no usados y el BOM que impedía ejecutar
    presupuesto_potencia.py por su shebang.
2026-10-28 fix(satrec): check offered profiles before selecting one
    Selecting a profile whose receiver is unavailable (SDR gone after a USB
    over-current) makes OpenWebRX+ 1.2.x raise KeyError in isLocked and leaves
    a hung websocket. Wait for the profiles list and fail with a clear error.
2026-10-28 feat(rotor): track recorded satellite passes with the PortableSatLite rotor
    New optional bricohams-rotor service (ROTOR_ENABLE): it follows the passes
    bricohams-satrec records, pre-positions at AOS, sends SGP4 az/el over the
    home Wi-Fi with an API key, skips METEOR and parks outside passes, with
    strong gusts or stale meteo.json. Manual 49 and tests/test_rotor.py.
2026-10-28 feat(satellites): add MARMOTSat (CO-128) to the pass list
    NORAD 69912 for tracking (SatNOGS id 98272), 145.875 MHz NFM on the sat2m
    profile, so it gets pass alerts, recordings and rotor tracking. Its V/V
    digipeater is FSK 1200 with AX.100 mode 5 framing, which the OpenWebRX+
    packet decoder cannot read: only the audio is recorded.
2026-10-28 feat(hf): Hermes Lite 2 receiver and HF antenna guide
    Optional HPSDR receiver (HF_HERMES) with 384 kHz profiles from 160 to
    10 m plus a 29.4 MHz satellite profile; it replaces the V3 direct
    sampling HF profiles. hpsdrconnector comes from the OpenWebRX+ repo or,
    on trixie where it is missing, from the bookworm package pinned by
    SHA256 (static Go binary). Manual 50 adds HF antenna recommendations.
2026-10-29 feat(idioma): switch bilingual custom texts with the ES/EN button
    Own texts such as the receiver description can now carry both versions
    marked with data-lang="es" / "en"; the plugin shows only the active
    language, also for content that arrives after the page loads.
2026-11-01 feat(caja_v3): weatherproofing, design climate and thermal study
    Harden the outdoor enclosure for the Murcia climate (47 C design air,
    wind-driven rain): lid drip skirt over the wall, TPU gasket at 25 %
    compression, floor weep holes, PG7 membrane breather, rain curbs on the
    top grilles, longer roof with side skirts and plug heads that cover the
    teardrop tip. All printed parts move to ASA (PETG is too close to the
    55-65 C interior). Add tools/termica_caja.py with its test (heat load,
    solar gain, airflow per module), retune the fan curve defaults, place
    the 10-port Amazon Basics hub, document the maximum UPS transformer size
    and regenerate the STLs with OpenSCAD. Renders are left for a Linux r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
2026-11-01 feat: Camera Module 3 Wide, telescopic mast and bought antennas
    Replace the WPI408 with the Raspberry Pi Camera Module 3 Wide: 25 x 24 mm
    board on M2 bosses, lens 3 mm behind a sealed glass so the 102 x 67 deg
    field is not vignetted (20 x 16 mm window), new visor and asserts.
    Model the 3 x 3 m telescopic mast (8.20 m, 0.35-0.45 m overlaps) under
    the CTE basic wind for Murcia: it needs two guy levels (77 MPa, 26 mm
    deflection with guys; >1000 MPa without). Add the Diamond X50 and the
    Moonraker SkyScan discone, document the 120 W charger label checks and
    regenerate the enclosure STLs. Section sizes, anchor and guy levels stay
    marked as pending until measured.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
2026-11-01 caja v3: thicker walls for outdoor weather resistance
    - Body wall/floor T 3.6 -> 4.8 mm (12 lines), lid 4.4 -> 5.2 mm
    - Lid groove 4.6 -> 5.8; TPU gasket 4.4 -> 5.6 (still narrower than the groove)
    - Electronics module depth 190 -> 192 so the Pi + HAT clears the lid
    - SAI layout: trafo cradle 84 wide, EMI filters 2 mm left, DC block 84
    - SDR tray DECK_O [30,54] -> [31,55] to follow the shifted grid
    - Regenerated STLs (OpenSCAD 2026.10 nightly, manifold); renders not updated
2026-11-02 fix(camera): serve public mast video through HTTPS only
2026-11-02 feat(sondas): track AEMET radiosondes on the map and weather page
    New optional module (SONDAS_ENABLE, off by default) for a dedicated
    RTL-SDR: radiosonde_auto_rx in Docker scans 400.05-406 MHz (403.4 MHz,
    Murcia 08430, always included) and a stdlib bridge turns its UDP
    payload summaries into sondas.json for the OpenWebRX+ map layer and the
    weather page, with optional MQTT publishing and throttled SondeHub
    landing predictions. Credentials stay in a 600 file via LoadCredential.
2026-11-03 fix(ft2): pin Decodium, AP with the station call, no stacked decodes
    - Build Decodium-4.0-Core-Shannon from a pinned commit (FT2_DECODIUM_REF)
    and record it; no more silent "git pull || true".
    - Pass the station callsign for a-priori decoding, widen the audio band
    to 5 kHz and keep each decode under the 3.75 s period with a lock that
    skips a slot instead of stacking processes.
    - Parse every time format the decoder prints; tests no longer depend on
    a third-party callsign.
    - Fix the Decodium link in REFERENCIAS.md and add the GPLv3 and IU8LMC
    permission attribution.
2026-11-03 fix(sdr): show current connection details in visitors popover
2026-11-03 style: apply the official BricoHams colour manual v1.1
    Graphite #23272B and orange #F26B1D with the manual's exact light and dark
    tokens on every BricoHams page and OpenWebRX+ plugin: orange buttons with
    graphite text, AA links (#AA410B / #FFA06A), visible focus, light/dark/
    system theme switch and the original logo on a white plate in dark mode.
    Adds docs/BRANDING.md and a test that bans the old palette.
2026-11-09 docs(hardware): add step-by-step assembly manual for all printed parts
    Manual 52 covers the 110 STL with a master table, numbered steps, checks
    and nine new diagrams (31-39), adapted to this repo's .scad values and
    the Camera Module 3 Wide. No station-specific data.
2026-11-09 docs(hardware): add part images and exploded assembly views to manual 52
    View-only OpenSCAD modes (vista_despiece_*/vista_montado_*) adapted to
    this repo's models, tools/render_montaje.sh, and 172 rendered PNGs
    embedded in the manual. Exported STL geometry untouched (additions only).
2026-11-11 docs(hardware): document box component layout, wiring and protections
    Manual 52 gains chapter 6 bis: per-box grid/tray maps, gland maps,
    internal wiring lists, EMI filter/fuse/WAGO placement, inter-box and
    external cabling, and pre-power checks, with new to-scale layout,
    wiring, interconnection and protection diagrams.
2026-11-14 fix(sdr): keep the receiver header that says who we are
    settings.json is re-rendered on every install/update, which replaced the
    station presentation with a one-line generic text. The default header now
    presents the station and BricoHams with a link, texts edited in the admin
    panel are kept, and OWRX_PHOTO_TITLE/OWRX_PHOTO_DESC can pin them.
